jun1okamura/TR-1um_SCLK_SPI/design_notes.md

# TR-1um_SCLK_SPI 設計ノート

最終更新: 2026-09-07

---

## 1. 仕様

SCLKドメイン同期式の**3線式(半二重)SPIスレーブ**コア。既存の
[`TR-1um_I2C_2026`](../TR-1um_I2C_2026) / [`TR-1um_Async_I2C`](../TR-1um_Async_I2C)
と同一の外部データインタフェース(`DATA[7:0]`双方向共有パッド + `DIS` + `RSTN`)
を持ち、シリアルプロトコル層だけをI2C→SPIに置き換えた構成。

- **モード**: Mode 0 (CPOL=0 / CPHA=0)、MSBファースト
- **フレーム**: 8bit単発(CS↓ → SCLK×8 → CS↑)。コマンド/アドレスバイトなし、バーストなし
- **半二重**: MOSI/MISOは `SDIO` 1本に統合
- **方向決定**: `DIS`。同じピンが `DATA[7:0]` の方向も決めるため、R/Wビットもコマンドバイトも不要

| DIS | フレーム | SDIO | DATA[7:0] | 動作 |
|:---:|---|---|---|---|
| 0 | WRITE | 入力(マスタが駆動) | **チップが駆動** | 受信バイトを `rx_data` に確定しDATAへ出力 |
| 1 | READ | **チップが駆動**(CS=Low中) | 入力(`tx_data`) | DATAを取り込みSDIOへMSBから送出 |

---

## 2. ピン割り当て

`OSS_FRAME` は16パッド。VDD/VSSを除く信号パッドは14本(P8は存在しない)。
`RING_OSC` は搭載しない。

| パッド | 信号 | 方向 | 説明 |
|---|---|---|---|
| P1 | `SCLK` | 入力 | SPIクロック。本コア唯一のクロック源(`BUFTH`挿入) |
| P2 | `SDIO` | 双方向 | SPIデータ(半二重)。入力パスに`BUFTH` |
| P3 | `CS` | 入力 | チップセレクト(負論理)。フレーム境界を規定(`BUFTH`挿入) |
| P4 | `TEST` | 出力 | `byte_end` — フレーム第8ビット期間中High |
| P5 | `DIS` | 入力 | フレーム方向 + `DATA[7:0]`出力ディセーブル |
| P6 | `DATA[0]` | 双方向 | 汎用データ bit0 |
| P7 | `DATA[1]` | 双方向 | bit1 |
| P9〜P14 | `DATA[2..7]` | 双方向 | bit2〜bit7 |
| P15 | `RSTN` | 入力 | 非同期リセット(負論理) |

物理パッド番号の昇順とbit番号が単調対応(P6/P7=bit0-1、P9〜P14=bit2-7)。
チップレベルTB(`tb_12_chip`)でこの対応を1本ずつ検証済み。

---

## 3. アーキテクチャ

半二重化により**シフトレジスタが1本で済む**のが構成上の要点。

```
          +--- bit_cnt[2:0] (posedge SCLK, CS で非同期クリア)
          |
SCLK --+--+----------------------------------> rx_data ホールド (posedge SCLK)
       |                                             ^
       +--[XOR]--> shift_clk --> 共用シフトレジスタ sr[7:0]
       DIS ^                        |    ^
           |                        |    +--- tx_data[6:0] パラレルロード
           |                        +-------> SDIO 出力 (sr[7])
           +----------------------> msb_done (posedge shift_clk) --> MSB選択
```

- `shift_clk = SCLK ^ DIS`
  - WRITE(DIS=0): `posedge SCLK` — SDIOを取り込む
  - READ (DIS=1): `negedge SCLK` — Mode 0が要求する「立下りで出力更新」を満たす
  - `DIS` はフレーム中静止しているので、この選択がCS=Low中に切り替わることはない
- Mode 0 は最初の立上り前にMSBが確定している必要があり、その時点ではまだクロック
  エッジが存在しない。よって bit7 のみ `tx_data[7]` から出力し、bit6以降はシフト
  レジスタから出す(`sr` は最初の立下り、`bit_cnt==1` でパラレルロード)。
- **`msb_done`**: 上記のMSB選択を `(bit_cnt == 0)` で直接行うと、`bit_cnt` が変化する
  第1・第8**立上り**エッジでSDIOが動いてしまう(§4で検出した不具合)。選択信号を
  `shift_clk` で叩いたFFにすることで、SDIOの遷移を立下りエッジだけに閉じ込め、
  かつバイト境界ごとに再アームして複数バイト転送も維持している。追加コストは
  `DFFRB`×1 + `OR3`×1 − `NOR3`×1 ≈ **+28 Tr(+7等価ゲート)**。
- `bit_cnt` は `CS`=High で非同期クリアされるため、アイドル中にSCLKがフリーラン
  しても次フレームは必ずbit7から始まる。`sr` にゴミが入っても8エッジ後には正しい
  8ビットに置き換わるので無害 — この性質を使って `sr` のCSゲートを省いている。

---

## 4. 検証

I2C版と同じ2段階等価性検証を、変換後ネットリストまで拡張した**3ビュー**構成。
全テストベンチが同一ソースのまま3つのビューに対して実行される。

| ビュー | 対象 |
|---|---|
| RTL | `hdl/spi_slave_sclk.v` |
| NET | `layout/spi_slave_sclk_net.v`(Yosys/ABC合成直後) |
| PNR | `layout/spi_slave_sclk_net_pnr.v`(MUXDFFRB統合 + BUFTH + 行バッファ挿入後) |

```sh
scripts/run_tests.sh                      # 全12本 × 3ビュー
scripts/run_tests.sh tb_05_mode0          # 1本だけ
DUMP=1 scripts/run_tests.sh tb_05_mode0   # 波形(VCD)付き
```

### テストベンチ一覧

| # | ファイル | チェック数 | 内容 |
|---|---|---:|---|
| 01 | `tb_01_reset.v` | 11 | 電源投入時リセット、アイドル時パッド状態、アイドル中/フレーム途中/CS=Low中の非同期リセットと復帰 |
| 02 | `tb_02_write.v` | 20 | WRITEフレーム10パターン(コーナー/ウォーキング)を `rx_data` とDATAパッド両方で確認 |
| 03 | `tb_03_read.v` | 11 | READフレーム10パターン + READが `rx_data` を壊さないこと |
| 04 | `tb_04_bitorder.v` | 32 | MSBファースト検証。両方向のウォーキング1/ウォーキング0 |
| 05 | `tb_05_mode0.v` | 13 | Mode 0エッジ挙動。最初の立上り前のMSB確定、**全立上りエッジでのSDIO安定**、`tx_data` が第1立下りでラッチされ以降無視されること、MOSIが立上りだけでサンプルされること |
| 06 | `tb_06_tristate.v` | 13 | `DIS`×`CS` の全組合せでのSDIO/DATA駆動・Hi-Z、フレーム中の競合が無いこと |
| 07 | `tb_07_idle.v` | 9 | 20µsアイドル保持、SCLKフリーラン耐性、クロック無しCSパルス、5クロックの中断フレーム、9クロック過剰時の挙動と再同期 |
| 08 | `tb_08_multibyte.v` | 10 | CSを下げたままの3/8バイトWRITE、4バイトREAD、バイト間で `tx_data` を変えた場合の再サンプル |
| 09 | `tb_09_clockrate.v` | 16 | SCLK 100kHz〜20MHzのスイープ + デューティ5%/95%の非対称波形 |
| 10 | `tb_10_random.v` | 1 | 200トランザクションのランダム回帰(方向・データ・メッセージ長・アイドル間隔)をゴールデンモデルと照合 |
| 11 | `tb_11_spidev.v` | 20 | ラズパイ `spi-bcm2835` 3線モードのシーケンス再現。`writebytes`/`readbytes` 相当、DIS操作順序、W/R交互、**`xfer2()` 使用時に競合が起きることの負検証**と復帰 |
| 12 | `tb_12_chip.v` | 31 | チップレベル。実パッドP1〜P15を駆動し、DATA 8本のビット対応をワンホット走査で全数検証。TESTパッド、`BUFTH` 経路、P15リセット |
| | **合計** | **187** | **× 3ビュー = 561チェック / 36ラン、全PASS** |

共通のSPI Mode0マスタBFMとスコアボードは `hdl/spi_tb_common.vh`。双方向ネットを
そのままモデル化しているので、パッド競合はXとして検出される。

### 検出した不具合(修正済み)

`tb_05_mode0` が **SDIOが第1・第8の立上りエッジで変化する**Mode 0違反を検出。
`sdio_out` のMSB選択を `(bit_cnt == 0)` で直接行っていたため、`bit_cnt` が更新
される立上りエッジでSDIOが動いていた。マスタは立上りでサンプルするので読み値
自体は正しく、他の11本のテストベンチは全て通っていたが、マスタのホールド時間
マージンを `bit_cnt` のclk-to-Q分しか残さない設計だった。§3の `msb_done` FFを
追加して全遷移を立下りエッジに閉じ込め、解消。

---

## 5. ゲート規模(合成実測)

セル面積は `lef/TR-1um_STDCELL.lef` の **MACRO SIZE**(= 実際のフットプリント)、
トランジスタ数は `TR-1um_Async_I2C/LEF/<cell>.extracted` のMOS素子数
(`lef/cell_info.json`)。合成用Libertyはこの実面積で生成しているので
(`scripts/gen_liberty.py`)、ABCが本物のシリコン面積で最適化する。

> **1等価ゲート = `NAND2` = 4 Tr = 16.2 × 64.8 = 1,049.8 µm²**

⚠ セルのGDSバウンディングボックスはフットプリントではない。全セルが
prBoundaryからx方向に12.6 µm、y方向に4.0 µm はみ出す(隣接セルと重なる
ウェル/インプラント囲み)ため、GDS実測だと `INV_X1` が 1,610 µm² に見えるが
LEFの正は 700 µm²。面積系の数字はすべてLEF基準に統一してある。

### 工程ごとの推移

| 工程 | セル | Tr | 等価ゲート | 面積 (µm²) |
|---|---:|---:|---:|---:|
| 合成直後 (`_net.v`) | 49 | 796 | 199 | 135,768 |
| MUXDFFRB統合 (`_net_merged.v`) | 34 | 796 | 199 | 135,769 |
| **BUFTH+行バッファ (`_net_pnr.v`)** | **41** | **844** | **211** | **146,267** |

MUXDFFRB統合は `MUX2`+`DFFRB` の15ペアを統合(トランジスタ数不変、面積 −13,005 µm²)。
残る `MUX2`×1 は `sdio_out` のMSB選択で、DFFのDピンを駆動していないため対象外。

### 最終構成(配置配線投入時)

| セル | 個数 | Tr | 面積 (µm²) |
|---|---:|---:|---:|
| `MUXDFFRB` | 15 | 570 | 94,479 |
| `DFFRB` | 5 | 130 | 20,995 |
| `BUF_X2`(行バッファ) | 4 | 24 | 4,199 |
| `AND2_X1` | 3 | 18 | 4,199 |
| `BUFTH`(SCLK / SDIO / CS) | 3 | 24 | 6,298 |
| `INV_X1` | 2 | 4 | 1,400 |
| `NOR4` | 2 | 16 | 3,499 |
| `NAND2` | 2 | 8 | 2,100 |
| `XOR2` | 2 | 20 | 3,499 |
| `OR3` | 1 | 8 | 1,750 |
| `MUX2` | 1 | 12 | 2,100 |
| `XNOR2` | 1 | 10 | 1,750 |
| **合計** | **41** | **844** | **146,267** |

> この表は **option C(`sdio_oe_n` をアクティブLOW化)後の再合成**を反映した
> もの。`NOR2`×2 が消えて `NAND2`×2 / `AND2_X1`×3 になり、トランジスタが
> 842 → 844、等価ゲートが 210 → 211 に動いている(§16.6)。数字は
> `scripts/gate_count.py layout/spi_slave_sclk_net_pnr.v` の出力そのもの。

記憶素子 20個。行バッファは2行構成(§12)で、実配置で得た行割り当てを
`scripts/insert_row_buffers.py --row-assignment` に戻した2パス目の結果(§13.2)。

> ### 結論
> **等価ゲート 211 / トランジスタ 844 / 論理セル 41個 / 記憶素子 20個 /
> 論理セル面積 0.146 mm²**
>
> 配置配線まで完了した**実際のコア面積は 1,632.6 × 314.1 µm = 0.5128 mm²**
> (§14.4)。

---

## 6. I2C版との比較

| 項目 | SPI版 | I2C版(実測) | 比 |
|---|---:|---:|---:|
| 論理セル数 | 41 | 126 | 0.33 |
| 記憶素子数 | 20 | 36 | 0.56 |
| トランジスタ数 | 844 | 1,598 | 0.53 |
| **等価ゲート数** | **211** | 400 | 0.53 |
| 論理セル面積 | 0.146 mm² | 0.299 mm² | 0.49 |
| **配置配線後コア面積** | **0.5128 mm²** | 1.533 mm² | **0.33** |

いずれもLEFのMACRO SIZE基準。コア面積は両者とも実際の配置配線結果。

**約半分**に収まる。差分の内訳:

- SPIは `CS` がフレーム境界を明示するため、I2Cのプロトコル層 — START/STOP検出、
  ACK/NACK生成・応答、7bitアドレス比較器、スパイクフィルタ、SDAオープンドレイン
  制御 — が**まるごと不要**。I2C版で `NAND2` 23個・`NOR2` 14個を要したのはこの
  非同期プロトコル層。
- 半二重化により**シフトレジスタが1本で済む**(全二重ならRX/TXで2本必要)。
- I2C版が非同期(クロックレス)設計だったのに対し、SPI版は `SCLK` 単一ドメインの
  純同期設計。レース対策のための冗長な論理が不要。

---

## 7. 見積もり履歴

| 版 | 構成 | 等価ゲート | Tr | 根拠 |
|---|---|---:|---:|---|
| 初版 | I2C同等I/F、コマンド+データ2バイト | 約 400 | — | 汎用的な机上見積もり |
| 2版 | 全二重、8bit単発、`DATA`+`DIS` | 約 270 | 1,070 | I2C実チップのセル実測でキャリブレーション |
| 3版 | 半二重3線 | 約 210 | 834 | RTL机上構成 |
| 4版 | 半二重3線 + Mode0修正 + BUFTH/行バッファ(4行) | 212 | 850 | 合成〜P&R投入ネットリストの実測値 |
| 5版 | 同左、2行構成 + `BUF_X2` | 210 | 842 | 配置配線まで完了(option C 前) |
| **確定** | **同左 + `sdio_oe_n` アクティブLOW化(option C)** | **211** | **844** | **§16.6 で再合成した最終ネットリスト** |

---

## 8. 設計上の注意点

- **`DIS` はCS=Low中に変化させてはならない。** `shift_clk = SCLK ^ DIS` のため、
  フレーム途中で `DIS` が変わるとシフトレジスタのクロックにグリッチが乗る。
  CS=High中の変化は無害。
- **READ時の `tx_data`(DATAピン入力)はフレーム中に安定していること。**
  bit7 のみ組合せ経路で出力するため、CS↓から最初の立下りまでの間に `tx_data[7]`
  が変化すると誤ったMSBが出る(`tb_05_mode0` で検証)。
- **クロックネットは2本**(`SCLK` と `shift_clk`)。AP&R時の行分配は両系統に必要。
  現状の暫定ネットリストでは各4行 = `BUF_X1`×8。
- `BUFTH` は `SCLK` / `SDIO`(入力パス) / `CS` に挿入(`scripts/insert_bufth.py`)。
- `CS` は `SCLK` に対して非同期。`bit_cnt` の非同期クリアに使い、ロードおよび
  `rx_data` 更新自体はSCLKエッジで行う。最終SCLKエッジからCS↑までのホールド時間は
  実機仕様として規定が必要。
- `TEST`(P4)の `byte_end` は `bit_cnt` のデコード出力なので、カウンタ遷移時に
  短いグリッチが乗りうる。オシロでのフレーム確認用途に限る。
- Liberty はプレースホルダ。**面積・ゲート規模の見積もり専用**であり、タイミング
  値はダミーなのでSTAには使えない。

---

## 9. ディレクトリ構成

| ディレクトリ | 内容 |
|---|---|
| `hdl/` | コアRTL、チップトップ、セルモデル、共通BFM(`spi_tb_common.vh`)、テストベンチ12本 |
| `lef/` | `TR-1um_STDCELL.gds` / `.lef`(TR-1um_Async_I2Cからコピー)、`TR1um_5_stdcell.lib`(I2C版参照用)、`TR1um_5_stdcell_area.lib`(実面積版、生成物)、`cell_info.json` |
| `layout/` | 合成後NET、各変換段のNET、`synth.ys`(生成物)、以降の配置配線中間成果 |
| `irsim/` | IRSIM検証(未着手) |
| `scripts/` | 合成・ネットリスト変換・規模レポート・検証実行。詳細は [`scripts/SCRIPTS.md`](scripts/SCRIPTS.md) |
| `src/` | **TO(テープアウト)提出用** `tr_1um_3wire_SPI.gds` / `.cir` |
| `docs/` | `info.md` データシート、チップ画像 |

```sh
scripts/build.sh        # 合成 → MUXDFFRB統合 → BUFTH → 行バッファ → 規模レポート
scripts/run_tests.sh    # 全テストベンチ × 全ビュー
```

---

## 10. Raspberry Pi からの接続(Pi 4以前 / チップ3V動作)

### 10.1 ラズパイ側の3線SPI対応状況

`raspberrypi/linux` の `rpi-6.12.y` のドライバソースで確認(2026-09時点)。

| モデル | SPIコントローラ / ドライバ | `SPI_3WIRE` |
|---|---|---|
| **Pi 4 / 3 / Zero など(BCM2835〜BCM2711)** | SPI0 / `spi-bcm2835` | **対応** |
| Pi 5 (RP1) | `snps,dw-apb-ssi` / `spi-dw` | 非対応 |

- `spi-bcm2835.c`: `BCM2835_SPI_MODE_BITS = (SPI_CPOL｜SPI_CPHA｜SPI_CS_HIGH｜SPI_NO_CS｜SPI_3WIRE)`
- 双方向モードでは **MOSIピン(GPIO10 / ヘッダ19番)が MOMI**(単線データ)として
  働き、MISO(GPIO9)は未使用。受信時にドライバがCSレジスタの **REN** ビットを
  立てて送信ドライバをHi-Zにする。
- **制約**: `spi_transfer` の `tx_buf` と `rx_buf` は一方が必ず NULL でなければ
  ならない。`spidev_test.c` がこれを守らず3線モードで失敗するのは既知。
  → **本チップは `DIS` がフレーム方向を決めるため、この制約に完全に合致する。**

| | DIS | spidev | REN | 線の駆動 |
|---|:---:|---|:---:|---|
| WRITE | 0 | `writebytes()` | 0 | ラズパイのMOSIが駆動 |
| READ | 1 | `readbytes()` | 1 | MOSIはHi-Z、チップが駆動 |

DMA有効時に3線が壊れる不具合が2019年にあったが(`spi_map_msg()` がNULLの
`rx_buf` をダミーバッファに置換するため)、`master->dummy_rx` を除外する修正が
4.14以降のstableにバックポート済み。

### 10.2 結線 — レベル変換は不要

チップを**3V系で動かせるため、レベル変換器は一切不要**。

> **最も安全な構成: チップの VDD をラズパイの 3.3V レール(ヘッダ1番/17番)から
> 給電する。** 両者が同一電位になるので、入出力とも直結でよい。

チップを3.0Vなど3.3Vより低い電圧で動かす場合の注意:

- **ラズパイ → チップ**: 3.3V出力がVDD(3.0V)を0.3V超える。ESD保護ダイオードの
  順方向電圧(約0.6V)には届かないので通常は問題ないが、マージンを取るなら
  ラズパイ側出力に直列1kΩを入れる。
- **チップ → ラズパイ**: 3.0V出力はBCM2835のVIH(約2.3V)を十分上回るので問題なし。

| ラズパイ | ヘッダ | チップ | 備考 |
|---|---|---|---|
| GPIO11 / SCLK | 23 | P1 `SCLK` | |
| GPIO10 / MOSI(**MOMI**) | 19 | P2 `SDIO` | 3線モードではここが単線データ |
| GPIO9 / MISO | 21 | — | 3線モードでは**未使用** |
| GPIO8 / CE0 | 24 | P3 `CS` | spidevがフレーム毎にアサート |
| 任意GPIO(入力) | — | P4 `TEST` | デバッグ用、省略可 |
| 任意GPIO(出力) | — | P5 `DIS` | ioctlの前に設定 |
| 任意GPIO ×8 | — | P6,P7,P9〜P14 `DATA[7:0]` | WRITE時は入力設定、READ時は出力設定 |
| 任意GPIO(出力) | — | P15 `RSTN` | |
| 3.3V | 1 / 17 | VDD | |
| GND | 6 / 9 / … | VSS | 複数点で接続 |

- `SDIO` に弱プルダウン(100kΩ程度)を入れ、`DIS`=1 かつ `CS`=High で誰も駆動
  しない期間のフローティングを避ける
- 必要GPIOは14本。40ピンヘッダで十分足りる

### 10.3 spidev からの操作

```python
import spidev
from gpiozero import DigitalOutputDevice

spi = spidev.SpiDev(); spi.open(0, 0)
spi.mode          = 0b00       # Mode 0
spi.bits_per_word = 8
spi.threewire     = True       # SPI_3WIRE (Pi 4以前のみ)
spi.max_speed_hz  = 100_000    # まず低速から

dis = DigitalOutputDevice(<GPIO>)

# WRITE : DIS=0 にしてから 1バイト送る -> DATA[7:0] に出る
dis.off(); spi.writebytes([0xA5])

# READ  : DIS=1 にしてから 1バイト読む <- DATA[7:0] の値が返る
dis.on();  val = spi.readbytes(1)[0]
```

- `writebytes` / `readbytes` はそれぞれ片方向の `spi_transfer` になるため、
  3線モードの tx/rx NULL 制約を自然に満たす。**`xfer` / `xfer2`(全二重)は
  使わないこと** — 使うとREADフレーム中にマスタがSDIOを駆動してチップと競合する
  (`tb_11_spidev` の負検証で確認済み)。
- `DIS` の変更は `CS` がHighの間に行う(§8)。ioctlの前後でGPIOを操作すれば
  この順序は自然に守られる。
- CE0 は1バイト転送につき8クロック分だけLowになり、フレーム定義と一致する。

### 10.4 複数バイト転送(CSを下げたまま)

spidev に2バイト以上渡すと `CS` を下げたまま 8N クロックが出る。本設計は
`bit_cnt` がラップして次フレームに入るため正しく動作する(`tb_08_multibyte`)。

| 操作 | 結果 |
|---|---|
| CS Lowのまま3バイトWRITE `11 22 33` | `rx_data` = 最後のバイト `0x33` |
| CS Lowのまま4バイトREAD | 全バイトとも `tx_data` の値(フレームごとに再サンプル) |
| バイト間で `tx_data` を変更 | 次バイトから新しい値が出る |

### 10.5 クロック速度

1µmプロセス・3V動作なので **100kHz程度から始めて段階的に上げる**。参考として
I2C版チップのリング発振器実測は5V時に97段で6.5MHz(段遅延 ≒ 0.79ns)。3V動作では
これより遅くなる。BCM2835 のSPIクロックは分周比が2の冪なので、`max_speed_hz` の
設定値そのままにはならない。RTLは100kHz〜20MHzで検証済み(`tb_09_clockrate`)。

---

## 11. STDCELLへの追加提案

> 優先度1の `BUF_X2` は 2026-09-07 に実装済み。実測結果は §12.1 参照。

現行の `TR1um_5_stdcell` は論理セル25種(`INV_X1` `BUF_X1` `BUFTH` `AND2/3/4_X1`
`OR2/3/4` `NAND2/3/4` `NOR2/3/4` `XOR2` `XNOR2` `MUX2` `DEL1/2/4` `DFFRB` `DFFS`
`RSLATCH` `MUXDFFRB`)。本設計の合成結果から、以下を優先度順に提案する。

### 優先度1: `BUF_X2` / `BUF_X4` / `INV_X2` / `INV_X4` — ドライブ強度の系列

**現行ライブラリにはX1しか無い。** 本設計はクロックネットが2本(`SCLK` と
`shift_clk`)あり、各行の `MUXDFFRB` のCKピン群と長いM2配線を `BUF_X1`(4 Tr)
1個で駆動することになる。1µm・3V動作ではこれが**最大SCLK周波数と行間スキューを
直接律速する**。X2/X4があれば1行1段で済み、バッファ段数と行間スキューの両方が
減る。面積コストも小さい(X2で+2〜4 Tr程度)。

**本チップで最も効く追加。** AP&R前に用意できるのが理想。

### 優先度2: `DFFRB_Q` / `MUXDFFRB_Q` — QB出力を持たないFF

合成結果を実測したところ、**20個のFFのうち17個で `QB` がどこにも接続されていない**。
QB用の出力インバータを削ったバリアントを用意すれば、1個あたり約2 Tr・幅5µm程度
(≒371 µm²)が浮く。17個で **約6,300 µm²、コア面積の約3%、等価ゲート換算で約8ゲート**
の削減。既存セルからインバータを1段落とすだけなので、設計コストも低い。

### 優先度3: `NAND2B` / `NOR2B` — 片側入力反転の2入力ゲート

`NAND2`/`NOR2` と同じ4 Trで、片方の入力だけがバブル付き。**実測**: これらを
Libertyに追加して再合成したところ、ABCが `NOR2B` を4個使い、
セル 34→33個、Tr 794→788、面積 173,244→170,890 µm²(−1.4%)になった。
本設計では小幅だが、追加コストがゼロ(同じトランジスタ数)なので入れて損はない。

### 優先度4: `AOI21` / `OAI21` / `AOI22` / `OAI22` — 複合ゲート

**現行ライブラリには複合ゲートが1つも無い。** これはCMOS標準セルライブラリとしては
大きな欠落で、ABCの技術マッピングが本来最も得意とする形が使えていない。
`AOI21`(6 Tr)は `AND2_X1`+`NOR2`(10 Tr)を置き換える。

ただし**本設計での実測利得はゼロだった** — 組合せ論理が11セルしかなく、ABCは
`NOR2B` の方を選んだ。効いてくるのは組合せ論理を持つ将来の設計(ALU、比較器、
カウンタチェーン等)。**今回のテープアウトのためというより、ライブラリ整備として**
の提案。

### 優先度5: `XOR2_CLK`(または `CLKMUX2`) — クロック経路用

本設計は `sclk ^ dis` を**クロック経路に置いている**。汎用 `XOR2` はA→YとB→Yの
遅延が非対称で、立上り/立下り遅延も揃っていないため、`shift_clk` のデューティ
歪みになって現れ、最大SCLKを制限する。入力間で遅延を揃え、ドライブを上げた
クロック用XOR(または等価なクロックMUX)があると素直。

### 優先度6: `TIEHI` / `TIELO`

未使用入力を電源レールに直結せずに固定するための標準セル。I2C版では
`add_hiz_vss_ties_v9.py` でレイアウト側に処理を寄せているが、セルがあれば
ネットリスト段階で扱えてアンテナ/ESD上も素直になる。

---

## 12. 配置 — 行数の検討

### 12.1 BUF_X2(2026-09-07 実装)

`lef/TR-1um_STDCELL.gds` に追加された `BUF_X2` をGDSから実測:

| | フットプリント | 段構成 | PMOS 合計W | NMOS 合計W | Tr |
|---|---|---|---:|---:|---:|
| `BUF_X1` | 16.2 × 64.8 µm | 10.2/3.4 → 10.2/3.4 | 20.4 µm | 6.8 µm | 4 |
| `BUF_X2` | 16.2 × 64.8 µm | 10.2/3.4 → **10.2/3.4 ×2並列** | 30.6 µm | 10.2 µm | 6 |

出力段が2フィンガ並列になり **W が2倍**。**フットプリントは `BUF_X1` と同一**
なので、行バッファを `BUF_X2` に置き換えても面積は1セルも増えない。
`scripts/build.sh` の既定を `ROW_BUF_CELL=BUF_X2` にした。
`BUF_X4` / `BUF_X16` はLEFには登録済みだがGDSには未実装。

### 12.2 行数の比較

行幅を **I2C版と同じ 1620 µm に固定**して検討した(GIO⇔コアの結線枠組みを
I2C版からそのまま引き継げるため)。`scripts/explore_rows.py --row-width 1620`。

セル総幅は 2,251.8 µm(2行構成のネットリスト)なので、**1行(1,620 µm)には
入らず、2行が最小**。行幅を固定すると余りはFILLになるだけなので、行数を
増やすほど面積は単調に悪化する:

| 行数 | 行容量 | セル総幅 | コア W×H | 面積 | 備考 |
|---:|---:|---:|---|---:|---|
| 1 | 1,620 µm | 2,251.8 µm | — | — | **入らない** |
| **2** | **3,240 µm** | **2,251.8 µm** | **1,620 × 254 µm** | **0.411 mm²** | **採用** |
| 3 | 4,860 µm | 2,284.2 µm | 1,620 × 351 µm | 0.569 mm² | 分割すると3行目が空になる |

3行を指定しても、分割器は行容量に余裕があるため実質2行に詰めてしまう
(3行目の占有率0%)。**2行で決まり。**

#### 2行構成の詳細

行内の配分は2通り比較した(コア高さはどちらも 254 µm で同じ):

| | 行0 / 行1 の幅 | 占有率 | チャネル(トラック) | 最大チャネル |
|---|---|---|---|---:|
| バランス配置(推奨) | 961.2 / 1,290.6 µm | 59% / 80% | 7 / 6 / 10 | **10 trk** |
| 詰め込み配置 | 1,555.2 / 696.6 µm | 96% / 43% | 13 / 6 / 4 | 13 trk |

**バランス配置を推奨。** 面積は同じで最大チャネルが 13→10 トラックに減り、
かつ各行に 300〜650 µm の空きが残るのでルータのジョグ・フィードスルーに
余裕ができる(占有率96%の行は逃げ場が無い)。

- コア: **1,620 × 254 µm = 0.411 mm²**(行 2×64.8 = 129.6 µm + チャネル
  38 / 32 / 54 µm)
- I2C版コア 1,632.6 × 938.9 = 1.533 mm² の **27%**。**幅が一致する**ので
  GIO⇔コアの結線・電源メッシュの枠組みをそのまま流用できる
- FILL 必要量は計 988 µm 分(≒ 64,000 µm²)
- アスペクト比 6.4:1 と扁平。2.5×2.5 mm フレーム内では上下に大きく空きが
  出るので、ロゴ等の配置余地は十分

#### ⚠ クロック分配の確認事項

2行構成では、1つの行バッファが**最大 1.29 mm の行全体**のFFクロックピンを
駆動する。ざっくり見積もると M2 配線容量が 6個のCKゲート容量と同等かそれ
以上になり、**クロック枝は配線容量支配**になる。`BUF_X2`(出力段
W=20.4/6.8 µm)で足りるかはレイアウト抽出後のSPICEで確認すべき項目。
足りなければLEFに登録済みの `BUF_X4` を実装するのが素直
(フットプリントが `BUF_X1` と同じなら面積増もゼロ)。

### 12.3 現状のP&R投入ネットリスト

`layout/spi_slave_sclk_net_pnr.v` — **41セル / 844 Tr / 211等価ゲート /
論理セル面積 0.146 mm²**、`BUFTH`×3 + `BUF_X2`×4(2行 × クロック2系統)。
全36テストランPASS済み。`scripts/build.sh` の既定は `ROWS=2`。

行バッファの配分は現状「シンクを2等分」の暫定値。実配置で行割り当てJSONが
得られたら次で入れ直す:

```sh
scripts/insert_row_buffers.py layout/spi_slave_sclk_net_bufth.v \
    layout/spi_slave_sclk_net_pnr.v --nets sclk_buf,shift_clk \
    --cell BUF_X2 --row-assignment layout/row_assignment.json
scripts/run_tests.sh
```

---

## 13. 配置(Placement)

`scripts/place.py`。配置規約はI2C実チップのGDS
(`TR-1um_I2C_2026/src/tr_1um_i2c_slave_async.gds`)を解析して実測した:

- セルは **prBoundary(レイヤ235/0、全セルで 0..W × 0..64.8)でアバット**。
  GDSのbboxはprBoundaryからx方向に12.6µm、y方向に4.0µmはみ出す(隣接セルと
  重なるウェル/インプラント囲み)ので、配置座標はprBoundary基準
- 全参照が **回転0・反転なし**。行のミラーリングはしない
- 各行は **x=0 から行幅ちょうどまで隙間なく充填**
- **TAP2 は x = 0 / 534.6 / 1069.2 / 行幅−10.8** の固定位置(ピッチ534.6µm)
- 残りは FILL3(16.2)/ FILL2(10.8)で埋める。**FILLは行内に分散配置**
  (ルータのフィードスルー・ジョグ用の隙間を確保するため)

FILL2/FILL3 では 5.4µm ちょうどの隙間だけが作れないため、配置器はセルを
セグメントに詰める際「残りが 5.4µm になる置き方」を避けて次セグメントへ送る。

### 13.1 STEP構成(各STEPのGDSを残す)

| STEP | 内容 | 成果物 |
|---|---|---|
| step1 | 行割り当て(FM分割)。セルをx=0からアバット | `layout/step1/place_step1_rows.gds` / `.json` |
| step2 | 行内順序最適化(バリセンタ反復、HPWL評価) | `layout/step2/place_step2_ordered.gds` / `.json` |
| step3 | TAP2挿入。セルをTAPセグメントに詰める | `layout/step3/place_step3_tap.gds` / `.json` |
| step4 | FILL分散挿入で行幅を厳密に1620µmへ(**最終**) | `layout/step4/place_step4_fill.gds` / `.json` |

`layout/placement_steps.png` に4STEPの可視化(目視確認用)。

### 13.2 2パス実行

行バッファは最初「シンクをN等分」で入れてあるため、1パス目の配置で得た
実際の行割り当てで入れ直し、2パス目を回す(I2C版 `design_notes.md` §40 と
同じ考え方)。

```sh
scripts/place.py                                    # 1パス目
scripts/insert_row_buffers.py layout/spi_slave_sclk_net_bufth.v \
    layout/spi_slave_sclk_net_pnr.v --nets sclk_buf,shift_clk \
    --cell BUF_X2 --row-assignment layout/row_assignment.json
scripts/run_tests.sh                                # 等価性再確認(36ラン)
scripts/place.py                                    # 2パス目
scripts/verify_placement.py
```

2パス目でチャネル交差が [11,6,6] → [10,5,7]、コア高さが 286.2 → **280.8 µm**
に改善した。

### 13.3 結果

| | |
|---|---|
| コア | **1,620.0 × 280.8 µm = 0.4549 mm²** |
| 行 | 2行 × 64.8 µm、y = 64.8 / 167.4 |
| チャネル | 12 / 7 / 9 トラック = 64.8 / 37.8 / 48.6 µm(ガード2トラック込み) |
| 行0 | 論理セル21個 1,026.0 µm (63.3%) + TAP 43.2 + FILL 550.8 |
| 行1 | 論理セル20個 1,225.8 µm (75.7%) + TAP 43.2 + FILL 351.0 |
| HPWL | 12,255 µm(step1の21,597 µmから43.3%改善) |
| GDS実寸 | 1,632.6 × 280.8 µm(**I2C版コアの幅1,632.6 µmと一致**) |

`scripts/verify_placement.py` の全チェックPASS:
インスタンス被覆(41個、過不足・重複なし)、行内アバット(重なり・隙間ゼロ)、
5.4µmトラックグリッド整合、行幅厳密一致、TAP位置、行のy重なりなし、
GDS参照数(107)と実寸の突き合わせ。

I2C版コア(1,632.6 × 938.9 = 1.533 mm²)の **29.7%**。幅が一致するので
GIO⇔コアの結線・電源メッシュの枠組みをそのまま流用できる。

---

## 14. 配線(Routing)

I2C版(`TR-1um_Async_I2C/script/`)のフローをそのまま使う。あちらは実機
KLayoutでチップ全体DRC/LVSクリーン、SPICEトランジスタレベル検証14/14 PASS
まで到達しているので、**アルゴリズムには一切手を入れない**方針とした。
移植の詳細は [`scripts/PORTING.md`](scripts/PORTING.md)。

- `scripts/i2c_ref/` … I2C版からの**無改変**コピー(23本、参照用)
- `scripts/*.py` … `scripts/port_i2c_scripts.py` が生成する本プロジェクト版
- 変更は全て置換ルールとして `port_i2c_scripts.py` に記述(直接編集しない)

変更したのは (1) ハードコードされた絶対パス → `scripts/spi_config.py` 経由、
(2) トップセル名、(3) `LEF/` → `lef/`、(4) `route_top_pins_nrow_fm.py` の
4行決め打ちをN行に一般化(`n_rows == 4` では原本と完全に同一挙動)の4点のみ。

配置JSONは `scripts/gen_placement_json.py` が `place.py` の step4 出力を
ルータのスキーマ(LEFピン矩形の絶対座標化 + ネット解決)に変換する。
TAP直後のFILL2を `FILLPRI_*` と命名して優先M2コリドーに指定している。

### 14.1 ステージ構成(各STEPのGDSを残す)

| STEP | 内容 | 成果物 |
|---|---|---|
| step5 | 配置GDS + チャネル注釈 | `layout/step5/route_step_1_placement.gds` |
| step6 | チャネル配線。ルータ内部の5パスも各々GDS化 | `layout/step6/route_step_2_{1_tap_power_mesh,2_pass0_per_row_local,3_pass1_high_fo_row_only_adjacent,4_pass2_spanning,5_pass3_force_jog_nets,routed_raw}.gds` |
| step7 | 短絡のリップアップ/再配線 | `layout/step7/route_step_3_ripup_reroute.gds` |
| step8 | トップレベルピンのコア端引き出し | `layout/step8/route_step_4_top_pins.gds` |
| step9 | VDD/GND チップレベルピン | `layout/step9/route_step_5_power_pins.gds` |
| step10 | チャネル圧縮(未使用トラック除去) | `layout/step10/route_step_6_squeezed.gds` |

```sh
scripts/gen_placement_json.py
scripts/route.py                    # step5〜step10 + DRC/接続性チェック
scripts/plot_layout.py layout/step10/route_step_6_squeezed.gds
```

`layout/routing_steps.png` に可視化。

### 14.2 チャネル予算

ルータのジョグ機構は行またぎ1本ごとに新しいトラックを確保するため、
`place.py` のネット交差数ベースの見積もり(12/7/9トラック)では足りず、
最初の試行はチャネル1で溢れた。I2C版と同じく**広めに取って配線し、
step10で圧縮する**方式にした(`spi_config.py` の `ROUTE_CH_HEIGHTS`)。

| | 配線時の予算 | 使用 | 圧縮後 |
|---|---:|---:|---:|
| channel0(下マージン) | 140.0 µm (26 trk) | 8 trk | 42.8 µm |
| channel1(行間) | 900.0 µm (166 trk) | 25 trk | 138.6 µm |
| channel2(上マージン) | 160.0 µm (29 trk) | 3 trk | 22.6 µm(PIN保護分+3.0) |
| **コア高さ** | **1,329.6 µm** | | **314.1 µm(−76.4%)** |

### 14.3 squeeze の PINレイヤ保護

`squeeze_channels_nrow_fm.py` は配線が使っていないYスライスを削除するが、
原本のままだと**トップ辺のPINマーカーも巻き添えで消える**。マーカーはコア
境界のちょうど上に描かれるため「最後に使われたトラックより上のヘッドルームを
潰す」規則に当たり、高さ0になっていた(下辺のマーカーはy=0からコア内側へ
描かれるので無傷)。ラベルもピン形状から外れ、`gen_lef.py` / LVS抽出の
「PIN形状の内側にテキストラベルがある」規約が壊れる。18個が該当した。

`build_y_map` に**保護Y区間**を追加して解決した(`scripts/port_rules.py` の
`SQUEEZE_PIN_PROTECT`)。トップセル自身のPINレイヤ(48/1, 49/1)とテキスト
レイヤ(48/0, 49/0)が占めるY区間を収集・マージし、潰し処理がそこに重なる
部分だけ identity のまま残す。`protect_y` が空なら原本と完全に同一の挙動。

```
protecting 2 Y interval(s) holding PIN markers/labels: 0.0-3.0, 1326.6-1329.6
core height: 1329.6 um -> 314.1 um (-1015.5 um, -76.4%)
```

保護分の3.0 µmだけコアが高くなる(311.1 → 314.1 µm)。検証結果:
PINマーカーは**全32個が 3.0 × 3.0 µm**、潰れたもの0、
どのPIN形状にも入っていない/中心からずれているラベル**0**。

### 14.4 結果

| | |
|---|---|
| **最終GDS** | `layout/step10/route_step_6_squeezed.gds` |
| **コア** | **1,632.6 × 314.1 µm = 0.5128 mm²** |
| DRC | **0違反**(M1/M2の幅・間隔、V1の間隔・M1/M2囲み・GC間隔)。実機KLayoutでもANT(アンテナ)以外の指摘なし |
| 接続性 | **全44ネット160ピン 接続OK・短絡0**(M1優先M2フォールバック検証) |
| 配線内訳 | row-only 34、adjacent-pair 4、spanning 0、high-FO 3、per-row-local 3 |
| ジョグ | 14(強制オーバーラップゾーン)、行またぎ0、spanning 0 |
| リップアップ | 生の配線結果が既に短絡0だったため実質何もせず通過 |
| 優先M2コリドー | 6トラック(x = 13.5 / 18.9 / 548.1 / 553.5 / 1082.7 / 1088.1) |
| TAP電源メッシュ | 4列 × 3チャネル × 2ネット(VDD/GND) |
| トップピン | **25ポート全て引き出し・セルピンまで接続確認済み**(§14.5)。12本が下端、13本が上端。PINマーカーは全て 3.0 × 3.0 µm 正方形、TXM2ラベルは中心 |

I2C版コア(1,632.6 × 938.9 = 1.533 mm²)の **35%**。幅が一致するので
GIO⇔コアの結線枠組みをそのまま流用できる。

**生の配線結果でいきなり短絡0・DRC0違反**だったのは、I2C版が多数の
`PER_ROW_LOCAL_NETS` / `FORCE_JOG_NETS` の個別チューニングを要したのと
対照的。本設計は spanning ネットが0(全76ネット中48が行内で閉じ、
クロック2系統は行バッファで行ローカル化済み)であることが効いている。
指定した `PER_ROW_LOCAL_NETS` は `sclk_buf` / `shift_clk` / `cs_n_buf` の
3本のみ、`FORCE_JOG_NETS` は空。

### 14.5 スカラーポート未引き出しの修正(解決済み)

**症状**: 最終レイアウトで `BUFTH` の入力が配線されていない。調べると
BUFTH に限らず、**スカラーのトップレベルポート9本がまるごと引き出されて
いなかった**(バス16本のみ通っていた)。`sclk` / `cs_n` / `sdio_in` は
`u_bufth_*` の A ピンのネットなので、BUFTH入力の未配線はその一部だった。

**原因**: `scripts/highlight_top_pins_nrow_fm.py`(`route_top_pins_nrow_fm.py`
の `gather_pins` が使う)に**I2C設計のポート名が直書き**されていた。

```python
SCALAR_PORTS = ["rst_n", "scl", "sda_in", "sda_oe", "rx_valid",
                "addr_match", "rw", "busy"]
BUS_PORTS    = {"tx_data": 8, "rx_data": 8}
```

`gather_pins` はこの2つに載っているポートしか探さない。本設計のスカラー
ポート名は1つも含まれず、`BUS_PORTS` だけがたまたま一致していたため
「バスだけ通る」症状になった。移植時に**行数**依存は一般化したが、
**ポート名**依存を見落としていた。

**修正**: `port_rules.py` の `HIGHLIGHT_PORTS_FROM_NETLIST` で、この4つを
**ネットリストのポート宣言から導出**するよう置き換えた(`PORTING.md` §5)。
`assign port = net;` の別名も拾う — スカラーは `netlist_parser` の union-find
リゾルバが解決するが、バスの別名はビットごとの展開が必要なので
`BUS_PORT_NET_ALIAS` に入れる(本設計の `assign rx_data = rx_data_r;` が
まさにこれで、I2C版と同じ形だったのが「バスだけ通った」理由でもある)。
ポート方向 `PORT_DIR` も同じ宣言から導出するようにし、`route.py` の
手書きテーブルを廃止した。

導出結果:

```
SCALAR_PORTS      : byte_end, cs_n, data_oe, dis, rstn, sclk, sdio_in, sdio_oe, sdio_out
BUS_PORTS         : rx_data 8, tx_data 8
BUS_PORT_NET_ALIAS: rx_data -> rx_data_r
```

**再発防止**: 既存の `verify_connectivity_nrow_fm*.py` は**チャネルルータが
記録した44ネットしか見ておらず、スタブ30本(ポート→セルピン1本)が死角**
だった。これがこの不具合が最終GDSまで残った理由なので、
`scripts/verify_port_connectivity.py` を追加した。M1+M2をV1で繋いだ連結成分を
実ジオメトリから作り、各ポートのPINマーカーとそのネットのセルピンが同じ成分に
あることを確認する。`route.py` が step8 直後と step10 の後に自動実行する。

**結果**(再P&R後):

```
step8: 25ポート中12本が下端へ、13本が上端へ引き出し
       ports expected : 25 / pin labels : 27 (VDD/GND込み) / OK
step10: ALL 25 TOP-LEVEL PORTS CONNECTED TO THEIR CELL PINS
        cs_n     -> u_bufth_cs_n.A
        sclk     -> u_bufth_sclk.A
        sdio_in  -> u_bufth_sdio_in.A
```

### 14.6 STDCELL 利用リストと、そこで見つかった2件

`scripts/cell_usage.py` が最終配置から生成する
([`docs/cell_usage.md`](docs/cell_usage.md))。ライブラリ31マクロ中
**使用16種 / 未使用15種**、論理セル41個・844 Tr・146,267 µm²、
物理セル(TAP/FILL)67個・64,035 µm²。

このリストを最終GDSと突き合わせて2件の不具合が出た。

#### (1) LEF の FOREIGN が古く、BUF_X2 の図形が入っていなかった

```
MACRO BUF_X2
    FOREIGN BUF_X1 0.0 0.0 ;
```

`gen_placement_gds_nrow_fm.py` は `macros[type]["foreign"]` で物理セルを
選ぶため、**ネットリストは `BUF_X2` ×4 なのにレイアウトには `BUF_X1` の
図形**が置かれていた。フットプリントが同一なので配置もDRCも配線も何も
気づかず、**LVSで初めて落ちる**類の不具合。`BUF_X2` をGDSに追加した時点で
LEF側が追従していなかった。

`lef/TR-1um_STDCELL.lef` の該当行を修正。`sync_cell_info.py` に
「FOREIGN が MACRO 名と違う」「MACRO に対応するGDSセルが無い」を警告する
チェックを追加した。

> **`BUF_X4` / `BUF_X16` は LEF に MACRO があるのに GDS にセルが無い。**
> 使うと黙って `BUF_X1` になる。実装するかLEFから外すこと。

#### (2) BUF_X2 セル自体のM1間隔違反

FOREIGN を直して `BUF_X2` が本当にレイアウトに入った結果、M1間隔違反が
4件(4インスタンス各1件)出た。セル単体でも再現:

```
BUF_X2: M1 space 1.300 um < 1.400 um  at (x=2.35, y=37.15) cell-local
```

**先に「DRCクリーン」だったのは、(1)のせいで `BUF_X2` の図形が一度も
チップに入っていなかったから**で、このセルは実質DRCを通ったことが
なかった。セル修正後は29セル全てクリーン。

再発防止に `scripts/drc_check_cells.py` を追加した。STDCELLの全セルに
単体でDRC(M1/M2の幅・間隔、V1の間隔・囲み)をかける。**GDSを触ったら回す。**

```sh
scripts/drc_check_cells.py            # 全セル
scripts/drc_check_cells.py BUF_X2     # 1セルだけ
```

修正後の再P&R結果: **DRC 0違反、全ネット接続・短絡0、25ポート全て
セルピンまで接続確認済み、配置とGDSのセル構成が完全一致、`BUF_X2` ×4 が
レイアウトに存在**。

> **§14 の数値は §16.6 の再合成後(`sdio_oe_n` 版)の実測値に更新してある。**
> セル数41は同じ、トランジスタ 842→844、コア高さ 324.9→314.1 µm。

---

## 15. LVS用ネットリスト

実機KLayoutのLVSに渡す**参照回路(schematic側)**を用意した。原則はI2C版と
同じで、**手書きしない**。LVSが照合する相手は「機能検証済みのゲートレベル
NET」でなければ意味がないので、P&Rが実際に食べた
`layout/spi_slave_sclk_net_pnr.v` から機械的に生成する。

```
layout/spi_slave_sclk_net_pnr.v   ゲートレベルNET(配置配線に使ったもの)
lef/TR-1um_STDCELL.spice          セルのトランジスタ実体
layout/placement_nrow_fm.json     FILL2/FILL3 の実配置数
        ↓ scripts/gen_lvs_spice.py
layout/spi_slave_sclk_nrow_fm.spice
```

### 15.1 セルのトランジスタ実体をどこから取るか

I2C版 `gen_lvs_spice_v10.py` はセル実体を `~/.xschem/simulations/` から
読んでいた。ここはリポジトリ外で本プロジェクトからは参照できない。代わりに

```
TR-1um_I2C_2026/src/tr_1um_i2c_slave_async.cir
```

の各 `.subckt` ブロックを**そのまま**抜き出す。これはI2C版のMPW提出netlist
そのもの、つまり同じセルライブラリで、しかも同じ `TR-1um_STDCELL.gds` に
対して実機KLayout LVSが素子単位で一致済みという最強の出所である
(`scripts/gen_cell_spice.py`、出力 `lef/TR-1um_STDCELL.spice` はコミット済み。
`I2C_REF_CIR` で入力パスを差し替え可)。

- **TAP2** … 素子ゼロ(ウェル/基板タップのみ)。`.subckt` を作らない
- **FILL3** … `.subckt` を作らず、トップに素子を直接展開(レイアウト側が
  フラットに抽出されるため)。**FILL2 は逆にサブサーキット呼び出し**にする。
  この非対称はI2C版でLVSが一致した実績のある形をそのまま踏襲したもの
- **BUF_X2** … 本プロジェクトで追加した新セル。I2C版の `.cir` に実体が無い
  ので `gen_cell_spice.py` 内で定義した(§15.2)

### 15.2 BUF_X2 の実体

`lef/BUF_X2.sch` が **BUF_X1 の回路(トランジスタ4個)**になっていた。
`lef/TR-1um_STDCELL.gds` の(DRCクリーンな)BUF_X2 は**6個**ある。

| | PMOS | NMOS | 素子数 |
|---|---|---|---|
| `lef/BUF_X2.sch`(元) | 10.2u × 2 | 3.4u × 2 | 4 |
| `TR-1um_STDCELL.gds` の実体 | 10.2u × 3 | 3.4u × 3 | 6 |

GDSから幾何抽出した接続は、入力インバータ1段(A → net1)＋**出力インバータ
2段を並列**(net1 → Y)。PDK側の KLayout 抽出
(`TR-1um/STDLIB/LogicCells/extracted/BUF_X2.extracted`)も同じ6素子・同じ
接続で、こちらが正。**PDKの回路図
`libs.tech/xschem/*/BUF_X2.sch` は最初から正しく**、出力段を `m=2` の
1素子として描いている。食い違っていたのは本リポジトリに置かれた
`lef/BUF_X2.sch` のコピーだけだった(6素子の等価な形に直してある)。

LVS用の実体はユーザーがxschemから export した
`simulation/BUF_X2.spice` をそのまま使う。

```
.subckt BUF_X2 VDD A Y GND
MM7 net1 A VDD VDD PMOS w=10.2u l=1u
MM1 Y net1 VDD VDD PMOS w=10.2u l=1u m=2
MM3 net1 A GND GND NMOS w=3.4u l=1u
MM2 Y net1 GND GND NMOS w=3.4u l=1u m=2
.ends
```

`m=2` は並列2個の意味で、レイアウトはそれを2フィンガーで描いている。PDKが
自分の回路図とレイアウトを突き合わせている形そのものなので、この綴りを
変えずに使う。`check_cell_spice.py` は `m=` を展開してから比較する
(PMOS総幅 30.6u / NMOS 10.2u で一致)。

**セル実体の出所の優先順位**(`.cir` に無いセルの場合):

1. xschem の export `simulation/<CELL>.spice` — 回路図自身の出力なので一次情報
2. `gen_cell_spice.py` の `LOCAL_BODIES` — exportも `.cir` も無い場合のみ

### 15.3 I2C版から一般化した点

`gen_lvs_spice.py` は本設計固有の値を一切持たない。再合成しても編集不要。

| I2C版 | 本プロジェクト |
|---|---|
| ポート24本を定数リストで直書き | `module` ヘッダと `input`/`output` 宣言から導出(バスはビット展開) |
| セルごとのSPICEピン順を20件の表で保持 | `lef/TR-1um_STDCELL.spice` の各 `.subckt` 行から読む |
| `SCALAR_ALIAS` / `BUS_ALIAS_PREFIX` を手で保守 | `assign` を union-find で解決。スカラー / ビット指定 / バス全体 / 部分選択の4形をビット単位で展開し、**解釈できない `assign` はエラー**にする |
| — | ポート名が正規名として勝つようバイアス。`rx_data_r[6]` ではなく `rx_data[6]` になり、ルータがレイアウトに置いたラベルと一致する |

本設計で実際に解決された別名は11本
(`_33_[2:1] = bit_cnt[2:1]`、`_34_[0] = _33_[0]`、`rx_data = rx_data_r` の
8ビット)。定数タイ(`.A(1'h1)` 形)は本設計には無いがチェックは残してある。

### 15.4 生成結果と事前チェック

```
41セルインスタンス / 27トップポート(信号25 + VDD/GND) / 13セル種
電源ピン82本をレールに強制接続(Verilog側に記述が無いもの)
FILL2 ×10 はサブサーキット呼び出し、FILL3 ×49 は素子98個をインライン展開
```

LVSにかける前に `scripts/check_cell_spice.py` で2種類の突き合わせを行う。

**(1) セル実体 vs GDS幾何** — poly∩activeでゲートを抜き出してW/Lを実測し、
SPICE側と比較する。ここで**素子数は比較しない**。BUFTHは w=10.2u のPMOSと
w=6.8u のNMOSを**2本のフィンガーに折って**描いてあるので、GDS上のゲート形状
は10個、回路図の素子は8個で正しく食い違う。折り畳みで不変な量、すなわち
**PMOS総幅・NMOS総幅・チャネル長の集合**を比較する。

```
ok   AND2_X1    W(P)=  30.6u W(N)=  10.2u  6 device(s)
ok   BUFTH      W(P)=  30.6u W(N)=  17.0u  8 device(s)  (GDS 5/5 fingers for 4/4 devices -- folded)
ok   BUF_X2     W(P)=  30.6u W(N)=  10.2u  6 device(s)
...                                    14セル全一致
```

**(2) インスタンス数 vs 配線後GDS** — `layout/step10` のGDSに置かれた
セル参照を数えてネットリストと突き合わせる。16種すべて一致
(TAP2 ×8 は素子ゼロなのでネットリストに現れないのが正しい)。

### 15.5 xschem のセルexportとの突き合わせ

`layout/step10/simulation`(= `~/.xschem/simulations` へのシンボリックリンク)
が見えるときは、`gen_cell_spice.py` が出力する各セル実体を、xschem 自身が
書き出した `<CELL>.spice` と**素子単位で自動照合**する。回路図側の一次情報は
こちらなので、食い違えばエラーで止まる。

```
cross-check against .../simulations
  ok   AND2_X1     6 device(s)
  ok   BUFTH       8 device(s)
  ok   BUF_X2      6 device(s)
  ok   DFFRB      26 device(s)
  ok   FILL2       2 device(s)  (pin order ['GND','VDD'] vs ['VDD','GND'])
  --   INV_X1     no INV_X1.spice there
  ok   MUX2       12 device(s)
  ok   MUXDFFRB   38 device(s)  (export is hierarchical, flattened to compare)
  ok   NAND2 / NOR2 / NOR4 / OR3 / XNOR2 / XOR2
                              13セル一致
```

想定内の差が2つあり、エラーにはしない。

- **MUXDFFRB** … export は `x1 DFFRB` / `x2 MUX2` を呼ぶ階層形だが、レイアウト
  は1枚のフラットなリーフセルとして描かれている。I2C版と同じ手順(各呼び出しの
  内部ネットに `x1_` / `x2_` を付けて展開)でフラット化してから比較し、38素子
  一致を確認している。階層のまま渡すとKLayout LVSが照合できない
  (I2C版 §108.45 で実際に NoMatch / Skipped になった)
- **FILL2** … export のピン宣言は `GND VDD`、`.cir` は `VDD GND`。同じ回路。
  `gen_lvs_spice.py` は渡された実体の `.subckt` 行からコール順を取るので
  どちらでも安全

export が無いのは **`INV_X1.spice`** の1つだけ(元から無く、I2C版スクリプトも
実体を直書きしていた)。こちらは `.cir` 由来の実体がGDS幾何と一致済み(§15.4)。

`m=N`(並列N個)は照合前に展開する。BUF_X2 の export が出力段を `m=2` で
書いているため(§15.2)。

### 15.6 出力先

```sh
scripts/gen_cell_spice.py        # lef/TR-1um_STDCELL.spice を作る + xschem照合
scripts/gen_lvs_spice.py         # LVS用ネットリストを作る(2箇所へ出力)
scripts/check_cell_spice.py      # GDSと突き合わせ(gdstk必要)
```

`gen_lvs_spice.py` は同じ内容を2箇所に書く。

| 出力先 | 用途 |
|---|---|
| `layout/spi_slave_sclk_nrow_fm.spice` | リポジトリ内の版(コミット対象) |
| `layout/step10/simulation/spi_slave_sclk_nrow_fm.spice` | 実機LVS用。セルのexportと同じディレクトリに置く(I2C版 `OUT_PATH_SIM` と同じ運用)。`--no-sim-out` で抑止 |

LVSにかける組み合わせ:

```
レイアウト側: layout/step10/route_step_6_squeezed.gds  cell spi_slave_sclk_nrow_fm
回路側:       layout/step10/simulation/spi_slave_sclk_nrow_fm.spice
              .subckt spi_slave_sclk_nrow_fm
```

step10のGDSはトップレベルセルが15個ある(STDCELL GDSをマージした際に残った
未使用セルとKLayoutの `$$$CONTEXT_INFO$$$`)ので、**セル名を明示すること**。
トップセルのラベルはレイヤ49/0に41個 — 信号25本 + `VDD` ×8 + `GND` ×8 で、
ネットリストの27ポートと名前が1対1で対応する。

### 15.7 実機LVS結果 — **クリーン**

KLayoutでの実機LVS、**コアセル単体クリーン**(2026-09-07)。抽出結果は
`layout/step10/spi_slave_sclk_nrow_fm.extracted` に保存。

```
.SUBCKT spi_slave_sclk_nrow_fm GND VDD byte_end cs_n data_oe dis rstn
+ rx_data[0..7] sclk sdio_in sdio_oe sdio_out tx_data[0..7]
```

レイアウト側の抽出も27ピン(信号25 + VDD/GND)で、ポート名が参照ネットリストと
1対1で対応している。サブサーキットは13種
(NAND2 / XNOR2 / NOR2 / NOR4 / OR3 / BUFTH / MUX2 / AND2_X1 / FILL2 /
INV_X1 / BUF_X2 / MUXDFFRB / DFFRB)。

これで**コア単体はDRC・LVSともクリーン**。残るANT(アンテナ)は配線長依存
なのでGIO統合後に再確認する。

---

## 16. チップ統合(GIO フレーム)

`TR-1um_Async_I2C/FRAME/TR-1um_frame_25x25.gds` を `lef/` にコピーし、その中の
`OSS_FRAME_GIO`(2,500 × 2,500 µm、16パッド)にコアを落とし込む。**配置のみ**で
配線はしない — I2C版 `assemble_top_v10.py` と同じ区切り方。オフセットが全ての
基準になるので、線を1本も引く前にKLayoutで見て確認する。

```sh
scripts/assemble_top.py          # layout/chip/step1_assembled.gds
scripts/gen_top_routing_plan.py  # layout/chip/*.json
scripts/check_top_channels.py    # チャネル容量の事前確認
scripts/plot_chip_floorplan.py   # layout/chip/floorplan.png
```

### 16.1 コアの位置

| | |
|---|---|
| コア | 1,632.6 × 314.1 µm |
| オフセット | **(-810.0, 515.9)** |
| チップ座標BBOX | (-816.3, 515.9) 〜 (816.3, 830.0) |

**X は選択の余地がない**。コアのネイティブBBOXは -6.3〜1626.3 なので、
オフセット -810.0 でちょうど ±816.3、チップ軸に対称になる。行幅を1620 µmに
固定したのはこのため(§12)。

**Y はチャネル幅から決まる**。リングの最内側の実ジオメトリは ±920.0 の壁で、
配線可能な `P` / `HIZ` / `OUT` 端子はその外側 ±921.7 に並ぶ。上側チャネルを
**90 µm** 取るとコア上辺が 830.0、したがってオフセットは **515.9**。壁までが
90.0 µm、端子までが 91.7 µm — I2C版の「120 µm程度」が実測 121.7 µm だったのと
同じ数え方。

当初は上側も80 µm(オフセット 525.9)だったが、**コアをリングから10 µm離す**
指示により 515.9 へ下げた。5本のコリドーで一番きつかったのが上コリドー
(80 µmの14トラックに12ネット)なので、ここが16トラックになる。コア下側の
チャネルは `PTECT_CHANNEL_UM` という別のノブなので、この移動に引きずられない。

`spi_config.chip_geometry()` がこれを毎回導出する。コア高さが変われば
オフセットも追随するので、座標を書き写した箇所はどこにも無い。

### 16.2 PTECT は「10 µm の隙間」ではなく80 µm のチャネル

コアは1,840 µm の開口部に対して 314.1 µm しかないので、下側の大半が空く。
I2C版と同じく PTECT ボックス(レイヤ 63/1)で埋めるが、**コア底辺との間隔は
I2C版の 10 µm ではなく 80 µm** にした。

I2C版のコアは4行構成で、トップポートを**左右の辺**に出していた(下辺のポートは
ゼロ)。本コアは2行なので、**下辺に12本・上辺に13本**出ている。10 µm では
下辺の12本に逃げ場が無い。

```
PTECT (63/1)  x -800..800,  y -840.0 .. 435.9   (1600 × 1275.9 µm)
```

コア下と PTECT 下はどちらも 80 µm。上だけが 90 µm。

### 16.3 配線コリドー

```
        T  コア上   90.0 µm ─┐
  L 103.7 ┤ コア      ├ R 103.7
        U  コア下   80.0 µm ─┘   (コア底辺 515.9 〜 PTECT上端 435.9)
        B  PTECT下 80.0 µm
```

`T` `R` `B` `L` は閉ループを成す。`U` はそこから生えた枝で、コア下辺のピンは
一旦ここに落ちてから左右のコリドーへ抜ける。

`check_top_channels.py` はこのループを1次元に展開し(I2C版の
「unrolled ring interval」と同じ)、各ネットを最短の弧として重ね合わせて、
コリドーごとに必要なトラック数を数える。ジョグもビアも数えない下限値だが、
**ここで溢れるコリドーは確実に配線できない**。配置は直すのが安いうちに直す。

```
corridor    width  tracks  needed
T            90.0      16      12   ok
R           103.7      19      10   ok
B            80.0      14       5   ok
L           103.7      19       9   ok
U            80.0      14       7   ok
```

一番混むのは上コリドーで16本中12本。80 µmのままだと14本中12本で、下限値
としてはジョグを打つ余地がほとんど無かった。さらに要るなら
`spi_config.TOP_CHANNEL_UM` を上げるだけでよく、コアが下がるだけで下側は
空いている(100 µm→18本 / オフセット 505.9)。

### 16.4 トップ配線の JSON

I2C版と同じ2本立て。**どちらも生成物**で、手で書くのは `PAD_MAP` だけ
(パッド割り当ては設計判断なので、`hdl/tr_1um_3wire_SPI.v` の表 = §2 が原本)。

| ファイル | 内容 |
|---|---|
| `layout/chip/gio_connections.json` | 論理的な接続表。パッドセルの挙動、電源タイ、未接続出力、未解決事項 |
| `layout/chip/signal_routing_plan.json` | ルータ用の実座標。24ネット / GIO端子32点 / コアピン24点 |

パッド端子の座標は `lef/TR-1um_frame_25x25.gds` 自身から読む
(`scripts/frame_pins.py`、42端子)。I2C版は LEF から書き写した表を手で
保守していたが、その写しを無くした。コアピンの座標は配線済みコアのラベルから
読んでオフセットを足す。ポート一覧はネットリストから。全ポートが `PAD_MAP` と
突き合わされるので、**割り当ての抜けはエラーになる**。

### 16.5 パッドセルの極性と DIS チェーン

`OSS_ESD_5V_DIO`(パッド1個につき1個)の挙動:

```
HIZ<n> = 1  ->  出力ドライバOFF、パッドはHi-Z(入力専用)
HIZ<n> = 0  ->  出力ドライバON、パッドは OUT<n> で駆動
```

I2C版がトランジスタレベルで追って確定させたもの(ピン名からの推測ではない)。

この極性のおかげで、**DATA 8本の HIZ は DIS パッドのネットにそのまま繋がる**。
コアがDATAを駆動するのは `data_oe = ~dis = 1`、つまり `dis = 0` のとき。
`HIZ = 0` が「駆動」なので `HIZ = dis` で論理が一切要らない。I2C版も自分の
DISパッドを8本のHIZに同じやり方で繋いでいた。

その結果、コア出力 `data_oe` はチップレベルで**どのパッドにも繋がらない**
(`dis` と同じ情報なので冗長)。

### 16.6 SDIO の出力イネーブルはコア側でアクティブLOWにした

同じ極性が SDIO では逆に効く。当初のコアは

```
assign sdio_oe = dis & ~cs_n;      // アクティブHIGH(1 = 駆動)
```

だったので、`HIZ2` に直結すると動作が反転する。I2C版の `sda_oe` はアクティブ
LOWで直結できていた。選択肢は3つあった。

| | 内容 | 判断 |
|---|---|---|
| A | チップレベルに `INV_X1` を1個追加 | 80 µmチャネル内の単独セルになり、電源レールを電源メッシュに繋ぐ作業が要る |
| B | `HIZ2` にコアの `data_oe` を繋ぐ | 追加セル無しだが、`DIS=1` なら **CS=Highでも** SDIOを駆動してしまう |
| **C** | **コアをアクティブLOWで再合成** | **採用** |

```
assign sdio_oe_n = ~(dis & ~cs_n);   // SDIOパッドのHIZピン: 0 = 駆動
```

反転を出すコストはゼロに近い。元々この信号を作っていたゲートは NOR2 で、
合成後は NAND2 1個(`_58_`)になっただけ。**チャネル内に単独セルを置かずに
済み、チップトップは「パッドリング + コア」だけになる**。

再合成の実測差:

| | 変更前 | 変更後 |
|---|---|---|
| セル数 | 41 | 41 |
| トランジスタ | 842 | 844 |
| 等価ゲート | 210 | 211 |
| コア | 1,632.6 × 324.9 µm | 1,632.6 × **314.1** µm |
| コア面積 | 0.5304 mm² | **0.5128 mm²** |

テストベンチは36ラン全PASS(187チェック × RTL/NET/PNR)。`tb_06_tristate` の
7つの `check1` は期待値を反転してある。DRC 0違反、全ネット接続・短絡0、
25ポート全てセルピンまで接続確認済み。LVS用ネットリストも再生成し、
セル実体14/14・インスタンス数15/15がGDSと一致。

### 16.7 チップトップRTLも実体に合わせた

`hdl/tr_1um_3wire_SPI.v` はシミュレーション用モデルだが、レイアウトが
「`OSS_FRAME_GIO` + コア」だけになったので、**トップレベルにあった余計な
セルを削除**した。

- **`BUFTH` ×3** … `scripts/insert_bufth.py` が**コアの中**に入れている。
  トップにも置いていたので二重バッファになっていた
- **`BUF_X1` ×2**(`sdio_out` / `byte_end` 用) … レイアウトに存在しない

放置するとチップレベルLVSで「回路図にあってGDSに無いセル」が5個出る。
パッドドライバの記述もHIZの極性(`0 = 駆動`)に合わせて書き直した。

### 16.8 配置JSONの取り違えを塞いだ

再P&Rの途中で、`layout/placement_nrow_fm.json` が**前の設計のまま**でルータが
回っていた。`gen_placement_json.py`(`place.py` の step4 出力 → I2C版ルータが
読むスキーマへの変換)が `route.py` の外にある手作業だったため。

症状は分かりにくい: step8 で `sdio_oe_n` のトップピンだけが黙って出てこず、
`check_port_pins` が「25ポート中24」と報告する。**`route.py` の step5 冒頭で
必ず変換を回すようにした。**

---

## 17. トップレベル配線

```sh
scripts/route_chip.py    # layout/chip/step2_routed.gds
scripts/check_chip.py    # DRC差分 / PTECT / 接続性・短絡 / 電源
```

リングエンジンはI2C版のものをそのまま使う。`perimeter_s` / `s_to_xy` /
`ring_waypoints` / `project_to_R` / `seg_layer` / `unroll` は
`scripts/i2c_ref/route_gio_core_v10.py` から**逐語コピー**、レーン詰めの
貪欲区間スケジューリングも同じ。配線は全てマンハッタンで、**レイヤは向きで
決まる — 横がM1、縦がM2**、変わる所に必ずビアが入る。

```
36ルート(信号24 + チェーンリンク12) / リングレーン13本 R 847.0..911.8
Uコリドー 8レーン  y 472.1..509.9  (帯 435.9..515.9)
```

### 17.1 コア下(U)コリドー — I2C版との最大の違い

I2C版のコアはフレームをほぼ埋めていたので、下辺のピンはそのまま真下の
チャネルに落ちてリングに乗れた。本コアは1,840 µmの開口部に314 µmしかなく、
その下は **PTECT(63/1、DRC上あらゆる金属が禁止)** で塞がっている。
**24ネット中11本が下辺ピン**で、横に逃げるしかない。

```
コアピン → M2で真下へ → 自分のUレーンをM1で西(または東)へ
        → コア端を越えて左右コリドーへ → 縦M2でリングへ
```

Uレーンもリングレーンと同じ詰め方をする。**リング区間の始点はコアピンでは
なくリングに乗る点**で取る — さもないと詰め込みアルゴリズムが存在しない配線
を前提に計算してしまう。どちらの端(L/R)に逃がすかは2¹¹通り全探索で
(リングレーン数, Uレーン数, 総延長)を最小化して決める。

### 17.2 電源

4本のTAPカラムはコア下辺から上辺まで**1本の連続したM2ストラップ**である
ことを配線済みコアで直接確認した。片端を叩けばカラム全体に効くので、バスが
両端に届く必要がない。

| | |
|---|---|
| **VDD** | Tコリドーの y=838 に10 µm幅のM1バス(コア上辺830とレーン0の847の間)。上辺のVDD TAPピン4本を束ね、**3.4 µm幅のライザー9本**でレーン帯を越え、y=916 でM1に乗り換えてリング唯一のVDD実ピン(M1、(50,920)-(350,934))へ |
| **GND** | Uコリドーの y=463 に10 µm幅のM1バス。下辺のGND TAPピン4本を束ね、x=∓838 のM2脚2本を**ダイ下方へ下ろして** y=-795 の2本目のM1バスバーに繋ぎ、そこから10 µm幅のM2ストリップ5本でフレームのVSSピンへ(§17.9) |

リングのVDDピン(M1)とVSSピン(M2)は上辺で**設計上重なっている**。ライザーは
そこではM1のままでビアを置かない — これが両者を分けている唯一の仕組みで、
I2C版はここでM2側をVDDのバスだと誤認して一度ショートさせている。

**ライザーが細く本数が多い理由**: ライザーのM1は縦向きなので、レーン帯と同じ
高さにM1があるとレーン(上下辺では横向きM1)を横切ってしまう。乗り換えは帯の
**上**でなければならず、そこは狭い。配線幅と同じ3.4 µmのビアパッドなら段差が
できない — 幅が変わる継ぎ目は実機の幅チェッカーが**ノッチ**として拾う
(I2C版 79.8)。

### 17.3 パッド間チェーンと未使用ピン

端子を複数持つネットは**パッド端子へ1本**引き、残りはパッド間でチェーンする
(I2C版のDISアーキテクチャそのまま)。9端子の `dis` がリングを一周するレーンを
占有せずに済む。チェーンリンクも同じプールで詰めるので、帯を先に区切らない。

`HIZ` の固定タイは、上辺の `HIZ1` / `HIZ15` はVDDバスまでM2で降ろし、左辺の
`HIZ3` / `HIZ5` / `HIZ4` はコア端(816.3)とレーン0(847)の間の私有半径
820 / 825.5 / 831 を使う。

**入力専用パッドの `OUT` ピンは開放にしない** — `OSS_ESD_5V_DIO` の中で実際に
ゲート入力になっている。`OUT1` / `OUT3` / `OUT5` / `OUT15` はそれぞれ
**同じ辺で20 µm隣にあるリングのGND端子**に落とす。当初リングを一周する
チェーンにしていたが、長いルート4本とレーン3本を無駄に食っていた。

### 17.4 検証

`check_chip.py` は3つを幾何から直接確認する(ルータの自己申告は使わない)。

1. **DRC差分** — パッドリングは元から幅・間隔マーカーを数個持っている(既製
   ブロックで、その内部は本プロジェクトが口を出す所ではない)。全ルールを
   配線前後の両方で走らせ、**増えた分だけ**を座標付きで報告する
2. **PTECT** — 63/1 の中のM1/M2/V1/ポリ/拡散
3. **接続性** — KLayoutの `LayoutToNetlist` でM1+M2をV1で繋いで抽出し、
   `probe_net` で各ネットの端点(コアピンと全GIO端子)を引く。**1つのネットに
   まとまっているか**(断線)と、**2つのネットが同じに落ちていないか**(短絡)。
   電源も同様に、コアのTAPピン・リングの実ピン・HIZタイ・未使用OUTが
   VDD/GNDそれぞれ1ネットで、互いにも全信号にも触れていないことを確認

```
DRC差分     M1 space/width 0 new, M2 space/width 0 new, V1 0 new
PTECT       クリーン
接続性      24/24ネット、断線・短絡なし
電源        VDD 9点が1ネット / GND 11点が1ネット / 互いに独立
```

### 17.5 途中で潰したもの

| | |
|---|---|
| **全ネット断線** | 端子への半径方向のホップをリング本体と**別の `path` 呼び出し**で描いていた。ホップはリングが終わった所から始まるので、リングが縦(M2)で来てホップが横(M1)で出ると、その角のビアはどちらの呼び出しの持ち物でもなく誰も置かない。**1ルート=1本のポリライン**に直した。GND脚でも同じ形で再発した |
| **同一レーンでの短絡** | 区間を「全端点を覆う最小の弧」で取っていたため、継ぎ目をまたぐ(ラップする)区間ができ、詰め込みが実在しない位置の配線を前提にしていた。I2C版の規則どおり**非ラップの `[min,max]` を区間とし、向きはその中に収まる方に強制**する形に戻した |
| **VDDライザーがレーンに0.3 µm** | 帯の途中(y=911.5)でM1に乗り換えていた。帯の上(916.0)へ移し、幅もレーンと干渉しない3.4 µmに |
| **`NEAR_R` は障害物ではない** | 端子への半径方向ホップは後続の配線と同一直線上にあるので場所を取らない。最上位レーンが本当に避けるべきなのは**リング内壁(920)** |

---

### 17.6 ボンドパッドのLVSピン

```sh
scripts/add_top_pins.py   # step2_routed.gds -> step3_top_pins.gds
```

LVSはどちらの側でも「誰も宣言していないチップレベルのポート」を名前で扱えない。
参照ネットリスト側は16本のボンドパッドのネットをトップ回路のピンとして並べる
ので、レイアウト側にも同じ宣言を置く。**コアセルおよびI2C版チップと同じ規約**
(`scripts/i2c_ref/add_top_pins_gio_v9.py`)。

```
M2PIN (49,1) に 3.0 × 3.0 µm のボックス
TXM2  (49,0) に ピン名のTEXT(サイズ20 µm)を**ボックス中心**に
```

ラベルは中心に置く — KLayoutのテキスト抽出はラベルがボックスの**中**にある
ことを要求し、ずらして置いたのは過去に実際のバグだった。

パッドの座標と名前は `lef/TR-1um_frame_25x25.gds` から読む。`OSS_PAD`
インスタンスが中心を、その上に載っている `P<n>` / `VDD` / `VSS` ラベルが名前を
与える。I2C版は16個の中心を (-200,1040) から反時計回りに歩いて位置で名前を
割り当てていたが、それはフレームの番号が振り直されない限りでしか正しくない。

書き込む前に、**各中心がトップセルの実M2の上にあること**を確認する。空中に
ピンマーカーを置くと孤立ネットとして抽出され、LVSが実在しないネットを追う。

`check_chip.py` は逆向きにも確かめる — 各パッドピンを抽出結果でプローブして、
**名前が主張するネットに実際に乗っているか**を見る。

```
P1  -> sclk       P6  -> tx_data[0]    P11 -> tx_data[4]
P2  -> sdio_in    P7  -> tx_data[1]    P12 -> tx_data[5]
P3  -> cs_n       P9  -> tx_data[2]    P13 -> tx_data[6]
P4  -> パッドノード単独    P10 -> tx_data[3]    P14 -> tx_data[7]
P5  -> dis        P15 -> rstn          VDD / VSS -> 各レール
```

`P4`(TEST)だけは**コアからの配線が無いのが正しい** — 出力専用パッドで、
パッドノードは `OUT4` からパッドセル内部で駆動される。したがって信号にも
レールにも属さない自分だけのネットであることを確認している。

---

### 17.7 チップレベルのLVS参照ネットリスト

```sh
scripts/gen_lvs_spice_top.py   # layout/chip/tr_1um_3wire_SPI.spice
```

チップは「サブサーキット2個とポートリスト」でしかない。

```
.subckt tr_1um_3wire_SPI P1 P2 P3 P4 P5 P6 P7 VSS P9 P10 P11 P12 P13 P14 P15 VDD
x1  ... OSS_FRAME_GIO            (44ポート、パッドリング。トランジスタレベル)
x2  ... spi_slave_sclk_nrow_fm   (27ポート、コア単体でLVSクリーン済み §15.7)
.ends
```

**ポートが16本なのはレイアウト側が16本だから**(§17.6)。KLayoutの
クロスリファレンスは、参照とレイアウトのポート**数**が一致しないとグラフ照合
自体を試みない。I2C版は一度ここから2本落として、下位27回路が全て一致している
のに**他の全ピンが偽の不一致を連鎖**させる、という壊れ方をしている。

両インスタンスのポート順は各 `.subckt` 行から読む(決め打ちしない)。ネットは
結線マップから導出する。

| | |
|---|---|
| `P<n>` | ボンドパッドのネット = トップレベルポート |
| `HIZ<n>` | それを駆動するもの — レール、コアの `sdio_oe_n`、または **DISパッドのネット(`P5`)**(DATA 8本) |
| `OUT<n>` | そのパッドのドライバに入るコア出力。入力専用パッドの浮く `OUT` はGNDレール(ルータが引いたタイオフと同じ) |
| コアポート | 届く先のパッドネット、または コア↔リング間の内部ネット(`rx_data[i]` / `byte_end` / `sdio_out` / `sdio_oe_n`) |

マップで説明がつかないポートは**それぞれ固有の `NC_*` ネット**にする。まとめて
1本にすると、実際には別々に浮いているピン同士をLVSがショートと見なす。本設計で
出るのは `data_oe` の1本だけ(§16.5)。

### 17.8 参照ネットリストをレイアウトに突き合わせる

`check_chip.py` の最後で、**参照ネットリストが同じネットに繋いでいる点が、
抽出したレイアウトでも本当に同じネットか**を確認する。参照側の各ネットについて
プローブできる点(リング端子とコアピン)を集め、抽出結果で引いて

- 全部が1つのネットに落ちているか(参照が繋いでいるのにレイアウトが繋いでいない)
- 別々の参照ネットが同じ抽出ネットになっていないか(レイアウト側のショート)

を見る。**27ネットが一致**。これで実機LVSに渡す前に、参照とレイアウトの
食い違いはほぼ潰れている。

```
レイアウト側: layout/chip/step3_top_pins.gds        cell tr_1um_3wire_SPI
回路側:       layout/chip/tr_1um_3wire_SPI.spice    .subckt tr_1um_3wire_SPI
```

**実機KLayoutでのチップ全体 DRC / LVS、ともにクリーン**(2026-09-08)。
コア単体(§15.7)に続き、チップレベルでも一致。

> この確認は `step3_top_pins.gds` に対するもの。その後 §17.9〜17.11 で
> VSS配線の作り直し・PTECT削除・ロゴ追加を行った**最終物
> `layout/chip/step4_final.gds` でも、実機KLayoutで DRC / LVS ともに
> クリーンを確認済み**(2026-09-08)。

参照ネットリストは `layout/step10/simulation/`(= `~/.xschem/simulations/`)
にも同じものを書く。セルのexportと同じ場所に置く運用は §15.6 と同じ。

### 17.9 VSSをボンドパッドまで自前で引く(2026-09-08)

当初のGND脚は、Uコリドーのバスから**横に**出てリングのGND端子
(∓921.7, 600) に落としていた。これは**電気的には正しい** —
フレームは自分のGND端子とVSSボンドパッドを内部で繋いでおり、
(-200,-1040) と (∓921.7,600) は抽出しても同じネットになる。実機LVSが
通っていたのはそのため。ただし**コアの帰還電流がリングを4分の1周してから
パッドに着く**。

ユーザー指示で、I2C版と同じ構成に作り直した:

```
コア下辺のGND TAPピン4本
   → y=463 の10 µm M1バス(据え置き)
   → x=∓838 のM2脚2本を y=-795 まで下ろす
   → y=-795 の10 µm M1バスバー(x=-845..845)
   → x=-200±{0,12,24} の10 µm M2ストリップ5本
   → フレームのVSSピン(下辺全長のM2、内壁 y=-920 まで)= VSSボンドパッドの真下
```

途中で踏んだものが2つある。

- **ストリップの終端を y=-908 にしていた**。フレームのVSSピンのM2を
  「(-950,-960)-(950,-900)」と読んだのが誤りで、これは走査バンド
  [-960,-900] でクリップされた結果。実体の内壁は **y=-920**(リングの
  内壁半径920そのもの)。12 µm届いておらず、`check_chip.py` が
  「GNDとVSSが別ネット」と正しく落とした。
- **バスバーを y=-838 にしていた**(VDDの+838と対称にした)。フレーム自身が
  ダイ4隅のうち3隅に**自前のPTECTボックス**を持っており、右下の
  (810,-1120)-(1120,-810) に、バスバーの右端と右脚が丸ごと入っていた。
  y=-795 に上げて15 µmのクリアランスを取った。**対称性より、そこに実際に
  何があるかが優先**。

`check_chip.py` の電源チェックにはボンドパッド `VSS`(-200,-1040) 自体を
プローブ点として追加した。以前は脚の先のリング端子までしか見ておらず、
「パッドまで自前で届いているか」を問うていなかった。

### 17.10 PTECTを外す

PTECT(63/1)は**このプロジェクトが自分で描いたキープアウト**で、
`assemble_top.py` が置き、信号ルータに「コア下は使うな」と教えるためだけに
存在する(Uコリドーがあるのはこれのため)。製造されるチップにこの層は無い。
役目は信号配線が終わった時点で終わりなので、`route_chip.py` が電源配線の
直前に消す — GNDのバスバーはここを横切る必要があり、ロゴもここに置く。
I2C版 `finalize_chip_v10.py` も同じ場所で消している。

消してしまうと「信号がキープアウトを守ったか」を層で確かめられなくなるので、
`check_chip.py` のPTECTチェックを3つに分けた:

1. **自分のPTECTマーカーが消えているか**(残っていたらルータが走っていない)
2. **フレーム由来のPTECT(3隅のボックス)に金属が入っていないか** — これは
   実在するキープアウトなので、消す前も後も全レイヤで確認する
3. **信号ネットが元のボックスに入っていないか** — ボックスは
   `gio_connections.json` の `chip_geometry` から、ネットの形状は
   `step2_routed_net_shapes.json` から取る。VDD/GNDは名指しで除外
   (横切るのが目的)

### 17.11 OpenSUSIロゴを2列

コアは1,840 µmの開口に314 µmしかないので、PTECTを外すとダイ下半分が丸ごと
空く。ここにロゴを**2段**置いた(`scripts/place_logo.py`)。

ロゴは**塗り潰しではなく孤立ドット**で描く。5.0 µmグリッドのONセルごとに
3.0 × 3.0 µmのM2正方形をセル中央に置く:

| | |
|---|---|
| ドット 3.0 µm | M2最小幅ちょうど |
| 直交隣接 | 5.0 − 3.0 = **2.0 µm** = M2最小スペースちょうど |
| 斜め隣接 | √2 × 2.0 = **2.83 µm** |

幅・スペースのチェックはどちらも「**未満**」を違反とするので、ちょうどは
合法 — 本プロジェクトの配線が使っているのと同じ約束。I2C版は最初これを
5 µmの塗り潰しブロックで描いて斜め接触を手で当てる羽目になったが、
ドットならその状況自体が起きない(§105)。

ビットマップは `lef/opensusi_logo.txt`(317 × 63セル、5,785ドット)として
リポジトリに置いた。I2C版チップGDSの `OPENSUSI_LOGO` セルから起こしたもので、
元PNGへの依存は無い。

> **コメント文字は `%`、`#` ではない。** `#` はONセルそのものなので、
> 左端がONの行は `#` で始まる。`#` をコメントとして読むと**その行が黙って
> 消える** — 実際に63行が55行になり、ロゴが縦に潰れた。

配置は `AREA = (-795, -785, 795, 453)`(左右はGND脚の内側、上下は2本の電源
バスの間)の中央に2段、間隔100 µm。上下の余白は各256 µmで対称。置く前に
ロゴ単体でDRCを取り、置いた後にチップ全体で**増えたマーカーが0であること**を
確認してから書き出す。
---

## 18. ngspice によるチップレベル検証

コアだけでなく**パッドリングを含むチップ全体**を、PDKの実デバイスモデルで
トランジスタレベルに流す。RTL・合成後NET・P&R用NETの3ビュー(§4)は
どれも論理シミュレーションで、パッドセルは Verilog の `1'bz` に置き換わって
いた。ここが初めて `OSS_ESD_5V_DIO` の実体を通す工程になる。

### 18.1 LVSネットリストをngspiceが読める形にする

`scripts/gen_chip_sim_ready.py`。LVS参照ネットリスト
`layout/chip/tr_1um_3wire_SPI.spice` はKLayoutの照合器向けに書かれていて、
ngspiceが受け付けない書き方がいくつかある。**ポート・ネット・階層・素子寸法は
一切触らず**、機械的な5点だけを直す(I2C版 `gen_chip_sim_ready_v10.py` と
同じ5点だった):

| | 直すもの | 理由 |
|---|---|---|
| 1 | `M<name> d g s b PMOS w= l=` → `X<name> ...` | 258箇所。PDKの `PMOS`/`NMOS`/`MPE`/`MNE` は `.model` ではなく **`.subckt`**。行頭が `M` だとngspiceは存在しないMOSFETモデルを探しに行く |
| 2 | `rx_data[0]` → `rx_data_0` | 118箇所 / 31種。角括弧付きのノード名はLVSでは通るがngspiceでは通らない |
| 3 | `*.PININFO` の `+` 継続行 → `*+` | 2箇所。コメントは改行で終わるので、継続行が回路行として読まれる |
| 4 | ESDダイオードの `A=`/`P=` → `AREA=`/`PJ=` | 2箇所 |
| 5 | `NMOSE` → `MNE` | 4箇所。PDKに `NMOSE` は無い。パッドセルが実際に使うのは高耐圧NMOSの `MNE` |

置換数を全部数えて印字し、書き出した後にKLayoutのSPICEリーダで読み直して
40サブサーキットが取れることを確かめる。**変換して壊れたネットリストは、
変換しなかったより悪い**。

> KLayoutのSPICEリーダは回路名を大文字化して返す。SPICEは大小を区別しない
> ので、読み直しの照合も大小無視で行う。

### 18.2 双方向パッドを両側から駆動しない

`scripts/gen_chip_tb.py`。SDIOとDATA[7:0]は双方向なので、テストベンチ側の
ドライバは電圧制御スイッチ越しに繋ぎ、**どの瞬間も片側しか駆動しない**
(I2C版TBと同じ手口):

- **DATA[7:0]** … `TXGATE` がDISに追随する。DIS=1(READ)のときだけスイッチが
  閉じて 10 kΩ 経由で `tx_data` を送り込む。DIS=0(WRITE)ではスイッチが開き
  (`ROFF=1T`)、パッドはチップのもの。パッドの `HIZ` は DIS パッドのネットに
  直結してあるので(§16.5)、両者は定義から食い違わない
- **SDIO** … `MGATE` がWRITEフレーム中だけ高い。チップ側は
  `sdio_oe_n = ~(dis & ~cs_n)` なので、READでCSが下りている間だけ駆動する

各DATAパッドに 1 MΩ、SDIOに 20 kΩ の対VSS抵抗を足してある。動作点計算に
DC経路を与えるのと、**Hi-Zのときの電位を決める**のが目的。どちらのドライバに
比べても十分弱く(実測 4.95 V / 4.98 V)、判定は変わらない。

### 18.3 `.control` に `run` を書かない

バッチモード(`ngspice -b`)は `.tran` カードを自分で走らせる。そこに
`.control ... run ... .endc` を書くと**解析が2回走り、同じ測定ブロックが
2回印字される**。I2C版のTBはそうなっていた。2回分の54 measureを突き合わせて
**全て最後の桁まで一致**していたので、間違いではなく単に倍の時間を使って
いただけと分かった。ここでは `.control` は `save` を置くためだけに使い、
`run` も `print` も書かない(`print` を書くと今度は本当に壊れた2回目が走る、
というのがI2C版で踏んだバグ)。`save` を16本のパッドに絞ってあるので、
Tmax 1 ns でもメモリは 10 MB 程度。

### 18.4 Tmax = 1 ns

ユーザ指定。`.tran` の第4引数。I2C版は、IRSIM・Verilog・ゲートレベルの全てで
通るREADフレームがSPICEだけ落ちる現象を追いかけて、**Tmax=50 ns では10 ns
未満のセットアップ余裕を解像できず、ngspiceの適応ステップ制御が誤った側に
丸めていた**ことを突き止めている。他を何も変えずTmaxを1 nsにするだけで
10/14 → 14/14 になった。区間を限って指定する手段が無いので全区間に効く。
本設計は 37.5 µs で **24.0 秒**(設計機での実測。クラウドコンテナでは約80秒)。

### 18.5 流した内容

SCLK 1 MHz / Mode 0 / MSBファースト、3フレーム連続。

| | DIS | 内容 |
|---|---|---|
| WRITE | 0 | マスタがSDIOに `0xA5`。8発目の立ち上がりで `rx_data` に入り、DATAパッドに出る |
| READ | 1 | DATAパッドが入力になり `tx_data = 0x3D`。チップがSDIOを駆動して返す |
| WRITE | 0 | `0x5A`。2フレーム目もビット7から始まること、READが `rx_data` を壊していないことを見る |

READ値を `0x3D`(LSB=1)にしたのは意図的で、**チップが最後に駆動する値が
HIGH**になる。CSが上がった直後にSDIOが 0 V へ落ちること(20 kΩが効く)が、
「本当に手を離した」と「まだ駆動している」を区別する。LSBが0の値だとこの
チェックはどちらでも通ってしまう。

### 18.6 結果 — **12チェック / 54 measure 全PASS**

```
[t=   4500 ns] OK  : DATA pads read 0x00 out of reset                        (got 0x00)
[t=   4500 ns] OK  : byte_end low while CS is high                           (0.000 V on P4)
[t=   8000 ns] OK  : byte_end low mid-frame (bit 3 of the WRITE)             (0.000 V on P4)
[t=  12000 ns] OK  : byte_end high during the 8th bit of the WRITE           (5.000 V on P4)
[t=  13200 ns] OK  : DATA pads carry the received 0xA5                       (got 0xA5)
[t=  15700 ns] OK  : SDIO high-Z with DIS=1 and CS high                      (0.000 V on P2)
[t=  15700 ns] OK  : DATA pads are inputs carrying tx_data = 0x3D            (got 0x3D)
[t=  23500 ns] OK  : the chip shifted 0x3D out on SDIO                       (got 0x3D)
[t=  23000 ns] OK  : byte_end high during the 8th bit of the READ            (5.000 V on P4)
[t=  25200 ns] OK  : SDIO released after CS rises (last bit driven was 1)    (0.000 V on P2)
[t=  27200 ns] OK  : the READ frame left rx_data at 0xA5                     (got 0xA5)
[t=  35700 ns] OK  : a second WRITE frame lands 0x5A                         (got 0x5A)
```

一発で通ったので、**測っていないのに通っている**のではないことを確かめた。
同じDATAパッド8本の上を

```
rx_reset   0.00 0.00 0.00 0.00 0.00 0.00 0.00 0.00   = 0x00
rx_wr1     5.00 0.00 5.00 0.00 0.00 5.00 0.00 5.00   = 0xA5
tx_pads    0.00 0.00 4.95 4.95 4.95 4.95 0.00 4.95   = 0x3D  (TB側が10kΩで駆動)
rx_kept    5.00 0.00 5.00 0.00 0.00 5.00 0.00 5.00   = 0xA5
rx_wr2     0.00 5.00 0.00 5.00 5.00 0.00 5.00 0.00   = 0x5A
```

と**4通りの相異なるパターン**が通り、レベルは全てレールに達している
(TB駆動の 4.95 V は 10 kΩ / 1 MΩ の分圧そのもの)。

**このTBは §16.6 の極性変更(option C)を単独で検証している**。もし `HIZ2` の
極性が逆なら、WRITEフレーム中にチップがSDIOを駆動して 1 kΩ 越しのマスタと
喧嘩し(300 µm のパッドドライバが勝つので `rx_wr1` が壊れる)、READフレームでは
Hi-Zになって `read_byte` が 20 kΩ のプルダウンを読んで `0x00` になる。両方が
同時に通るのは極性が正しいときだけ。

### 18.7 抽出ネットリストで同じTBを流す

`gen_chip_sim_ready.py` が変換するのはLVSの**参照側** — Verilogとセル回路図
から組み立てた「こうあるべき」の方。`scripts/gen_sim_from_extracted.py` は
**レイアウト側**、つまりKLayoutがGDSから実際に見つけたものを変換する。
LVSは両者がグラフとして一致することを保証するが、**レイアウト自身の数値を
持っているのは後者だけ**:

```
XM$1 vdd A Y vdd PMOS L=1u W=10.2u AS=28.56p AD=15.3p PS=26u PD=13.2u
```

PDKの `PMOS`/`NMOS` サブサーキットは、誰も渡さなければ `AS`/`AD` を
`w*sdwidth`、`PS`/`PD` を `2*(sdwidth+w)` で埋める。参照ネットリストは
これを使う。抽出側は実形状の実測値なので、**行内で隣接セルが共有する
拡散が二重に数えられない**。接合容量、ひいては遅延が、描いた通りになる。

直すのはKLayout固有の書き方だけで、`gen_chip_sim_ready.py` と同じ規律
(機械的・全数カウント・報告あり):

| | 直すもの | 個数 | 理由 |
|---|---|---|---|
| 1 | `\$107` / `\$I4` → `net_107` / `net_I4` | 317 | 無名ネット。SPICEに無いバックスラッシュエスケープで、中身の `$` はコメント開始文字 |
| 2 | `PAD\|VDD` → `PAD_VDD` | 10 | 1本のネットが2つのラベルを持つときのKLayout表記(VDD ESDセルのパッドはレールそのもの)。`\|` は名前に使えない |
| 3 | `X$1` / `XM$1` / `D$17` → `X_1` / `XM_1` / `D_17` | 236 | インスタンス名 |
| 4 | `tx_data[0]` → `tx_data_0` | 40 | 角括弧 |
| 5 | ダイオードの `A=`/`P=` → `AREA=`/`PJ=` | 2 | |
| 6 | `NMOSE` → `MNE` | 4 | PDKに `NMOSE` は無い |

改名は書き出す前に**全数の衝突照合**にかける。別々のネットが同じ名前に
なってしまったら、それは後からは本物のショートと区別がつかない。

トップの `.SUBCKT` ポートはKLayoutがアルファベット順に書くので、
プロジェクトの正規のボンドパッド順(P1..P7, VSS, P9..P15, VDD)に並べ替える。
これでTBの `--netlist` を差し替えるだけで参照ネットリストと入れ替わる
(並べ替えないと、黙ってパッドが入れ替わる)。

#### 突き合わせは素子数ではなく総チャネル幅で

抽出器は**並列素子をまとめる**。FILL3のデカップリング48個が、参照側では
`w=21.2u` のPMOS 48個なのに対し、抽出側では `W=1017.6u` のPMOS 1個になる
(48 × 21.2 = 1017.6)。回路図側も同じものを `m=2` と書くことがある
(BUF_X2)。**総幅はどちらの畳み込みでも保存されるが、個数はどちらでも
壊れる** — `check_cell_spice.py` がセルをGDSと比べるときと同じ理屈。

```
vs ngspice/tr_1um_3wire_SPI_sim_ready.spice: 19 vs 19 cell(s);
   total PMOS 3205.6 vs 3205.6 um, NMOS 2413.9 vs 2413.9 um
   every cell holds the same children and the same total P/N channel width
```

#### 結果

同じTB(`--netlist` だけ差し替え)で **12/12 PASS**(設計機で 23.0 秒。
参照側の 24.0 秒とほぼ同じ — 素子数は同じで、寄生の数値だけが違う)。
54 measure の参照側との**最大差は 0.69 mV**(`sdio_hiz_after_read` が
+0.00001 V → -0.00068 V)。抽出寄生を積んでも判定は1つも動かない。

`ngspice/spice_chip.log` と `ngspice/spice_chip_extracted.log` は
どちらも設計機で流した現物。

#### 抽出寄生は判定は動かさないが、遅延は動かす

判定が動かないのは**判定点が落ち着いた場所にある**からで、寄生が効いていない
わけではない。同じ1 MHzの実行で clock-to-out(§18.8)を比べると:

| | 参照ネットリスト | 抽出ネットリスト | 差 |
|---|---|---|---|
| `tco_sdio`(SCLK↓ → SDIO 有効) | 38.55 ns | **37.10 ns** | −1.45 ns |
| `tco_data`(SCLK↑ → DATA 有効) | 27.90 ns | **27.55 ns** | −0.35 ns |

**抽出側の方が速い。** PDKの既定値は素子ごとに `AS`/`AD` を `w*sdwidth` で
埋めるので、行内で隣接セルが**共有している**拡散を二重に数えてしまう。
抽出器は実形状を測るので一度しか数えない。差は臨界パスで 1.4 ns(3.6%)で、
上限周波数にそのまま効く。参照ネットリストで速度を見積もると**わずかに
悲観的**になる、というのが正しい理解。

> `layout/step10/spi_slave_sclk_nrow_fm.extracted`(コア単体)は
> **option C の再合成より前**の抽出で、`NOR2` が2個残り `NAND2`/`AND2_X1`
> が1個ずつ足りない。上の突き合わせがそれを検出した(この用途では使わない
> ので放置してある。チップレベルの抽出はコアを含んでいて最新)。

### 18.8 通信速度 — 何MHzまで動くか

`scripts/sweep_sclk.py` が、**同じ12チェックを周波数軸に沿って上げていき、
壊れる場所を探す**。大事なのは1つの数字ではなく**どのチェックが先に落ちるか**で、
落ち方が原因を名指しする。

まず `gen_chip_tb.py` に判定しない計測(TRIG/TARG)を4本足した。
`.measure` の `TD` を対象のエッジの直前に置くので、`RISE=`/`FALL=` の
数え上げは常に1回目 — 24発のクロックを頭から数えるより頑健:

| 計測 | 経路 |
|---|---|
| `tco_sdio_r1` / `_f5` / `_r6` | SCLK**立ち下がり** → SDIO 有効(READ)。パッド入力バッファ→コアのFF→出力ドライバ→パッド |
| `tco_data` | SCLK 8発目の**立ち上がり** → DATAパッド有効(WRITE) |

`--sclk` で周波数を、`--load-pf` で全信号パッドの外部容量を、`--master-ohm` で
**テストベンチ側マスタの出力インピーダンス**を変えられる。SCLKに追随して
エッジ時間も `TCK/25`(上限20 ns)で縮む — 20 ns固定のランプは1 MHzでは
きれいなエッジだが20 MHzでは周期の大半になり、チップではなくランプ発生器を
測ることになる。リセットだけは**クロックレートと無関係**なので100 ns固定
(2 nsのランプをリセットパッドのESD構造に入れたら、ngspiceが
"timestep too small" で落ちた掃引点が実際に1つ出た)。

#### 実測(抽出ネットリスト / typical / 5.0 V / 27 °C)

| | 外部負荷なし | 20 pF |
|---|---|---|
| `tco_sdio`(SCLK↓ → SDIO 有効) | **30.7 ns** | **34.4 ns** |
| `tco_data`(SCLK↑ → DATA 有効) | 21.5 ns | 25.2 ns |
| 12チェックが通る上限 | **16 MHz**(17 MHzで落ちる) | **15 MHz**(マスタ100 Ω) |
| コア+入力経路だけの限界 | **32 MHz**(35 MHzで落ちる) | — |

`tco` は負荷 20 pF で **+3.7〜5.6 ns**、およそ **0.28 ns/pF**。
1 MHzでは `tco_sdio` が 37 ns まで伸びるが、これはSCLKのランプが20 nsあって
入力バッファの閾値通過が50%点から遅れるためで、エッジを速くすると 30.7 ns に
収束する。

#### 律速はどこか — 落ち方が名指しする

17 MHzで最初に落ちるのは `read_byte` だけで、**`rx_wr1`/`rx_wr2` は
32 MHzまで通る**。つまり**シフトレジスタもビットカウンタも入力経路も
32 MHzで動いていて、遅いのは出力経路だけ**。

落ち方も教科書どおりで、18 MHzでは `read_byte` が `0x1E`。
`0x3D >> 1` そのもの — **各立ち上がりでマスタが1つ前のビットを見ている**。
Mode 0 ではチップは立ち下がりでSDIOを変え、マスタは次の立ち上がり、つまり
**半周期後**にサンプルする。だから上限は

```
f_max ≈ 1 / (2 × tco_sdio)
```

負荷なしなら 1/(2×30.7 ns) = **16.3 MHz** — 実測の「16 MHz通過 / 17 MHz失敗」と
一致する。17 MHzで `read_byte` が `0x3C`(LSBだけ違う)から18 MHzで `0x1E`
(全ビット1つずれ)へ崩れていくのも、余裕がちょうど尽きる境目の姿。

#### テストベンチ側のマスタが先に律速することがある

20 pF負荷で最初にやった掃引は12 MHzで止まったが、落ちたのは `rx_wr1` で、
これは**チップではなくテストベンチのマスタ**だった。マスタは 1 kΩ 直列で
SDIOを駆動しているので、20 pF と組むと時定数が 20 ns になり、
WRITE側が先に間に合わなくなる。`--master-ohm 100`(実際のマスタらしい値)に
すると同じ20 pFで15 MHzまで通る。**測っているのが部品か測定系かを分けられる
ようにしておかないと、部品に無い上限を報告してしまう。**

#### 定格

```
f_max ≈ 1 / (2 × (tco_sdio + マスタのセットアップ))
```

20 pF・マスタのセットアップ10 ns なら 1/(2×(34.4+10) ns) = **10.8 MHz**。

> **推奨最大 SCLK = 10 MHz**(5.0 V、パッド負荷20 pFまで、マスタのセットアップ
> 10 ns確保)。1 MHzで署名した機能検証(§18.6)に対して10倍の余裕がある。

条件つきであることを忘れないこと — typicalモデル・27 °C・5.0 V での値で、
プロセスばらつきと温度のコーナーは振っていない。遅い側のコーナーでは
`tco` が伸びるので、外部で使うときは10 MHzを上限として扱うのが安全。

```sh
scripts/sweep_sclk.py                                   # 既定のはしご
scripts/sweep_sclk.py -f 13,14,15 --load-pf 20 --master-ohm 100
```

### 18.9 再現手順

```sh
scripts/gen_chip_sim_ready.py
scripts/gen_chip_tb.py
cd ngspice && ngspice -b tb_chip_spi.spice > spice_chip.log 2>&1 && cd ..
scripts/check_chip_sim.py ngspice/spice_chip.log

# 抽出ネットリスト側
scripts/gen_sim_from_extracted.py
scripts/gen_chip_tb.py --netlist tr_1um_3wire_SPI_extracted_sim.spice \
    -o ngspice/tb_chip_spi_extracted.spice -j /dev/null
cd ngspice && ngspice -b tb_chip_spi_extracted.spice > spice_chip_extracted.log 2>&1 && cd ..
scripts/check_chip_sim.py ngspice/spice_chip_extracted.log
```

`ngspice/spice_chip.log` はコミットしてある現物。`tb_chip_spi.spice` は
モデルを `~/HogeHoge/OpenPDK/TR-1um/libs.tech/spice/models/ip62_models` から
読む(`gen_chip_tb.py --models` で変えられる)。

---

## 20. MPWエクスポート

`scripts/export_mpw.py` が `src/` の2ファイルを作る。**元ファイルからの差分は
1点だけで、両方に同じもの**:

| 提出物 | 元 | 差分 |
|---|---|---|
| `src/tr_1um_3wire_SPI.gds` | `layout/chip/step4_final.gds` | `OSS_FRAME_GIO` → `OSS_FRAME` の改名のみ |
| `src/tr_1um_3wire_SPI.cir` | `layout/chip/tr_1um_3wire_SPI.spice` | 同じ改名のみ |

### 20.1 なぜ改名が要るか

`scripts/pre_check.py`(提出物自身のゲート。CIの最初に走る)が2つ要求する:

1. **トップセルはちょうど1つ**
2. **`OSS_FRAME` か `OSS_FRAME_TEG` という名前のセルが存在すること**

本設計が実体化しているのはGIO版の `OSS_FRAME_GIO`。フレームGDSには素の
`OSS_FRAME` / `OSS_FRAME_TEG` も入っているが**どこからも実体化されない**ので
トップセルになり、(1) に引っかかる。標準セルライブラリを丸ごと読んでいる
関係で未使用セルも同様で、**トップセルが17個**あった。

`place_logo.py` が最終組み立ての一環でこれを刈る(実体化されていないセルしか
消さないので、トップセル配下のジオメトリは1ビットも変わらない — つまり
DRC/LVSの結果は変わりようがない)。17 → 1、62 → 44セル。刈ると (2) を
満たすセルが消えるので、**実際に使っているリングを改名**して両方を同時に
満たす。改名は提出用コピーの中だけで、マスタは本来の名前のまま。GDSと
ネットリストの両方に同じ改名をかけるので、LVSが突き合わせる2つは整合する。
I2C版も同じ理由で同じことをしている。

### 20.2 書き出す前に見ているもの

`pre_check.py` が見る項目(トップセル1個・名前・dbu 0.001・ダイ枠
2,500 × 2,500)に加えて、**pre_check には見えないもの**も確認する:

- ネットリストが**パースできるか**(KLayoutのSPICEリーダ)
- **トップサブサーキットのポートと、レイアウトのピンマーカーが一致するか**
  — TXM2のラベル16個と `TOP_PIN_ORDER` を名前で突き合わせる。I2C版は
  ここが食い違って、他の27サブサーキットが全て一致しているのに全ピンが
  連鎖的にNoMatchになった(§17.7)
- **`info.yaml` がこれから書くファイルを指しているか** — `gds.top_cell`、
  拡張子 `gds` / `cir`
- 書いた**後に読み直して**、改名が両方に効いていること・トップセルが1個で
  あること・フレームセルが居ることを再確認

CIで落ちる提出物は1日を無駄にする。ここで落ちれば1秒で済む。

### 20.3 テンプレート同梱ファイル

`src/tr_1um_username.{gds,cir,sch,extracted}` はテンプレートのプレースホルダ
設計。本物の隣に残すと間違ったほうを提出することになるので、
`export_mpw.py` が書き出し時に消す。

### 20.4 `info.yaml`

書き出し時点では変更不要だった(`pdk.ref` はその後 §21 で変えている)。
全項目が提出物と一致していることを `export_mpw.py` が毎回確認する:

| キー | 値 |
|---|---|
| `gds.top_cell` | `tr_1um_3wire_SPI` |
| `gds.extension` / `lvs.extension` | `gds` / `cir` |
| `lvs.netlist_only` | `false`(=フルLVS比較) |
| `mdp.file` | `IP62_jun1okamura.gds` |
| `pdk.repo` / `ref` / `dir` | `OpenSUSI/TR-1um` / **`dev`**(元は `v1.2609.0`、§21) / `libs.tech` |

`project.description` の等価ゲート数だけ、option C 後の実測値
(211ゲート / 844 Tr)に直してある。

---

## 21. CIのLVSエラー — 原因はPDKのデック側だった(2026-09-08)

push すると **DRCはクリーン、LVSだけ落ちた**。手元では同じ `src/` のペアが
通っていた。

### 21.1 まず自分の再現コマンドが間違っていた

CIと同じ条件で手元に再現しようとして、こう書いた:

```sh
-rd circuit=src/tr_1um_3wire_SPI.cir -rd extracted=src/tr_1um_3wire_SPI.extracted
```

結果は `.../TR-1um_SCLK_SPI/src//src/tr_1um_3wire_SPI.cir (errno=2)`。
**`circuit` / `extracted` はレイアウトGDSのあるディレクトリからの相対で
解決される**ので、渡すのは**ファイル名だけ**。CI の `read_info.py` も
`f"{top_cell}.{lvs_ext}"` と裸の名前を出している。正しくは:

```sh
klayout -b -r <PDK>/libs.tech/klayout/tech/lvs/run.lvs \
  -rd input=src/tr_1um_3wire_SPI.gds \
  -rd top_cell=tr_1um_3wire_SPI \
  -rd circuit=tr_1um_3wire_SPI.cir \
  -rd extracted=tr_1um_3wire_SPI.extracted
```

これで手元は **`INFO : Congratulations! Netlists match.`**(strict port mode)。
つまりファイルの中身は正しく、**手元とCIで環境が違う**ことが確定した。

### 21.2 違いはPDKのデックだった

`info.yaml` の `pdk.ref` はタグ `v1.2609.0`。ユーザーのローカルPDKは
`dev` 相当だった。タグと `dev`(`64e40f5 UPDATE: OSS_FRAME_GIO`)の
`libs.tech/klayout/tech/lvs/05_Compare.lvs` の差分がこれ:

```ruby
+   equivalent_pins("AND2_X1", "A", "B")
+   equivalent_pins("AND3_X1", "A", "B", "C")
+   equivalent_pins("AND4_X1", "A", "B", "C", "D")
+   equivalent_pins("NAND2",   "A", "B")
+   equivalent_pins("NAND3",   "A", "B", "C")
+   equivalent_pins("NAND4",   "A", "B", "C", "D")
+   equivalent_pins("NOR2",    "A", "B")
+   equivalent_pins("NOR3",    "A", "B", "C")
+   equivalent_pins("NOR4",    "A", "B", "C", "D")
+   equivalent_pins("OR2",     "A", "B")
+   equivalent_pins("OR3",     "A", "B", "C")
+   equivalent_pins("OR4",     "A", "B", "C", "D")
+   equivalent_pins("XOR2",    "A", "B")
+   equivalent_pins("XNOR2",   "A", "B")
```

**対称入力ゲートの入力ピンが入れ替え可能であることを、タグ版のデックは
知らなかった。** 本設計が使っているのは `AND2_X1`×3 / `NAND2`×2 /
`NOR4`×2 / `XOR2`×2 / `XNOR2`×1 / `OR3`×1 — まさに対象セル。AとBの
どちらに何が繋がるかは論理的に等価なので、抽出側と参照側で割り当てが
入れ替わった箇所があれば、タグ版は不一致と報告し、`dev` 版は通る。

同じ差分にもう1件あって、こちらも症状を分かりにくくしていた:

```ruby
-   success = compare && flag_missing_ports
+   compare_result = compare
+   port_check_result = flag_missing_ports
+   success = compare_result && port_check_result
```

Rubyの `&&` は短絡するので、**`compare` が落ちると `flag_missing_ports` は
一度も呼ばれない** — ポート診断が何も出ないままエラーになる。

`pdk.ref` を `dev` にしてCIは通った。

### 21.3 `dev` 固定のリスク

`pdk.ref: "dev"` は**動くブランチ**で、テンプレート自身のコメントも
「再現性のために固定タグを推奨」と書いている。こちらが何も変えていなくても
次のCI実行でデックが変わりうる。

`.github/actions/checkout-pdk` は `git clone --branch "${REF}"` を使うので、
**受け付けるのはブランチ名かタグ名だけ、コミットSHAは指定できない**。
`64e40f5` を含むタグが切られたらそれに差し替えるのが本来の姿。
それまでは `dev` のまま。

> **教訓**: 「手元では通るのにCIで落ちる」を最初にツールのバグと決めつけない。
> 今回は本当にツール(デック)側だったが、それが分かったのは
> **CIと同じコマンドを手元で再現できるようにしてから**。再現コマンドが
> 間違っていた段階では何も切り分けられていなかった。

---

## 附: ピン配置表

`docs/pin_list.md`(`scripts/pin_list.py` が生成)。ボンドパッド座標・辺・役割・
方向・コア側のネット・`HIZ` の駆動元、それに基板配線用の**時計回りのパッド並び**。
ボンドパッド座標はフレームGDSの `OSS_PAD` インスタンスから読み、接続表と
ネットリストのポート宣言に突き合わせている。

---

## 19. 次のステップ

### 完了済み

1. ~~`info.yaml` の `gds.top_cell` 確定~~ → **`tr_1um_3wire_SPI`**
2. ~~RTL設計と検証~~ → **12本 / 187チェック × 3ビュー = 36ラン全PASS**(§4)
3. ~~論理合成~~ → **211等価ゲート / 844 Tr / 41セル**(§5)
4. ~~STDCELLへの `BUF_X2` 追加~~ → **実装確認済み**(§12.1)
5. ~~行数の決定~~ → **2行 × 行幅1620 µm**(§12)
6. ~~nrow配置~~ → **全チェックPASS、各STEPのGDSあり**(§13)
7. ~~チャネル配線~~ → **DRC 0違反・短絡0、各STEPのGDSあり**(§14)
8. ~~スカラーポート未引き出しの修正~~ → **全25ポート接続確認済み**(§14.5)
9. ~~STDCELL利用リストとLEF FOREIGN / BUF_X2セルDRCの修正~~ → **29セル全てDRCクリーン**(§14.6)
10. ~~LVS用SPICEネットリスト生成~~ → **NETから機械生成。セル実体は
    xschem export と13セル一致、インスタンス数もGDSと一致**(§15)
11. ~~実機KLayoutでのコア単体DRC/LVS~~ → **DRC・LVSともクリーン**(§15.7)
12. ~~ANT(アンテナ)フリーの確認~~ → **確認済み**
13. ~~GIOフレームへのコア配置とトップ配線プランの作成~~ → **配置確定
    (-810.0, 515.9)**(§16)
14. ~~SDIO出力イネーブルの極性~~ → **コアをアクティブLOW(`sdio_oe_n`)で
    再合成。チップトップは「パッドリング + コア」だけになった**(§16.6)
15. ~~トップレベル配線~~ → **信号24ネット + 電源、DRC新規0・断線0・短絡0**(§17)
16. ~~実機KLayoutでのチップ全体 DRC / LVS~~ → **ともにクリーン**(§17.8)
17. ~~ngspice によるチップレベル検証~~ → **パッドリング込みのトランジスタ
    レベルで 12チェック / 54 measure 全PASS、Tmax 1 ns**(§18)。
    **抽出ネットリスト(実レイアウトの寄生付き)でも同じTBで 12/12 PASS**、
    参照側との差は最大 0.7 mV(§18.7)

18. ~~VSSをボンドパッドまで自前で引く / PTECT削除 / OpenSUSIロゴ2段~~ →
    **`layout/chip/step4_final.gds` で実機DRC/LVSクリーン**(§17.9〜17.11)
19. ~~MPWエクスポート~~ → **`src/tr_1um_3wire_SPI.gds` / `.cir` を
    `scripts/export_mpw.py` が機械生成。`scripts/pre_check.py` PASS。
    由来は `PROVENANCE.md`**(§20)

### 残り

なし。提出物は `src/` に揃っている。

---

## 付録: 計測方法

- セル寸法: `lef/TR-1um_STDCELL.gds` の各セルbounding boxをgdstkで実測
- トランジスタ数: `TR-1um_Async_I2C/LEF/<cell>.extracted` のMOS素子数を計数
- 上記2つを `lef/cell_info.json` に集約し、`scripts/gen_liberty.py` が合成用
  Libertyを、`scripts/gate_count.py` が規模レポートを生成する
- I2C版の比較値: `TR-1um_I2C_2026/src/tr_1um_i2c_slave_async.gds` の
  `i2c_slave_async_nrow_fm` 直下のreferenceを集計(via/FILL/TAP除外)、
  Tr数は同 `.cir` のsubckt階層を再帰展開して計数
- 論理セル密度27.8%: I2C版の論理セル面積 0.426 mm² ÷ 配置後コアBBOX 1.533 mm²
