jun1okamura/TR-1um_SCLK_SPI/docs/OpenSUSI-MPW.pptx

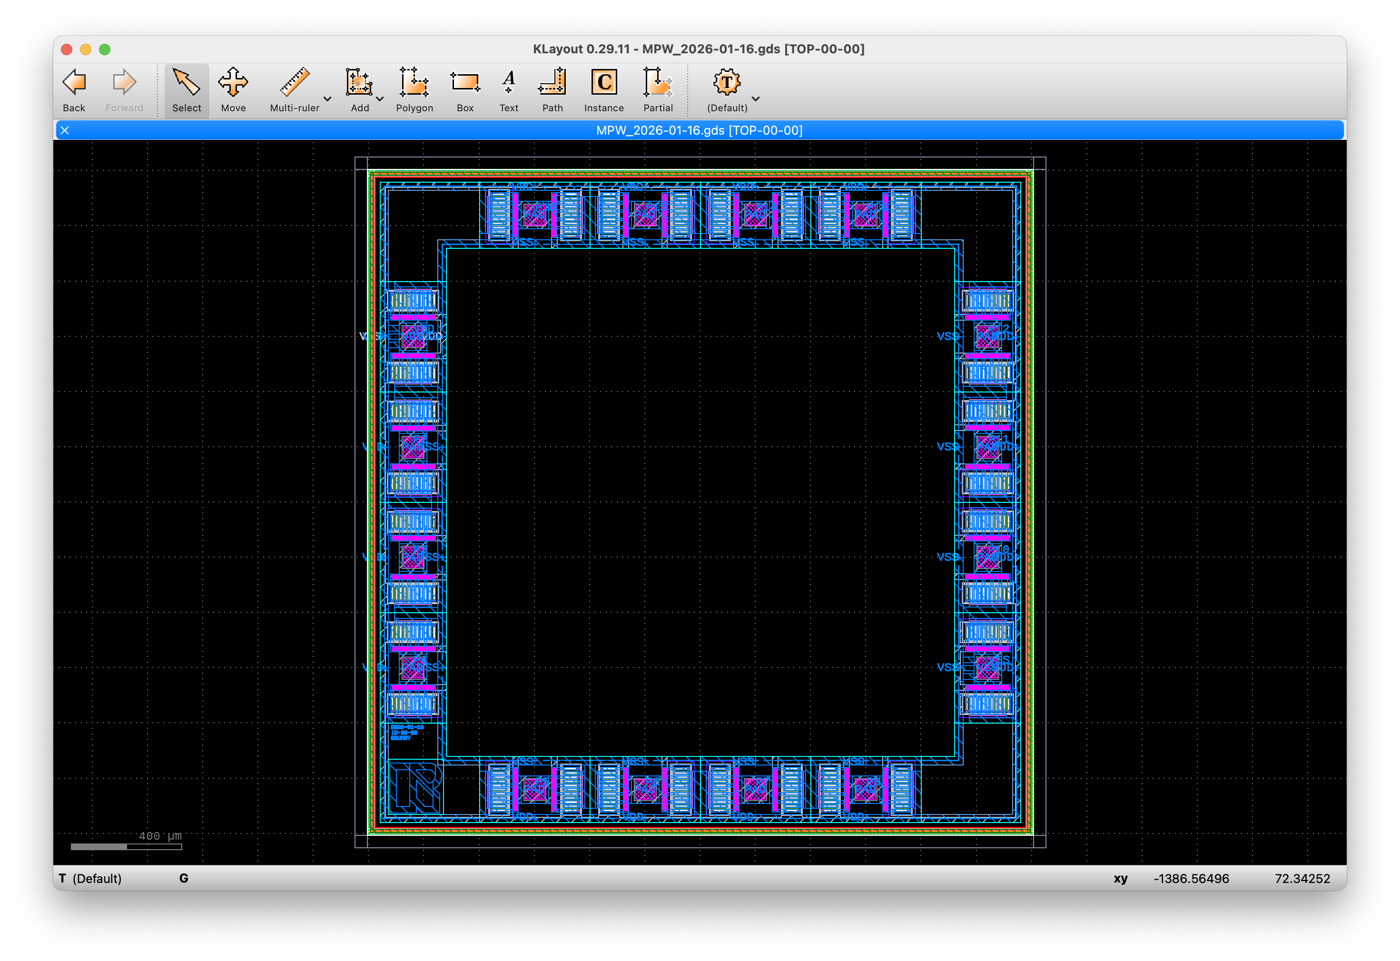
[picture p2: figure]

Reserved Area for Project Supporters

(1250,1250)

top_cell:name

“OSS_FRAME” on (0,0)

(0,0)

(-1250,-1250)

## Slide 2

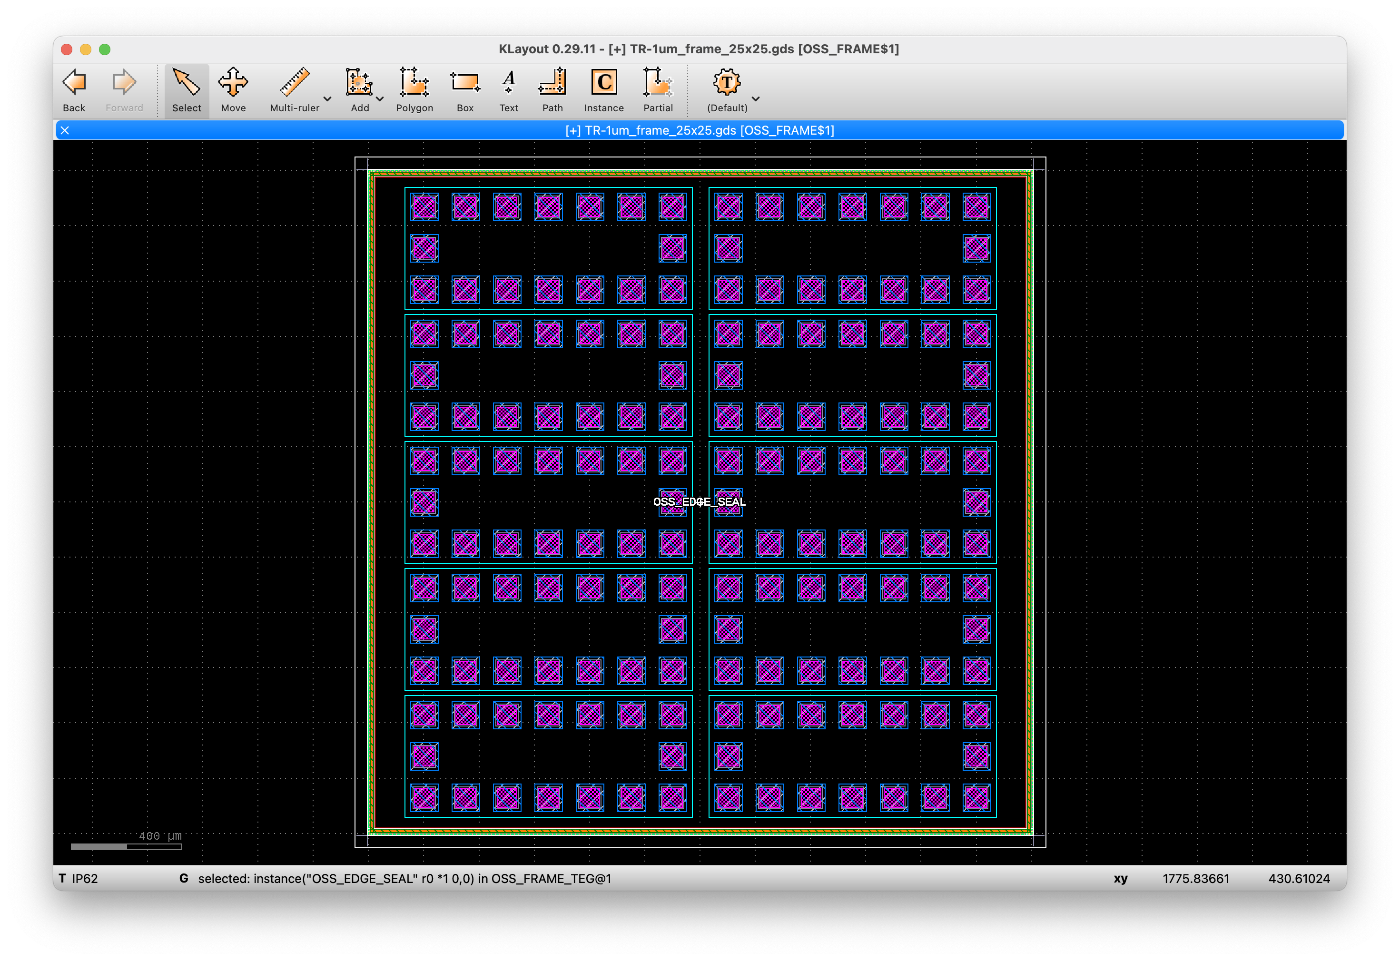
[picture p3: figure]

(1250,1250)

top_cell:name

“OSS_FRAME_TEG” on (0,0)

(0,0)

(-1250,-1250)
