jun1okamura/TR-1um_SCLK_SPI/docs/OpenSUSI-MPW-TEG.png

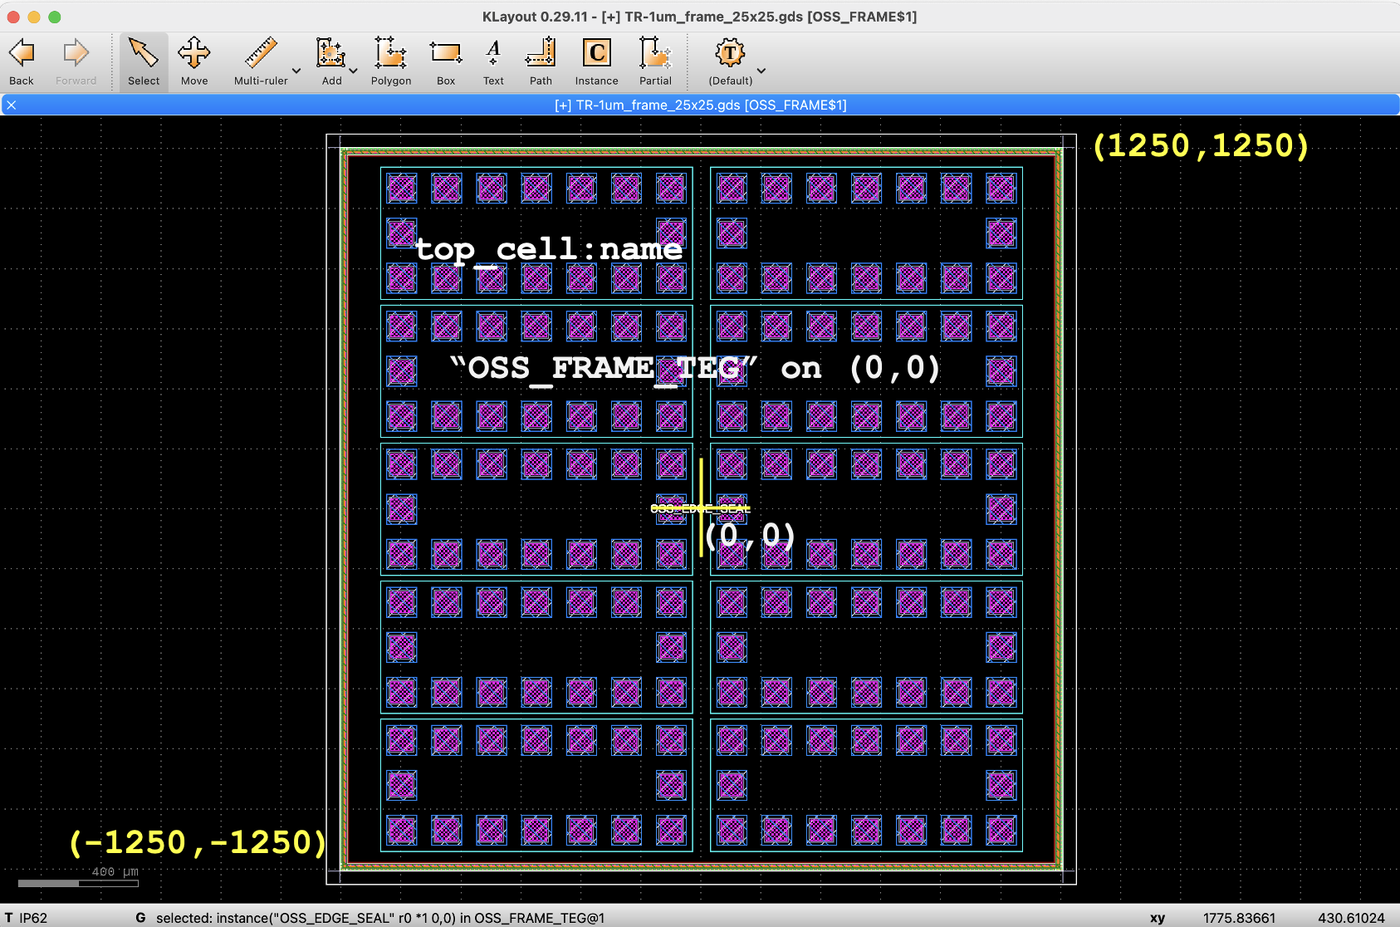
docs/OpenSUSI-MPW-TEG.png
