jun1okamura/TR-1um_SCLK_SPI/docs/cell_usage.md

# STDCELL 利用リスト — tr_1um_3wire_SPI

配置: `layout/placement_nrow_fm.json`  (2行 × 1620.0 µm)

ライブラリ: `lef/TR-1um_STDCELL.lef` — マクロ 31種、うち **使用 16種 / 未使用 15種**

## 論理セル

| セル | 個数 | W × H (µm) | 面積/個 (µm²) | 面積計 (µm²) | Tr/個 | Tr計 | 信号ピン |
|---|---:|---|---:|---:|---:|---:|---|
| `MUXDFFRB` | 15 | 97.2 × 64.8 | 6,299 | 94,478 | 38 | 570 | S,A,B,QB,RSTB,Q,CK |
| `DFFRB` | 5 | 64.8 × 64.8 | 4,199 | 20,995 | 26 | 130 | D,QB,RSTB,Q,CK |
| `BUF_X2` | 4 | 16.2 × 64.8 | 1,050 | 4,199 | 6 | 24 | A,Y |
| `BUFTH` | 3 | 32.4 × 64.8 | 2,100 | 6,299 | 8 | 24 | A,Y |
| `AND2_X1` | 2 | 21.6 × 64.8 | 1,400 | 2,799 | 6 | 12 | A,B,Y |
| `XOR2` | 2 | 27.0 × 64.8 | 1,750 | 3,499 | 10 | 20 | A,B,Y |
| `NOR4` | 2 | 27.0 × 64.8 | 1,750 | 3,499 | 8 | 16 | A,B,C,D,Y |
| `NOR2` | 2 | 16.2 × 64.8 | 1,050 | 2,100 | 4 | 8 | A,B,Y |
| `INV_X1` | 2 | 10.8 × 64.8 | 700 | 1,400 | 2 | 4 | A,Y |
| `XNOR2` | 1 | 27.0 × 64.8 | 1,750 | 1,750 | 10 | 10 | A,B,Y |
| `NAND2` | 1 | 16.2 × 64.8 | 1,050 | 1,050 | 4 | 4 | A,B,Y |
| `OR3` | 1 | 27.0 × 64.8 | 1,750 | 1,750 | 8 | 8 | A,B,C,Y |
| `MUX2` | 1 | 32.4 × 64.8 | 2,100 | 2,100 | 12 | 12 | S,A,B,Y |
| **計** | **41** | | | **145,917** | | **842** | |

## 物理セル(TAP / FILL)

`scripts/place.py` が配置。`TAP2` は x = 0 / 534.6 / 1069.2 / 1609.2 の固定位置、その直後の `FILL2` は優先M2コリドー(`FILLPRI_*`)としてルータが行またぎの着地点に使う。

| セル | 個数 | W × H (µm) | 面積/個 (µm²) | 面積計 (µm²) | Tr/個 | Tr計 | 信号ピン |
|---|---:|---|---:|---:|---:|---:|---|
| `FILL3` | 49 | 16.2 × 64.8 | 1,050 | 51,438 | 2 | 98 |  |
| `FILL2` | 10 | 10.8 × 64.8 | 700 | 6,998 | 2 | 20 |  |
| `TAP2` | 8 | 10.8 × 64.8 | 700 | 5,599 | 0 | 0 |  |
| **計** | **67** | | | **64,035** | | **118** | |

## サマリ

| | 論理 | 物理 | 合計 |
|---|---:|---:|---:|
| インスタンス数 | 41 | 67 | 108 |
| セル面積 (µm²) | 145,917 | 64,035 | 209,952 |
| トランジスタ数 | 842 | 118 | 960 |

**等価ゲート数(論理セルのみ): 210** (`NAND2` = 4 Tr = 1 ゲート)

## 未使用のライブラリセル

| セル | W × H (µm) | Tr | 備考 |
|---|---|---:|---|
| `AND3_X1` | 27.0 × 64.8 | 8 | 合成で選ばれなかった |
| `AND4_X1` | 32.4 × 64.8 | 10 | 合成で選ばれなかった |
| `BUF_X1` | 16.2 × 64.8 | 4 | 行バッファは `BUF_X2` を採用(同フットプリントで2倍ドライブ) |
| `BUF_X16` | 16.2 × 64.8 | 10 | LEFにMACROはあるがGDS未実装 |
| `BUF_X4` | 16.2 × 64.8 | 8 | LEFにMACROはあるがGDS未実装 |
| `DEL1` | 32.4 × 64.8 | 8 | 遅延セル。純同期設計なので不要 |
| `DFF` | 64.8 × 64.8 | 24 | 非同期リセット無し。本設計は全FFが `RSTN` 必須 |
| `DFFS` | 64.8 × 64.8 | 26 | セット付きFF。本設計はリセットのみ |
| `NAND3` | 21.6 × 64.8 | 6 | 合成で選ばれなかった |
| `NAND4` | 27.0 × 64.8 | 8 | 合成で選ばれなかった |
| `NOR3` | 21.6 × 64.8 | 6 | 合成で選ばれなかった |
| `OR2` | 21.6 × 64.8 | 6 | 合成で選ばれなかった |
| `OR4` | 32.4 × 64.8 | 10 | 合成で選ばれなかった |
| `RSLATCH` | 27.0 × 64.8 | 8 | ラッチ。本設計は純同期のFFのみ |
| `TAP3` | 16.2 × 64.8 | 0 | `TAP2` で足りている |
