jun1okamura/TR-1um_SCLK_SPI/reference/v64_8/layout/chip/step2_routed.png

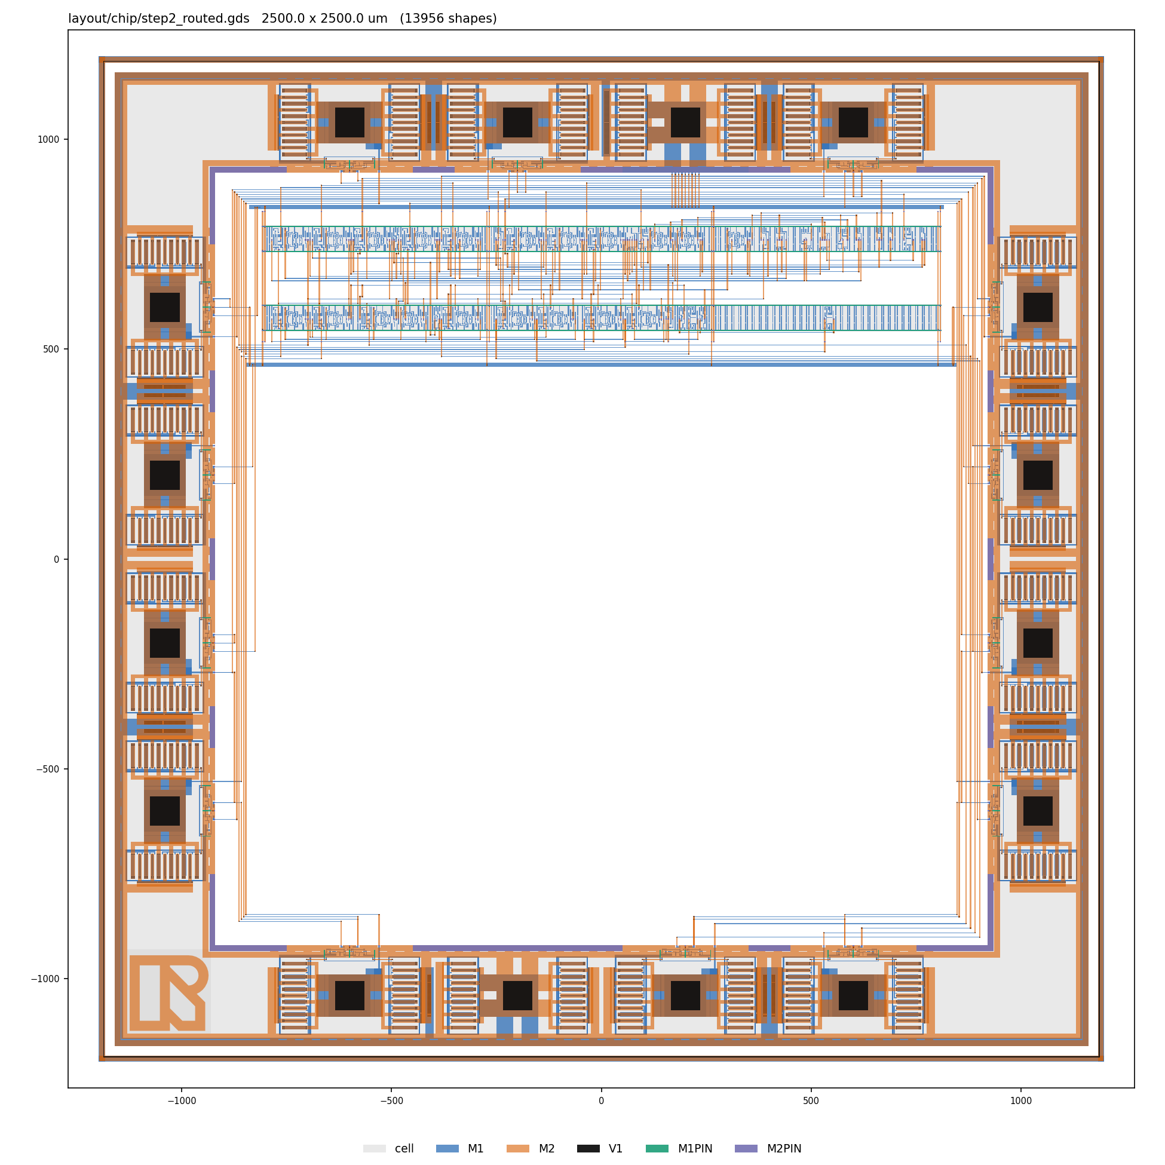
reference/v64_8/layout/chip/step2_routed.png
