jun1okamura/TR-1um_SCLK_SPI/reference/v64_8/layout/chip/step4_final.png

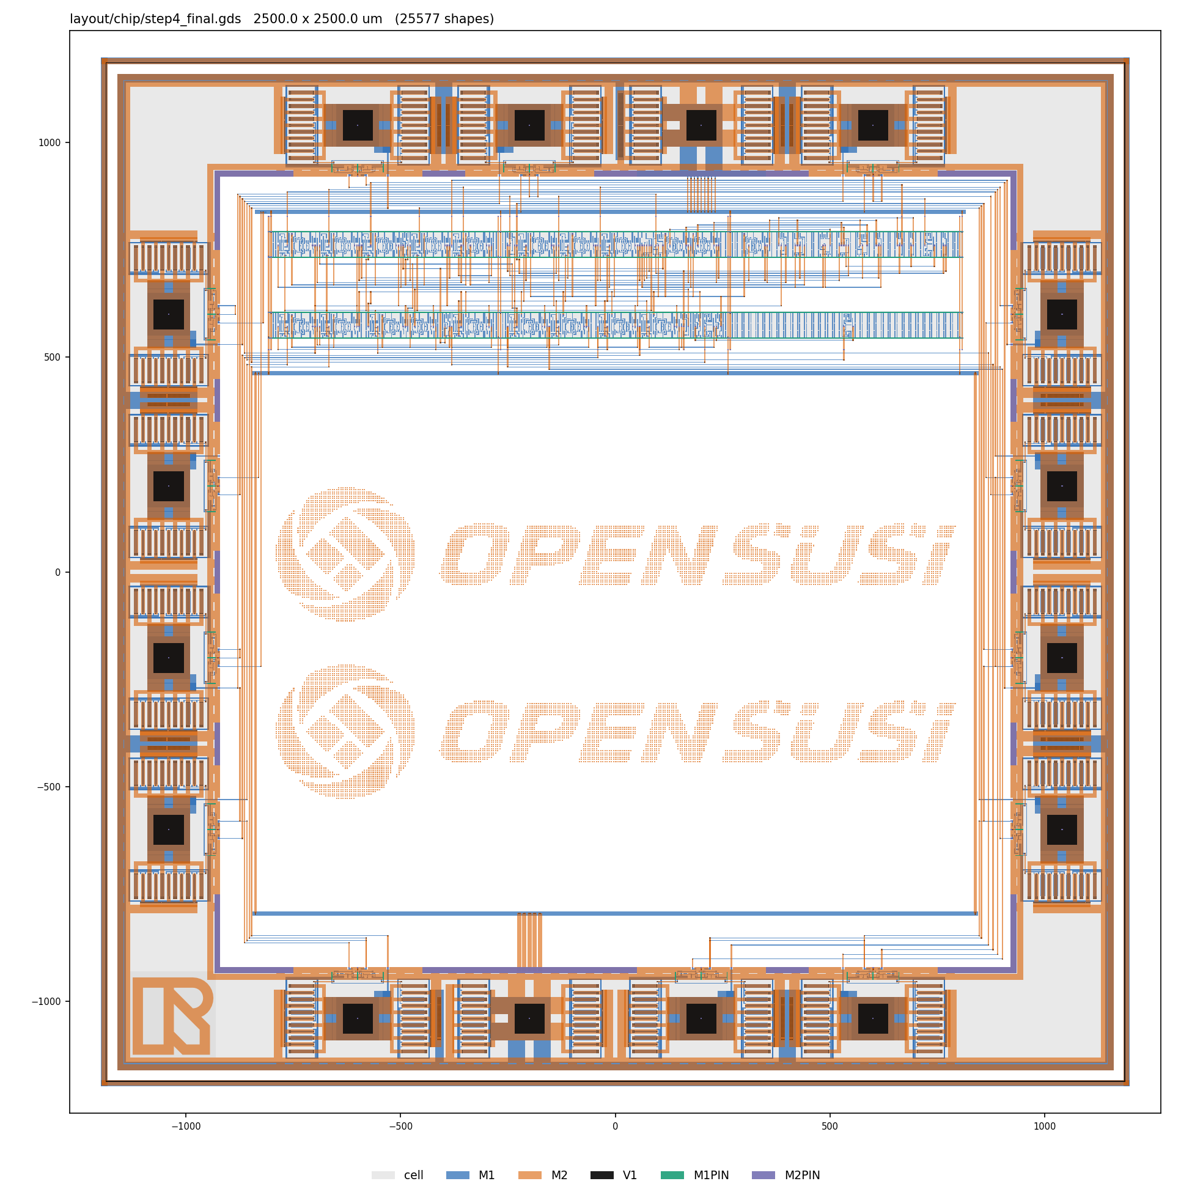
reference/v64_8/layout/chip/step4_final.png
