jun1okamura/TR-1um_SCLK_SPI/reference/v64_8/layout/routing_steps.png

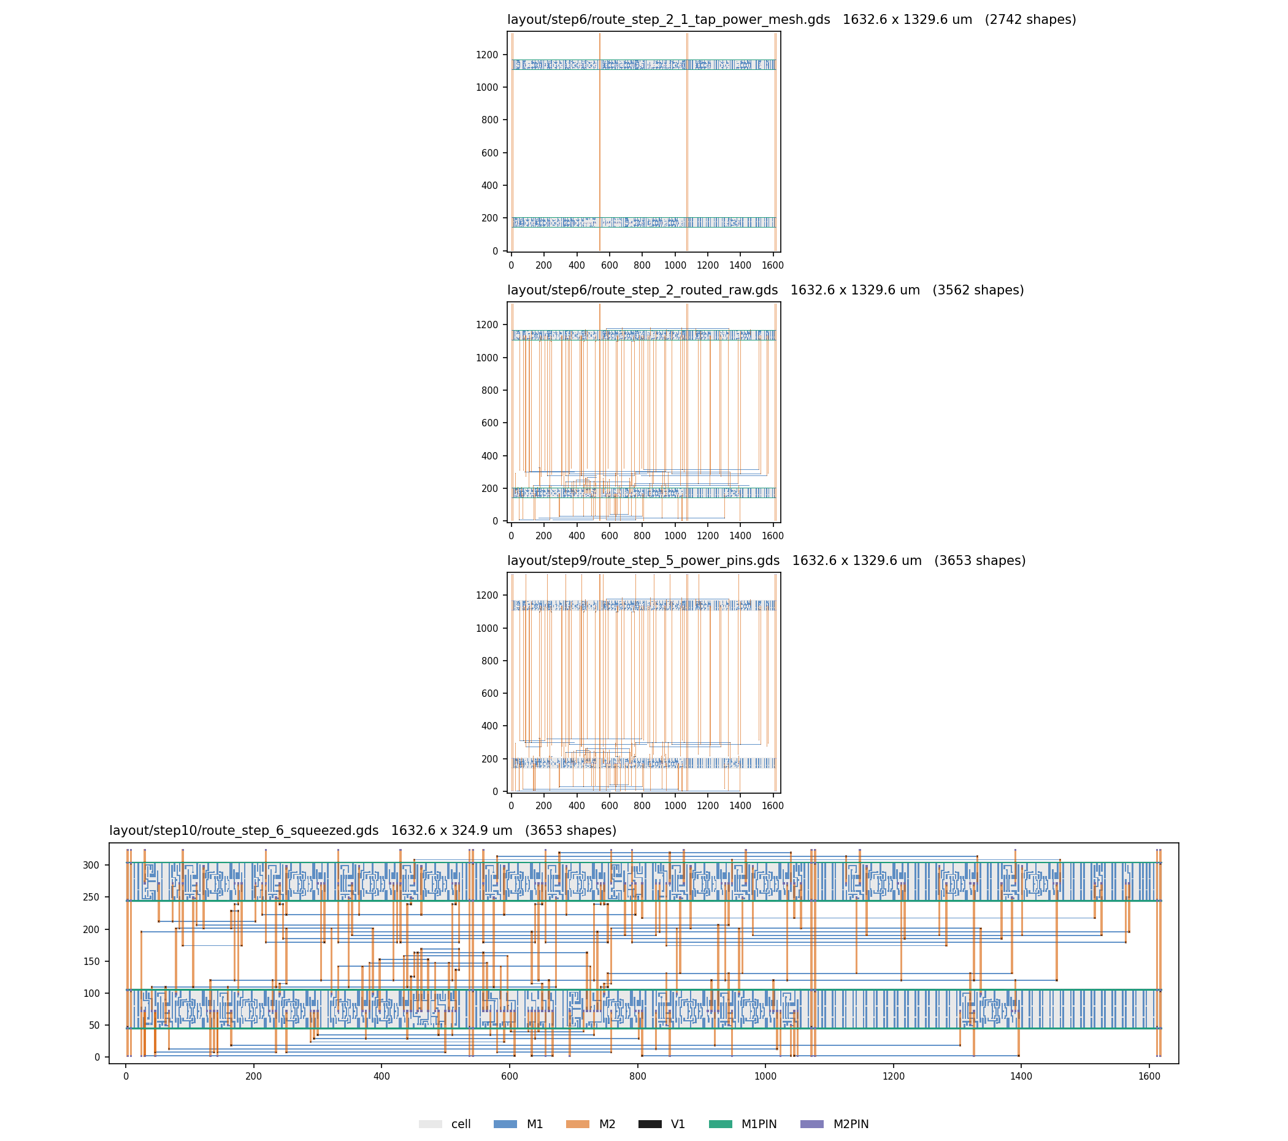
reference/v64_8/layout/routing_steps.png
