jun1okamura/TR-1um_SCLK_SPI/layout/chip/simulation/tr_1um_3wire_SPI_extracted.spice

* TR-1um tr_1um_3wire_SPI — KLayout 抽出 (scripts/klayout_extract.py)

* cell tr_1um_3wire_SPI
* pin P1
* pin P10
* pin P11
* pin P12
* pin P13
* pin P14
* pin P15
* pin P2
* pin P3
* pin P4
* pin P5
* pin P6
* pin P7
* pin P9
* pin VDD
* pin VSS
.SUBCKT tr_1um_3wire_SPI P1 P10 P11 P12 P13 P14 P15 P2 P3 P4 P5 P6 P7 P9 VDD VSS
* cell instance $1 r0 *1 -799.2,-154.35
X$1 VDD \$9 P3 P5 \$28 P15 \$20 \$11 P7 P9 P6 P10 \$94 \$38 \$95 \$54 \$26
+ \$122 P2 P1 P12 P11 P13 P14 \$103 VSS spi_slave_sclk
* cell instance $2 r0 *1 0,0
X$2 VDD P5 P5 P5 VDD \$122 VDD VDD VDD VSS P5 P5 P5 P5 P5 P2 P1 P15 VSS P3 P4
+ \$9 VSS P5 P6 \$28 \$26 P7 \$20 P9 P10 \$11 \$38 P11 P12 \$54 \$94 P13 P14
+ \$95 VSS VSS \$103 VSS OSS_FRAME
.ENDS tr_1um_3wire_SPI

* cell OSS_FRAME
* pin VDD
* pin HIZ7
* pin HIZ13
* pin HIZ14
* pin HIZ3
* pin HIZ2
* pin HIZ1
* pin HIZ15
* pin HIZ5
* pin HIZ4
* pin HIZ6
* pin HIZ9
* pin HIZ10
* pin HIZ12
* pin HIZ11
* pin P2
* pin P1
* pin P15
* pin OUT3
* pin P3
* pin P4
* pin OUT4
* pin OUT5
* pin P5
* pin P6
* pin OUT6
* pin OUT7
* pin P7
* pin OUT9
* pin P9
* pin P10
* pin OUT10
* pin OUT11
* pin P11
* pin P12
* pin OUT12
* pin OUT13
* pin P13
* pin P14
* pin OUT14
* pin OUT15
* pin OUT1
* pin OUT2
* pin VSS
.SUBCKT OSS_FRAME VDD HIZ7 HIZ13 HIZ14 HIZ3 HIZ2 HIZ1 HIZ15 HIZ5 HIZ4 HIZ6 HIZ9
+ HIZ10 HIZ12 HIZ11 P2 P1 P15 OUT3 P3 P4 OUT4 OUT5 P5 P6 OUT6 OUT7 P7 OUT9 P9
+ P10 OUT10 OUT11 P11 P12 OUT12 OUT13 P13 P14 OUT14 OUT15 OUT1 OUT2 VSS
* cell instance $4 m45 *1 -1040,-600
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
* cell instance $259 r0 *1 307.8,64.1
X$259 \$38 data_oe \$41 \$108 \$37 vdd vss OR4
* cell instance $260 r0 *1 340.2,64.1
X$260 \$42 \$35 vdd vss BUF_X2
* cell instance $262 r0 *1 356.4,64.1
X$262 \$167 data_oe vdd \$28 vss AND2_X1
* cell instance $269 r0 *1 10.8,64.1
X$269 vdd vss FILL3
* cell instance $273 r0 *1 27,64.1
X$273 \$32 \$29 vdd byte_end vss NOR2
* cell instance $274 r0 *1 43.2,64.1
X$274 vdd cs_n \$32 vss BUFTH
* cell instance $275 r0 *1 75.6,64.1
X$275 \$36 \$46 \$37 vdd vss XOR2
* cell instance $277 r0 *1 102.6,64.1
X$277 \$36 \$37 \$38 \$29 vdd vss NAND3
* cell instance $278 r0 *1 124.2,64.1
X$278 dis \$32 \$29 \$35 vdd vss NOR3
* cell instance $279 r0 *1 145.8,64.1
X$279 \$36 vdd \$108 vss INV_X1
* cell instance $284 r0 *1 518.4,64.1
X$284 vdd vss FILL3
* cell instance $286 r0 *1 545.4,64.1
X$286 vdd vss FILL3
* cell instance $287 r0 *1 561.6,64.1
X$287 vdd vss FILL3
* cell instance $288 r0 *1 577.8,64.1
X$288 vdd vss FILL3
* cell instance $289 r0 *1 594,64.1
X$289 vdd vss FILL3
* cell instance $290 r0 *1 610.2,64.1
X$290 vdd vss FILL3
* cell instance $291 r0 *1 626.4,64.1
X$291 vdd vss FILL3
* cell instance $292 r0 *1 642.6,64.1
X$292 vdd vss FILL3
* cell instance $293 r0 *1 658.8,64.1
X$293 vdd vss FILL3
* cell instance $294 r0 *1 675,64.1
X$294 vdd vss FILL2
* cell instance $299 r0 *1 426.6,64.1
X$299 vdd vss FILL3
* cell instance $300 r0 *1 442.8,64.1
X$300 vdd vss FILL3
* cell instance $301 r0 *1 410.4,64.1
X$301 vdd vss FILL3
* cell instance $302 r0 *1 459,64.1
X$302 vdd vss FILL3
* cell instance $303 r0 *1 475.2,64.1
X$303 vdd vss FILL3
* cell instance $304 r0 *1 685.8,64.1
X$304 vdd vss FILL2
* cell instance $305 r0 *1 491.4,64.1
X$305 vdd vss FILL3
* cell instance $307 r0 *1 507.6,64.1
X$307 vdd vss FILL2
.ENDS spi_slave_sclk

* cell NOR3
* pin A
* pin B
* pin C
* pin Y
* pin vdd
* pin vss
.SUBCKT NOR3 A B C Y vdd vss
* device instance $1 r0 *1 4,47.8 PMOS
XM$1 \$8 A vdd vdd PMOS L=1U W=10.2U AS=28.56P AD=6.12P PS=26U PD=11.4U
* device instance $2 r0 *1 6.2,47.8 PMOS
XM$2 \$7 B \$8 vdd PMOS L=1U W=10.2U AS=6.12P AD=6.12P PS=11.4U PD=11.4U
* device instance $3 r0 *1 8.4,47.8 PMOS
XM$3 Y C \$7 vdd PMOS L=1U W=10.2U AS=6.12P AD=28.56P PS=11.4U PD=26U
* device instance $4 r0 *1 4,8.2 NMOS
XM$4 Y A vss vss NMOS L=1U W=3.4U AS=9.52P AD=5.1P PS=12.4U PD=6.4U
* device instance $5 r0 *1 8,8.2 NMOS
XM$5 vss B Y vss NMOS L=1U W=3.4U AS=5.1P AD=5.1P PS=6.4U PD=6.4U
* device instance $6 r0 *1 12,8.2 NMOS
XM$6 Y C vss vss NMOS L=1U W=3.4U AS=5.1P AD=9.52P PS=6.4U PD=12.4U
.ENDS NOR3

* cell NAND3
* pin A
* pin B
* pin C
* pin Y
* pin vdd
* pin vss
.SUBCKT NAND3 A B C Y vdd vss
* device instance $1 r0 *1 4,47.8 PMOS
XM$1 Y A vdd vdd PMOS L=1U W=10.2U AS=28.56P AD=15.3P PS=26U PD=13.2U
* device instance $2 r0 *1 8,47.8 PMOS
XM$2 vdd B Y vdd PMOS L=1U W=10.2U AS=15.3P AD=15.3P PS=13.2U PD=13.2U
* device instance $3 r0 *1 12,47.8 PMOS
XM$3 Y C vdd vdd PMOS L=1U W=10.2U AS=15.3P AD=28.56P PS=13.2U PD=26U
* device instance $4 r0 *1 8.6,8.2 NMOS
XM$4 \$8 A vss vss NMOS L=1U W=3.4U AS=9.52P AD=2.04P PS=12.4U PD=4.6U
* device instance $5 r0 *1 10.8,8.2 NMOS
XM$5 \$7 B \$8 vss NMOS L=1U W=3.4U AS=2.04P AD=2.04P PS=4.6U PD=4.6U
* device instance $6 r0 *1 13,8.2 NMOS
XM$6 Y C \$7 vss NMOS L=1U W=3.4U AS=2.04P AD=9.52P PS=4.6U PD=12.4U
.ENDS NAND3

* cell NOR2
* pin A
* pin B
* pin vdd
* pin Y
* pin vss
.SUBCKT NOR2 A B vdd Y vss
* device instance $1 r0 *1 4,47.8 PMOS
XM$1 \$6 A vdd vdd PMOS L=1U W=10.2U AS=28.56P AD=6.12P PS=26U PD=11.4U
* device instance $2 r0 *1 6.2,47.8 PMOS
XM$2 Y B \$6 vdd PMOS L=1U W=10.2U AS=6.12P AD=28.56P PS=11.4U PD=26U
* device instance $3 r0 *1 4,8.2 NMOS
XM$3 Y A vss vss NMOS L=1U W=3.4U AS=9.52P AD=5.1P PS=12.4U PD=6.4U
* device instance $4 r0 *1 8,8.2 NMOS
XM$4 vss B Y vss NMOS L=1U W=3.4U AS=5.1P AD=9.52P PS=6.4U PD=12.4U
.ENDS NOR2

* cell BUF_X2
* pin Y
* pin A
* pin vdd
* pin vss
.SUBCKT BUF_X2 Y A vdd vss
* device instance $1 r0 *1 4,47.8 PMOS
XM$1 vdd A \$2 vdd PMOS L=1U W=10.2U AS=28.56P AD=15.3P PS=26U PD=13.2U
* device instance $2 r0 *1 8,47.8 PMOS
XM$2 Y \$2 vdd vdd PMOS L=1U W=20.4U AS=30.6P AD=43.86P PS=26.4U PD=39.2U
* device instance $4 r0 *1 4,8.2 NMOS
XM$4 vss A \$2 vss NMOS L=1U W=3.4U AS=9.52P AD=5.1P PS=12.4U PD=6.4U
* device instance $5 r0 *1 8,8.2 NMOS
XM$5 Y \$2 vss vss NMOS L=1U W=6.8U AS=10.2P AD=14.62P PS=12.8U PD=18.8U
.ENDS BUF_X2

* cell OR4
* pin C
* pin D
* pin Y
* pin A
* pin B
* pin vdd
* pin vss
.SUBCKT OR4 C D Y A B vdd vss
* device instance $1 r0 *1 4,47.8 PMOS
XM$1 \$9 A \$2 vdd PMOS L=1U W=10.2U AS=28.56P AD=6.12P PS=26U PD=11.4U
* device instance $2 r0 *1 6.2,47.8 PMOS
XM$2 \$11 B \$9 vdd PMOS L=1U W=10.2U AS=6.12P AD=6.12P PS=11.4U PD=11.4U
* device instance $3 r0 *1 8.4,47.8 PMOS
XM$3 \$10 C \$11 vdd PMOS L=1U W=10.2U AS=6.12P AD=6.12P PS=11.4U PD=11.4U
* device instance $4 r0 *1 10.6,47.8 PMOS
XM$4 vdd D \$10 vdd PMOS L=1U W=10.2U AS=6.12P AD=15.3P PS=11.4U PD=13.2U
* device instance $5 r0 *1 14.6,47.8 PMOS
XM$5 Y \$2 vdd vdd PMOS L=1U W=10.2U AS=15.3P AD=28.56P PS=13.2U PD=26U
* device instance $6 r0 *1 4,8.2 NMOS
XM$6 \$2 A vss vss NMOS L=1U W=3.4U AS=9.52P AD=5.1P PS=12.4U PD=6.4U
* device instance $7 r0 *1 8,8.2 NMOS
XM$7 vss B \$2 vss NMOS L=1U W=3.4U AS=5.1P AD=5.1P PS=6.4U PD=6.4U
* device instance $8 r0 *1 12,8.2 NMOS
XM$8 \$2 C vss vss NMOS L=1U W=3.4U AS=5.1P AD=5.1P PS=6.4U PD=6.4U
* device instance $9 r0 *1 16,8.2 NMOS
XM$9 vss D \$2 vss NMOS L=1U W=3.4U AS=5.1P AD=5.1P PS=6.4U PD=6.4U
* device instance $10 r0 *1 20,8.2 NMOS
XM$10 Y \$2 vss vss NMOS L=1U W=3.4U AS=5.1P AD=9.52P PS=6.4U PD=12.4U
.ENDS OR4

* cell INV_X2
* pin A
* pin vdd
* pin Y
* pin vss
.SUBCKT INV_X2 A vdd Y vss
* device instance $1 r0 *1 4,44.8 PMOS
XM$1 Y A vdd vdd PMOS L=1U W=16.2U AS=45.36P AD=45.36P PS=38U PD=38U
* device instance $2 r0 *1 5.4,9.8 NMOS
XM$2 Y A vss vss NMOS L=1U W=6.6U AS=18.48P AD=18.48P PS=18.8U PD=18.8U
.ENDS INV_X2

* cell INV_X1
* pin A
* pin vdd
* pin Y
* pin vss
.SUBCKT INV_X1 A vdd Y vss
* device instance $1 r0 *1 4,47.8 PMOS
XM$1 Y A vdd vdd PMOS L=1U W=10.2U AS=28.56P AD=28.56P PS=26U PD=26U
* device instance $2 r0 *1 5.4,8.2 NMOS
XM$2 Y A vss vss NMOS L=1U W=3.4U AS=9.52P AD=9.52P PS=12.4U PD=12.4U
.ENDS INV_X1

* cell AND2_X1
* pin A
* pin B
* pin vdd
* pin Y
* pin vss
.SUBCKT AND2_X1 A B vdd Y vss
* device instance $1 r0 *1 4,47.8 PMOS
XM$1 \$3 A vdd vdd PMOS L=1U W=10.2U AS=28.56P AD=15.3P PS=26U PD=13.2U
* device instance $2 r0 *1 8,47.8 PMOS
XM$2 vdd B \$3 vdd PMOS L=1U W=10.2U AS=15.3P AD=15.3P PS=13.2U PD=13.2U
* device instance $3 r0 *1 12,47.8 PMOS
XM$3 Y \$3 vdd vdd PMOS L=1U W=10.2U AS=15.3P AD=28.56P PS=13.2U PD=26U
* device instance $4 r0 *1 8.6,17.9 NMOS
XM$4 \$7 A vss vss NMOS L=1U W=3.4U AS=9.52P AD=2.04P PS=12.4U PD=4.6U
* device instance $5 r0 *1 10.8,17.9 NMOS
XM$5 \$3 B \$7 vss NMOS L=1U W=3.4U AS=2.04P AD=9.52P PS=4.6U PD=12.4U
* device instance $6 r0 *1 16.2,9.4 NMOS
XM$6 Y \$3 vss vss NMOS L=1U W=3.4U AS=35.36P AD=9.52P PS=27.6U PD=12.4U
.ENDS AND2_X1

* cell XOR2
* pin A
* pin Y
* pin B
* pin vdd
* pin vss
.SUBCKT XOR2 A Y B vdd vss
* device instance $1 r0 *1 14.2,46.8 PMOS
XM$1 \$8 \$3 Y vdd PMOS L=1U W=10.2U AS=28.56P AD=15.3P PS=26U PD=13.2U
* device instance $2 r0 *1 18.2,46.8 PMOS
XM$2 vdd B \$8 vdd PMOS L=1U W=10.2U AS=15.3P AD=15.3P PS=13.2U PD=13.2U
* device instance $3 r0 *1 22.2,46.8 PMOS
XM$3 \$8 A vdd vdd PMOS L=1U W=10.2U AS=15.3P AD=28.56P PS=13.2U PD=26U
* device instance $4 r0 *1 4,46.8 PMOS
XM$4 \$9 A vdd vdd PMOS L=1U W=10.2U AS=28.56P AD=6.12P PS=26U PD=11.4U
* device instance $5 r0 *1 6.2,46.8 PMOS
XM$5 \$3 B \$9 vdd PMOS L=1U W=10.2U AS=6.12P AD=28.56P PS=11.4U PD=26U
* device instance $6 r0 *1 16,9.2 NMOS
XM$6 vss \$3 Y vss NMOS L=1U W=3.4U AS=9.52P AD=5.1P PS=12.4U PD=6.4U
* device instance $7 r0 *1 20,9.2 NMOS
XM$7 \$5 B vss vss NMOS L=1U W=3.4U AS=5.1P AD=2.04P PS=6.4U PD=4.6U
* device instance $8 r0 *1 22.2,9.2 NMOS
XM$8 Y A \$5 vss NMOS L=1U W=3.4U AS=2.04P AD=9.52P PS=4.6U PD=12.4U
* device instance $9 r0 *1 4,9.2 NMOS
XM$9 vss A \$3 vss NMOS L=1U W=3.4U AS=9.52P AD=5.1P PS=12.4U PD=6.4U
* device instance $10 r0 *1 8,9.2 NMOS
XM$10 \$3 B vss vss NMOS L=1U W=3.4U AS=5.1P AD=9.52P PS=6.4U PD=12.4U
.ENDS XOR2

* cell BUFTH
* pin vdd
* pin A
* pin Y
* pin vss
.SUBCKT BUFTH vdd A Y vss
* device instance $1 r0 *1 10.8,47.85 PMOS
XM$1 \$7 \$5 vss vdd PMOS L=1U W=10.2U AS=21.93P AD=21.93P PS=23.9U PD=23.9U
* device instance $3 r0 *1 26,41.7 PMOS
XM$3 Y \$5 vdd vdd PMOS L=1U W=10.2U AS=28.56P AD=28.56P PS=26U PD=26U
* device instance $4 r0 *1 10.8,39.15 PMOS
XM$4 \$7 A \$5 vdd PMOS L=1U W=5.1U AS=14.28P AD=7.65P PS=15.8U PD=8.1U
* device instance $5 r0 *1 14.8,39.15 PMOS
XM$5 vdd A \$7 vdd PMOS L=1U W=5.1U AS=7.65P AD=14.28P PS=8.1U PD=15.8U
* device instance $6 r0 *1 26,17.9 NMOS
XM$6 Y \$5 vss vss NMOS L=1U W=3.4U AS=9.52P AD=9.52P PS=12.4U PD=12.4U
* device instance $7 r0 *1 10.8,17.9 NMOS
XM$7 \$3 A \$5 vss NMOS L=1U W=3.4U AS=9.52P AD=5.1P PS=12.4U PD=6.4U
* device instance $8 r0 *1 14.8,17.9 NMOS
XM$8 vss A \$3 vss NMOS L=1U W=3.4U AS=5.1P AD=9.52P PS=6.4U PD=12.4U
* device instance $9 r0 *1 10.8,10 NMOS
XM$9 \$3 \$5 vdd vss NMOS L=1U W=6.8U AS=14.62P AD=14.62P PS=18.8U PD=18.8U
.ENDS BUFTH

* cell OR3
* pin A
* pin B
* pin C
* pin Y
* pin vdd
* pin vss
.SUBCKT OR3 A B C Y vdd vss
* device instance $1 r0 *1 4,47.8 PMOS
XM$1 \$9 A \$2 vdd PMOS L=1U W=10.2U AS=28.56P AD=6.12P PS=26U PD=11.4U
* device instance $2 r0 *1 6.2,47.8 PMOS
XM$2 \$8 B \$9 vdd PMOS L=1U W=10.2U AS=6.12P AD=6.12P PS=11.4U PD=11.4U
* device instance $3 r0 *1 8.4,47.8 PMOS
XM$3 vdd C \$8 vdd PMOS L=1U W=10.2U AS=6.12P AD=15.3P PS=11.4U PD=13.2U
* device instance $4 r0 *1 12.4,47.8 PMOS
XM$4 Y \$2 vdd vdd PMOS L=1U W=10.2U AS=15.3P AD=28.56P PS=13.2U PD=26U
* device instance $5 r0 *1 4,8.2 NMOS
XM$5 vss A \$2 vss NMOS L=1U W=3.4U AS=9.52P AD=5.1P PS=12.4U PD=6.4U
* device instance $6 r0 *1 8,8.2 NMOS
XM$6 \$2 B vss vss NMOS L=1U W=3.4U AS=5.1P AD=5.1P PS=6.4U PD=6.4U
* device instance $7 r0 *1 12,8.2 NMOS
XM$7 vss C \$2 vss NMOS L=1U W=3.4U AS=5.1P AD=5.1P PS=6.4U PD=6.4U
* device instance $8 r0 *1 16,8.2 NMOS
XM$8 Y \$2 vss vss NMOS L=1U W=3.4U AS=5.1P AD=9.52P PS=6.4U PD=12.4U
.ENDS OR3

* cell NAND2
* pin A
* pin B
* pin Y
* pin vdd
* pin vss
.SUBCKT NAND2 A B Y vdd vss
* device instance $1 r0 *1 4,47.8 PMOS
XM$1 Y A vdd vdd PMOS L=1U W=10.2U AS=28.56P AD=15.3P PS=26U PD=13.2U
* device instance $2 r0 *1 8,47.8 PMOS
XM$2 vdd B Y vdd PMOS L=1U W=10.2U AS=15.3P AD=28.56P PS=13.2U PD=26U
* device instance $3 r0 *1 8.6,8.2 NMOS
XM$3 \$6 A vss vss NMOS L=1U W=3.4U AS=9.52P AD=2.04P PS=12.4U PD=4.6U
* device instance $4 r0 *1 10.8,8.2 NMOS
XM$4 Y B \$6 vss NMOS L=1U W=3.4U AS=2.04P AD=9.52P PS=4.6U PD=12.4U
.ENDS NAND2

* cell XNOR2
* pin A
* pin Y
* pin B
* pin vdd
* pin vss
.SUBCKT XNOR2 A Y B vdd vss
* device instance $1 r0 *1 16,46.8 PMOS
XM$1 vdd \$3 Y vdd PMOS L=1U W=10.2U AS=28.56P AD=15.3P PS=26U PD=13.2U
* device instance $2 r0 *1 20,46.8 PMOS
XM$2 \$9 B vdd vdd PMOS L=1U W=10.2U AS=15.3P AD=6.12P PS=13.2U PD=11.4U
* device instance $3 r0 *1 22.2,46.8 PMOS
XM$3 Y A \$9 vdd PMOS L=1U W=10.2U AS=6.12P AD=28.56P PS=11.4U PD=26U
* device instance $4 r0 *1 4,46.8 PMOS
XM$4 vdd A \$3 vdd PMOS L=1U W=10.2U AS=28.56P AD=15.3P PS=26U PD=13.2U
* device instance $5 r0 *1 8,46.8 PMOS
XM$5 \$3 B vdd vdd PMOS L=1U W=10.2U AS=15.3P AD=28.56P PS=13.2U PD=26U
* device instance $6 r0 *1 14.2,9.2 NMOS
XM$6 \$5 \$3 Y vss NMOS L=1U W=3.4U AS=9.52P AD=5.1P PS=12.4U PD=6.4U
* device instance $7 r0 *1 18.2,9.2 NMOS
XM$7 vss B \$5 vss NMOS L=1U W=3.4U AS=5.1P AD=5.1P PS=6.4U PD=6.4U
* device instance $8 r0 *1 22.2,9.2 NMOS
XM$8 \$5 A vss vss NMOS L=1U W=3.4U AS=5.1P AD=9.52P PS=6.4U PD=12.4U
* device instance $9 r0 *1 4,9.2 NMOS
XM$9 \$6 A vss vss NMOS L=1U W=3.4U AS=9.52P AD=2.04P PS=12.4U PD=4.6U
* device instance $10 r0 *1 6.2,9.2 NMOS
XM$10 \$3 B \$6 vss NMOS L=1U W=3.4U AS=2.04P AD=9.52P PS=4.6U PD=12.4U
.ENDS XNOR2

* cell DFFRB
* pin QB
* pin D
* pin RSTB
* pin Q
* pin vdd
* pin CK
* pin vss
.SUBCKT DFFRB QB D RSTB Q vdd CK vss
* device instance $1 r0 *1 60.3,45.8 PMOS
XM$1 Q QB vdd vdd PMOS L=1U W=10.4U AS=29.12P AD=29.12P PS=32U PD=32U
* device instance $2 r0 *1 48.2,45.8 PMOS
XM$2 QB QS vdd vdd PMOS L=1U W=10.4U AS=27.56P AD=15.6P PS=26.2U PD=16.4U
* device instance $3 r0 *1 52.2,45.8 PMOS
XM$3 vdd RSTB QB vdd PMOS L=1U W=10.4U AS=15.6P AD=29.12P PS=16.4U PD=32U
* device instance $4 r0 *1 4,41.8 PMOS
XM$4 vdd CK CKB vdd PMOS L=1U W=10.4U AS=29.12P AD=15.6P PS=26.4U PD=13.4U
* device instance $5 r0 *1 8,41.8 PMOS
XM$5 CKP CKB vdd vdd PMOS L=1U W=10.4U AS=15.6P AD=29.12P PS=13.4U PD=26.4U
* device instance $6 r0 *1 16,39.2 PMOS
XM$6 \$16 D vdd vdd PMOS L=1U W=5.2U AS=14.56P AD=3.12P PS=16U PD=6.4U
* device instance $7 r0 *1 18.2,39.2 PMOS
XM$7 \$7 CKP \$16 vdd PMOS L=1U W=5.2U AS=3.12P AD=7.8P PS=6.4U PD=8.2U
* device instance $8 r0 *1 22.2,39.2 PMOS
XM$8 \$8 CKB \$7 vdd PMOS L=1U W=5.2U AS=7.8P AD=7.8P PS=8.2U PD=8.2U
* device instance $9 r0 *1 26.2,39.2 PMOS
XM$9 vdd QM \$8 vdd PMOS L=1U W=5.2U AS=7.8P AD=7.8P PS=8.2U PD=8.2U
* device instance $10 r0 *1 30.2,39.2 PMOS
XM$10 QM \$7 vdd vdd PMOS L=1U W=5.2U AS=7.8P AD=7.8P PS=8.2U PD=8.2U
* device instance $11 r0 *1 34.2,39.2 PMOS
XM$11 QS CKB QM vdd PMOS L=1U W=5.2U AS=7.8P AD=7.8P PS=8.2U PD=8.2U
* device instance $12 r0 *1 38.2,39.2 PMOS
XM$12 \$10 CKP QS vdd PMOS L=1U W=5.2U AS=7.8P AD=7.8P PS=8.2U PD=8.2U
* device instance $13 r0 *1 42.2,39.2 PMOS
XM$13 vdd QB \$10 vdd PMOS L=1U W=5.2U AS=7.8P AD=13P PS=8.2U PD=10.2U
* device instance $17 r0 *1 60.3,17.9 NMOS
XM$17 Q QB vss vss NMOS L=1U W=3.4U AS=9.52P AD=9.52P PS=12.4U PD=12.4U
* device instance $18 r0 *1 16,17.9 NMOS
XM$18 \$13 D vss vss NMOS L=1U W=3.4U AS=9.52P AD=2.04P PS=12.4U PD=4.6U
* device instance $19 r0 *1 18.2,17.9 NMOS
XM$19 \$7 CKB \$13 vss NMOS L=1U W=3.4U AS=2.04P AD=5.1P PS=4.6U PD=6.4U
* device instance $20 r0 *1 22.2,17.9 NMOS
XM$20 \$8 CKP \$7 vss NMOS L=1U W=3.4U AS=5.1P AD=5.1P PS=6.4U PD=6.4U
* device instance $21 r0 *1 26.2,17.9 NMOS
XM$21 vss QM \$8 vss NMOS L=1U W=3.4U AS=5.1P AD=5.1P PS=6.4U PD=6.4U
* device instance $22 r0 *1 30.2,17.9 NMOS
XM$22 QM \$7 vss vss NMOS L=1U W=3.4U AS=5.1P AD=5.1P PS=6.4U PD=6.4U
* device instance $23 r0 *1 34.2,17.9 NMOS
XM$23 QS CKP QM vss NMOS L=1U W=3.4U AS=5.1P AD=5.1P PS=6.4U PD=6.4U
* device instance $24 r0 *1 38.2,17.9 NMOS
XM$24 \$10 CKB QS vss NMOS L=1U W=3.4U AS=5.1P AD=5.1P PS=6.4U PD=6.4U
* device instance $25 r0 *1 42.2,17.9 NMOS
XM$25 vss QB \$10 vss NMOS L=1U W=3.4U AS=5.1P AD=8.5P PS=6.4U PD=8.4U
* device instance $26 r0 *1 48.2,17.9 NMOS
XM$26 \$14 QS vss vss NMOS L=1U W=3.4U AS=8.5P AD=2.21P PS=8.4U PD=4.7U
* device instance $27 r0 *1 50.5,17.9 NMOS
XM$27 QB RSTB \$14 vss NMOS L=1U W=3.4U AS=2.21P AD=9.52P PS=4.7U PD=12.4U
* device instance $28 r0 *1 4,17.9 NMOS
XM$28 vss CK CKB vss NMOS L=1U W=3.4U AS=9.52P AD=5.1P PS=12.4U PD=6.4U
* device instance $29 r0 *1 8,17.9 NMOS
XM$29 CKP CKB vss vss NMOS L=1U W=3.4U AS=5.1P AD=9.52P PS=6.4U PD=12.4U
.ENDS DFFRB

* cell FILL2
* pin vdd
* pin vss
.SUBCKT FILL2 vdd vss
* device instance $1 r0 *1 5.4,45 PMOS
XM$1 vdd vss vdd vdd PMOS L=3.2U W=15.8U AS=44.24P AD=44.24P PS=37.2U PD=37.2U
* device instance $2 r0 *1 5.4,13.05 NMOS
XM$2 vss vdd vss vss NMOS L=3.2U W=13.1U AS=36.68P AD=36.68P PS=31.8U PD=31.8U
.ENDS FILL2

* cell FILL3
* pin vdd
* pin vss
.SUBCKT FILL3 vdd vss
* device instance $1 r0 *1 8.1,45 PMOS
XM$1 vdd vss vdd vdd PMOS L=8.6U W=15.8U AS=44.24P AD=44.24P PS=37.2U PD=37.2U
* device instance $2 r0 *1 8.1,13.05 NMOS
XM$2 vss vdd vss vss NMOS L=8.6U W=13.1U AS=36.68P AD=36.68P PS=31.8U PD=31.8U
.ENDS FILL3

* cell MUX2
* pin S
* pin B
* pin A
* pin Y
* pin vdd
* pin vss
.SUBCKT MUX2 S B A Y vdd vss
* device instance $1 r0 *1 5.1,50.3 PMOS
XM$1 \$3 S vdd vdd PMOS L=1U W=5.2U AS=14.56P AD=14.56P PS=16U PD=16U
* device instance $2 r0 *1 27.3,42.2 PMOS
XM$2 Y \$5 vdd vdd PMOS L=1U W=11.2U AS=31.36P AD=31.36P PS=28U PD=28U
* device instance $3 r0 *1 5.1,39.2 PMOS
XM$3 \$4 A vdd vdd PMOS L=1U W=5.2U AS=14.56P AD=7.8P PS=16U PD=8.2U
* device instance $4 r0 *1 9.1,39.2 PMOS
XM$4 \$5 S \$4 vdd PMOS L=1U W=5.2U AS=7.8P AD=7.8P PS=8.2U PD=8.2U
* device instance $5 r0 *1 13.1,39.2 PMOS
XM$5 \$6 \$3 \$5 vdd PMOS L=1U W=5.2U AS=7.8P AD=7.8P PS=8.2U PD=8.2U
* device instance $6 r0 *1 17.1,39.2 PMOS
XM$6 vdd B \$6 vdd PMOS L=1U W=5.2U AS=7.8P AD=15.6P PS=8.2U PD=16.4U
* device instance $7 r0 *1 27.3,17.9 NMOS
XM$7 Y \$5 vss vss NMOS L=1U W=3.4U AS=9.52P AD=9.52P PS=12.4U PD=12.4U
* device instance $8 r0 *1 5.1,17.9 NMOS
XM$8 \$4 A vss vss NMOS L=1U W=3.4U AS=9.52P AD=5.1P PS=12.4U PD=6.4U
* device instance $9 r0 *1 9.1,17.9 NMOS
XM$9 \$5 \$3 \$4 vss NMOS L=1U W=3.4U AS=5.1P AD=5.1P PS=6.4U PD=6.4U
* device instance $10 r0 *1 13.1,17.9 NMOS
XM$10 \$6 S \$5 vss NMOS L=1U W=3.4U AS=5.1P AD=5.1P PS=6.4U PD=6.4U
* device instance $11 r0 *1 17.1,17.9 NMOS
XM$11 vss B \$6 vss NMOS L=1U W=3.4U AS=5.1P AD=9.52P PS=6.4U PD=12.4U
* device instance $12 r0 *1 11.5,8.2 NMOS
XM$12 \$3 S vss vss NMOS L=1U W=3.4U AS=10.2P AD=9.52P PS=12.8U PD=12.4U
.ENDS MUX2
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
