jun1okamura/TR-1um_SCLK_SPI/scripts/i2c_ref/fm_partition.py

"""
fm_partition.py

Fiduccia-Mattheyses min-cut hypergraph bipartitioning, used to replace the
section-37 "simple split" (naive cumulative-width bisection in netlist file
order) with a locality-aware row split. Goal: minimize cross-row nets (the
root cause of both the oversized shared middle channel, design_notes.md
37.2, and the long-M2-stub short-collision problem, 37.4), while keeping
the two partitions' total cell width balanced (needed for gen_placement_2row
.py's shared-TAP-grid packing to not waste excessive filler).

Hypergraph: nodes = netlist instances (weight = LEF cell width), hyperedges
= nets (an edge connects every instance with a pin on that net; nets that
touch 0 or 1 instance -- primary I/O stubs -- are dropped, they can't be
cut either way).

Algorithm: classic FM. Start from a seed partition (the old naive
cumulative-width split, already width-balanced -- 2338.2 vs 2284.2um, ~1.2%
apart -- so FM only needs to improve locality, not balance). Each pass:
repeatedly pick the unlocked node with the best gain (hyperedge gain
formula: moving v from side F to T removes a cut for any net where v was
the last node on F, and creates a new cut for any net where v is the first
node placed on T) whose move keeps both sides within `balance_tol` of 50%
by weight; lock it; record cumulative gain. At pass end, roll back to the
best-scoring prefix of the move sequence (standard FM local-optimum
escape). Repeat passes until a pass finds no improving prefix.
"""
import sys
from collections import defaultdict
from pathlib import Path

# 2026-09-02: made portable (was a hardcoded Claude-sandbox absolute
# path, broke the first time this chain was run locally on the user's
# own Mac -- see lef_parser.py's LEF_PATH for the same fix).
sys.path.insert(0, str(Path(__file__).resolve().parent))
from lef_parser import parse_lef  # noqa: E402
from netlist_parser import parse_netlist  # noqa: E402
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
