jun1okamura/TR-1um_SCLK_SPI/(commit log)

2026-09-07 3-wire SPI slave: RTL, synthesis, placement and routing
    SCLK-domain synchronous 3-wire (half-duplex) SPI slave for the OpenSUSI
    TR-1um MPW. Mode 0, MSB first, single 8-bit frame, no burst. MOSI/MISO are
    merged onto SDIO; DIS selects the frame direction and the DATA[7:0] pad
    direction, so no command byte and no R/W bit are needed. Same
    DATA[7:0]+DIS+RSTN interface as TR-1um_Async_I2C.
    Design
    - hdl/spi_slave_sclk.v core RTL
    - hdl/tr_1um_3wire_SPI.v chip top (pad map, BUFTH on SCLK/SDIO/CS)
    - 210 equivalent gates, 842 transistors, 41 cells, 20 flip-flops
    - core 1632.6 x 324.9 um = 0.5304 mm2 (35% of the I2C core)
    Verification
    - 12 testbenches / 187 checks, run against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
    [BUF_X2.sch]
2026-09-07 Record the unrouted scalar top-level ports as a known issue
    Only the tx_data/rx_data buses got pulled out to the core boundary; all
    nine scalar ports (sclk, cs_n, sdio_in, sdio_out, sdio_oe, dis, rstn,
    data_oe, byte_end) have no pin marker at all. The unrouted BUFTH inputs
    are a symptom: sclk/cs_n/sdio_in are exactly those cells' A-pin nets.
    Root cause is in highlight_top_pins_nrow_fm.py, which still carries the
    I2C design's port names:
    SCALAR_PORTS = ["rst_n", "scl", "sda_in", ...]
    BUS_PORTS = {"tx_data": 8, "rx_data": 8}
    None of this design's scalar ports are in that list, so gather_pins()
    never looks for them; BUS_PORTS happens to match, which is why the buses
    alone came through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
2026-09-07 Derive the top-level port lists from the netlist, and re-run P&R
    highlight_top_pins_nrow_fm.py still carried the I2C design's port names:
    gather_pins only looks for ports listed there, so every scalar port of this
    design was skipped in silence; BUS_PORTS happened to match bit for bit,
    which is why the tx_data/rx_data buses came out and the nine scalar ports,
    including the BUFTH input nets sclk/cs_n/sdio_in, did not.
    port_rules.py now rewrites those four containers to read the design's own
    input/output declarations, picking up whole-signal `assign port = net;`
    aliases as well: the union-find reso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
    [highlight_top_pins_nrow_fm.py, port_i2c_scripts.py, port_rules.py]
2026-09-07 Fix the stale LEF FOREIGN, take the DRC-clean BUF_X2, re-run P&R
    Building the standard-cell usage list turned up two problems, both of which
    had been hiding behind each other.
    The LEF declared
    MACRO BUF_X2
    FOREIGN BUF_X1 0.0 0.0 ;
    and the placement GDS builder picks the physical cell by FOREIGN, so the
    netlist said BUF_X2 while the layout carried BUF_X1's geometry. The
    footprint is identical, so placement, routing and DRC all stayed happy;
    LVS would have been the first thing to notice.
    With FOREIGN corrected and the real BUF_X2 finally in the layout, four M1
    spacing violations appeared - one per instance, all from inside the cell
    itself (1.300 um against a 1.400 um rule). The ear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
    [cell_usage.py, drc_check_cells.py]
2026-09-07 Generate the LVS reference netlist for the core from the P&R netlist
    layout/spi_slave_sclk_nrow_fm.spice is built mechanically from
    layout/spi_slave_sclk_net_pnr.v -- the same netlist the placer consumed --
    so what LVS compares against is, by construction, the circuit the 36
    testbench runs verified. This follows the I2C project's gen_lvs_spice_v10.py
    (kept unmodified under scripts/i2c_ref/), whose output passed a real KLayout
    LVS run: FILL2 emitted as a subcircuit call, FILL3's decap pair inline, power
    pins forced to the rails.
    Nothing about this design is hardcoded, unlike the I2C original: the top port
    list and directions come from the module header, per-cell SPICE pin order from
    each ce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
    [BUF_X2.sch]
2026-09-07 Cross-check the cell bodies against xschem's exports, and ship the netlist to simulation/
    layout/step10/simulation points at ~/.xschem/simulations, where xschem writes
    its own per-cell SPICE. Those files are the schematics' own output, so
    gen_cell_spice.py now compares every body it emits against <CELL>.spice there,
    device for device, and stops if they disagree. 12 of the 14 match exactly.
    Two differences are expected and reported rather than failed. MUXDFFRB's
    export is hierarchical (x1 DFFRB / x2 MUX2) while the layout draws it as one
    flat leaf cell, so the comparison flattens it the way the I2C flow did --
    x1_/x2_ prefixes on each call's private nodes -- and gets 38 devices on both
    si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
    [gen_cell_spice.py, gen_lvs_spice.py]
2026-09-07 Take BUF_X2's body from xschem's export, and expand m= when comparing
    BUF_X2.spice is exported now, so the last cell without a primary source has
    one. gen_cell_spice.py takes the body from xschem's own export for any cell
    the I2C .cir does not carry, falling back to LOCAL_BODIES only when neither
    exists; all 13 exported cells now match device for device.
    The export writes the output stage as one device with m=2 rather than as two
    parallel devices, which is how the PDK's own libs.tech/xschem BUF_X2.sch draws
    it against this same six-finger layout. Keeping that spelling is what makes
    the two sides line up: lef/BUF_X2.extracted (KLayout, device combining on)
    reports the output stage as a sin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
2026-09-07 Record the clean core LVS run
    KLayout LVS on layout/step10/route_step_6_squeezed.gds against
    layout/step10/simulation/spi_slave_sclk_nrow_fm.spice is clean. The
    extraction is kept as layout/step10/spi_slave_sclk_nrow_fm.extracted: 27 pins
    (25 signals plus VDD/GND) matching the reference one for one, and 13
    subcircuit types.
    The core is now DRC and LVS clean on its own. Antenna is the one KLayout
    check still open, and it depends on routed length, so it waits until the core
    is wired into the GIO frame.
    Claude-Session: https://claude.ai/code/session_012K4bsUHgYEq63Rfxj7qDmQ
2026-09-07 Re-synthesise the core with an active-low sdio_oe_n, and drop it into the GIO frame
    The SDIO pad's HIZ pin turns its driver ON when low, so an active-high sdio_oe
    could not reach it without an inverter -- one lone standard cell out in an
    80 um routing channel, needing its own rails tied into the power mesh. The
    core emits the inverse instead:
    assign sdio_oe_n = ~(dis & ~cs_n); // 0 = drive
    That costs almost nothing. The gate producing this signal was a NOR2 and is
    now a NAND2; the design goes from 842 to 844 transistors and 210 to 211
    equivalent gates, while the routed core gets SHORTER, 324.9 -> 314.1 um
    (0.5304 -> 0.5128 mm2). In exchange the chip top is the pad ring and the core,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
    [assemble_top.py, frame_pins.py, spi_config.py, spi_slave_sclk.v]
2026-09-08 Route the core to the GIO pad ring
    24 signal nets plus power, drawn onto layout/chip/step2_routed.gds. The ring
    engine is the I2C project's, copied verbatim -- perimeter_s, s_to_xy,
    ring_waypoints, project_to_R, seg_layer, unroll, and the greedy interval
    packing. 36 routes (24 nets plus 12 pad-to-pad chain links) fit in 13 lanes
    between R=847 and R=911.8.
    What is new is the corridor under the core. The I2C core filled its frame, so
    a pin on its bottom edge dropped straight into the bottom channel; this core is
    314 um tall in an 1840 um opening with PTECT -- a keep-out the deck enforces on
    every routing layer -- filling the space below. Eleven of the 24 nets come out
    of the bottom edge a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
2026-09-08 Generate the pin assignment table
    docs/pin_list.md: the 14 signal pads and the two power pads, with bond
    coordinates, edge, role, direction, the core net behind each of P/OUT/HIZ, and
    the clockwise pad order a board needs.
    Generated rather than typed, and cross-checked while it builds: bond pad
    coordinates come from the OSS_PAD instances in the frame GDS and the labels
    sitting on them, roles and nets from gio_connections.json, directions from the
    core netlist's own port declarations. A pad the connection map does not
    mention, or a core port with no pad and no entry in the unconnected list, stops
    the script rather than leaving a blank cell.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
2026-09-08 Put LVS pins on the bond pads
    layout/chip/step3_top_pins.gds adds the sixteen chip-level pins the LVS run
    needs a name for: a 3.0 x 3.0 um box on M2PIN (49,1) with the pin name as 20 um
    text on TXM2 (49,0) at the box centre. Same convention the core cell uses and
    the I2C chip used for its own top level; the label goes at the centre because
    KLayout's text extraction wants it inside the box, and an offset label was a
    real bug there once.
    Coordinates and names are read from the frame GDS -- each OSS_PAD instance
    gives a centre, the P<n>/VDD/VSS label sitting on it gives the name. The I2C
    script walked the sixteen centres counter-clockwise from (-200,1040) and
    assigned names by position inste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
    [add_top_pins.py, add_top_pins_gio_v9.py, check_chip.py, set_top_pin_text_size.py]
2026-09-08 Generate the chip-level LVS reference netlist
    layout/chip/tr_1um_3wire_SPI.spice, and the same file beside the cell exports
    in the xschem simulation directory. The chip is two subcircuit instances and a
    port list: OSS_FRAME_GIO (44 ports, transistor level) and the core (27 ports,
    already LVS-clean on its own), under a top subckt declaring all sixteen
    bond-pad ports.
    Sixteen because the layout has sixteen. KLayout's cross-reference wants the
    reference and the layout to agree on that count before it will attempt the
    graph match at all -- the I2C project dropped two pins from its own list once
    and every other pin cascaded into a spurious mismatch while all 27 sub-circuits
    still matched clean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
2026-09-08 Verify the whole chip in ngspice at transistor level
    The three logic views (RTL, post-synthesis, P&R netlist) all replace the
    pad cells with a Verilog 1'bz. This runs the real OSS_ESD_5V_DIO devices
    with the PDK models, so a pad polarity error, a driver fight or a level
    that never reaches a rail is visible for the first time.
    gen_chip_sim_ready.py the LVS netlist, made readable by ngspice. Five
    mechanical fixes and nothing else: M->X (the
    PDK's PMOS/NMOS/MPE/MNE are .subckt, not .model),
    rx_data[0] -> rx_data_0, a *.PININFO "+"
    continuation, the ESD diodes' A=/P= -> AREA=/PJ=,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
    [check_chip_sim.py, gen_chip_sim_ready.py, gen_chip_tb.py]
2026-09-08 Simulate the extracted layout, not just the netlist about it
    gen_chip_sim_ready.py converts the reference netlist -- the "should be"
    side that LVS compares against, built from the Verilog and the cell
    schematics. gen_sim_from_extracted.py converts the other side: what
    KLayout actually found in the GDS. LVS says the two match as graphs;
    only the extraction carries the layout's own numbers.
    Every device arrives with its measured diffusion area and perimeter
    (AS/AD/PS/PD), where the reference netlist lets the PDK fill in
    w*sdwidth and 2*(sdwidth+w). Diffusions shared between abutted cells in
    a row are counted once rather than twice, so the junction capacitances
    -- and the delays -- are the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
2026-09-08 Replace the extracted-netlist log with the design machine's own run
    Both committed ngspice logs are now runs from the design machine:
    23.0 s for the extracted netlist against 24.0 s for the reference, which
    is what you would expect -- same devices, only different parasitics.
    12/12 PASS, and comparing the two native runs measure by measure the
    largest difference across all 54 is 0.69 mV, on sdio_hiz_after_read
    (+0.00001 V -> -0.00068 V). The drawn junction capacitances move no
    decision.
    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
2026-09-08 Measure how fast the part will actually run
    The functional sign-off runs at 1 MHz, which says the chip works and says
    nothing about the rate it works up to. sweep_sclk.py drives the same
    twelve checks up the frequency axis until they break.
    The useful output is not the ceiling but WHICH check fails first, because
    each one names a different path. Here it is unambiguous: at 17 MHz only
    read_byte fails, while rx_wr1/rx_wr2 keep passing to 32 MHz. The shift
    register, the bit counter and the whole input path run at 32 MHz; only
    the output path is slow. The failure mode is textbook too -- at 18 MHz
    read_byte reads 0x1E, which is 0x3D >> 1: at every rising edge the master
    is still seeing the p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
    [gen_chip_tb.py, sweep_sclk.py]
2026-09-08 Refresh both logs from the design machine, with the timing measures in
    Both runs re-done on the design machine against the committed testbenches,
    so the logs and the .spice files correspond again: 12/12 PASS, 24.0 s for
    the reference netlist and 23.3 s for the extracted one.
    These are the first committed logs to carry the clock-to-out measures, and
    they confirm the numbers the sweep was run on to three significant figures:
    reference extracted delta
    tco_sdio_r1 38.55 ns 37.10 ns -1.45 ns
    tco_data 27.90 ns 27.55 ns -0.35 ns
    The extracted netlist is the faster of the two, which is the right way
    round: the PDK fills AS/AD per device as w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
2026-09-08 Write the README, and fix the numbers it turned up
    README.md was still the MPW template's. Replaced with a project README
    following TR-1um_I2C_2026's structure: pin table, chip overview with the
    phase status, RTL, AP&R, DRC/LVS, the ngspice verification, the measured
    SCLK rating, the directory layout, how to run each stage, MPW submission,
    and an index into design_notes.md. Section 2 carries the Chip Image slot
    (docs/Chip_Image.png, not committed yet).
    Fact-checking every claim against the files rather than the notes found
    four things the notes had wrong, all from the option-C re-synthesis
    (design_notes.md 16.6) not being carried back into section 5:
    - the final cell table still listed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
2026-09-08 Bring VSS to its own bond pad, drop PTECT, add the logo
    The GND legs used to hop sideways from the U-corridor bus to the ring's
    GND terminals at (-+921.7, 600). That IS the VSS net -- the frame ties
    its GND terminals to the VSS pad internally, so the extraction has always
    put the core's ground and the VSS bond pad on one net, which is why LVS
    passed -- but it makes the core's return current travel a quarter of the
    way around the ring before it reaches the pad. Rebuilt the I2C way:
    core bottom GND taps -> the 10um M1 bus at y=463 (kept)
    -> one M2 leg down each side at |x| = 838
    -> a second 10um M1 bus bar at y=-795 across the die
    -> five 10um M2 strips at x = -200 +- {0,12,24}
    ->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
2026-09-08 Export the MPW submission, and get down to one top cell
    The chip had seventeen top-level cells: the layout had picked up the whole
    standard-cell library and both spare frame variants along the way, and
    nothing instantiates them. scripts/pre_check.py -- the submission's own
    gate, first thing in the CI workflow -- requires exactly one.
    place_logo.py now prunes them as part of the final assembly: 17 top cells
    down to 1, 62 cells down to 44. Pruning only removes cells that are not
    instantiated anywhere, so the geometry under the top cell is untouched and
    the DRC/LVS result you just confirmed cannot have moved.
    That leaves pre_check's other frame rule -- a cell named OSS_FRAME or
    OSS_FRAME_TEG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
    [tr_1um_username.sch]
2026-09-08 Add the chip image and fill the README's last hole
    docs/Chip_Image.png is the KLayout view of the submitted
    src/tr_1um_3wire_SPI.gds -- pad ring, the core along the top edge, and the
    two OpenSUSI logos below it. README section 2 has been pointing at this
    path since it was written; the placeholder TODO comment is gone now that
    the file is there.
    Also ignoring src/*.extracted: KLayout writes it beside the GDS when LVS
    runs on the submission copy, and it is a byproduct nothing in the repo
    reads. The working extraction the ngspice flow does consume,
    layout/chip/tr_1um_3wire_SPI.extracted, stays tracked.
    Claude-Session: https://claude.ai/c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
2026-09-15 config.py — 59.4 版で作り直すための設定（合成と STA まで）
    `TR-1um_SCLK_SPI` は行高 **64.8 µm の旧 STDCELL** で作られている。正本は
    59.4 なので**行高が違う = 配置も配線も別物**になり、提出済みの GDS とは
    突き合わせられない。合成からやり直し、判定は DRC / LVS / ngspice / STA で取る。
    - `SYN_TOP` / `STA_CLK_PORT = "sclk"` / `STA_FALSE_PATH_FROM = ["rstn"]`
    - コア幅は **296 トラック = 1598.4**。旧 1620.0（300）は TAP の上限 1614.6 を
    超えていて、最終間隔 540.0 が実測ピッチ 534.6 を超えたまま提出されている
    - `N_ROWS` / `CH_HEIGHTS` は**合成と STA を回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
2026-09-15 config.py のパスを仮の名前に
    公開リポジトリに個人のディレクトリ構成（~/Dropbox/…）を書かない。
    ~/Dropbox/91_OpenPDK -> ~/HogeHoge/OpenPDK
    ~/Dropbox/98_LSI_Design -> ~/HogeHoge/LSI_Design
    docstring の使用例だけで、動作は変わらない（パスは TR1UM_PDK と
    APRtools の隣で解決する）。
    Claude-Session: https://claude.ai/code/session_01RqLcTeCZewb2mqdXqqEVwF
2026-09-15 個人のパスを残さない — 仮名 ~/HogeHoge/ と $TR1UM_PDK へ
    ドキュメント・コメントは仮の名前（~/HogeHoge/OpenPDK, ~/HogeHoge/LSI_Design）
    に置き換え、**実行に使うパス**は仮名化せずに削除して $TR1UM_PDK 経由に
    した（死んだ仮名を候補リストに残しても役に立たない）。
    残っているのは生成物だけ（*.synlog / xschem 由来の *.cir, *.spice の
    `** sch_path:` 見出し）。これは回した記録なので書き換えない。
    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
2026-09-15 59.4 版で合成しなおす — RTL/ゲート TB 各 11 本 PASS、STA 36.35 MHz
    sh $APRTOOLS/syn/syn.sh で通した（引数も環境変数も無し）。
    RTL TB 11/11 PASS
    合成 52 セル -> dedup 52 -> 畳み込み 37 -> BUFTH 3 本 = 40 セル
    面積 132,795 um2（旧 64.8 版の提出 134,078 から -1.0%）
    ゲート TB 11/11 PASS（畳み込み後のネットリスト）
    STA 最小周期 27.512 ns = 36.35 MHz、hold +5.381 ns
    セルモデルは手書きの hdl/cells_sim.v をやめて char/mkcellverilog.py の
    生成物に切り替えた（cells_sim.v に INV_X2 が無かった。U38）。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
2026-09-15 59.4 版で作り直した — DRC 0 / LVS 一致 / ngspice 12 項目 PASS
    提出済みの 64.8 版は reference/v64_8/ に丸ごと残した（README 参照）。
    ## 結果
    | 段 | |
    |---|---|
    | 合成 | 52 -> dedup 52 -> 畳み込み 37 -> BUFTH 3 = **40 セル / 132,795 um2** |
    | RTL TB | 11/11 PASS |
    | ゲート TB | 11/11 PASS |
    | STA | 最小周期 27.512 ns = **36.35 MHz**、hold +5.381 ns |
    | 配置・配線 | step1〜10。短絡 0 / 25 ポート全接続 |
    | コア | **1598.4 x 308.7 um**（旧 1620.0 x 1329.6。面積 2.154 -> 0.494 mm2） |
    | チップ | verify_chip すべて OK（24 ネット独立、電源はフレームまで） |
    | DRC | コア 0 / チップ 0 / MDP 0（KLay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
2026-09-15 コアを上面へ、下に全幅ロゴ 2 枚 / トップセルを tr_1um_jun1okamura_3wire_spi へ
    ## 1. トップセル名
    命名規則は tr_1um_<GitHub 名>_<設計の識別子>（info.yaml の注記）。
    提出時の tr_1um_3wire_SPI は **GitHub 名が入っていなかった**。
    info.yaml / hdl の構造トップ / LVS・sim ネットリスト / src/ まで揃えた。
    提出済みの 64.8 版（旧名）は reference/v64_8/ にそのまま残してある。
    ## 2. フロアプランを提出時の絵に戻した
    中央寄せだったコアを**上面へ寄せ**、空いた下に**全幅のロゴを 2 枚**積んだ
    （提出済みの 64.8 版と同じ絵）。
    コア 1611.0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
2026-09-15 64.8 版の STDCELL を reference/v64_8/lef/ へ — selfcheck が すべて OK に
    lef/ に行高 64.8 のセルライブラリが残っていて、selfcheck.py が毎回
    [ NG ] TR-1um_STDCELL.gds **不一致** old=bf90355a new=a7c5bda8
    を出していた。正本は v59_4 で、いまのフローは APRtools の stdcell しか
    読まない。**出しっぱなしの NG は本物の不一致を埋もれさせる**ので、
    64.8 のライブラリ 6 ファイルを reference/v64_8/lef/ へ移した。
    64.8 世代のスクリプト 12 本の参照も向け直した（build.sh / place.py /
    spi_config.py / gen_liberty.py / cell_usage.py / gate_count.py /
    explore_rows.py / sync_cell_i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
2026-09-15 掃除: TB から機械依存の絶対パスを外す（U24）+ 記録の仮名化（U35）
    scripts/gen_chip_tb.py: TB の隣に models.spice（.include '<PDK>/…' 1 行）
    を書き起こし、TB 自身は .include 'models.spice' だけにする。
    他機でもそのまま読める。生成物なので .gitignore へ。
    ngspice を回し直して 12/12 PASS。
    reference/ の凍結 TB と xschem 由来の *.cir / *.spice に残っていた
    個人のホーム配下の実パスを落とした。非コメント行は .include 3 行のみ。
    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
2026-09-16 手順から cd - を外す（サブシェルにする）
    cd - は直前のディレクトリとの往復なので、2 回続けて打つと戻ってしまう
    （2026-09-16 に実際に踏んだ）。( cd layout/chip/simulation && ngspice ... )
    と括弧で囲めば cd はサブシェルの中だけで終わり、呼んだ側のカレントは動かない。
    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
2026-09-16 TB の共通部分を chip_tb_lib へ寄せる（U60 本体）
    寄せたのは 2 つだけ:
    subckt_ports -> tb.subckt_ports（SPI から実体が消えて lib に 1 本）
    write_models_shim -> tb.write_models_shim を呼ぶ薄い層
    （SPI の呼び出し形が (out_spice, models) なので）
    ★ pwl は寄せない。SPI は「t - tr で立ち上げて t には整定済み」（クロック端で
    サンプルするため）で、TD4 の「t で遷移を始める」とは意図して違う。時間の
    単位も違う（秒 / ns）し、末尾に tend の点を足すかどうかも違う。同じ名前
    だからと寄せると、落ちずに刺激の時刻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
2026-09-16 抽出ネットリストを追跡から外す（KLayout の版で中身が変わる）
    *_sim.spice と *_extracted.spice が追跡されていたが、.gitignore には
    入れてあり矛盾していた（gitignore は追跡済みファイルに効かない）。
    調べたら、同じ GDS でも KLayout の版で中身が変わる:
    コミット済み == この環境（module 0.30.12）
    手元の Mac（0.30.9）だけ 300 行違う
    この環境で 2 回続けて抽出すると同一なので、実行ごとの非決定ではなく
    版の違い。素子数はどちらも 182 で、差はポート / ネット名の並びに見える
    （両方の版で ngspice 12/12 PASS しているので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
2026-09-16 config: 配置シードの選び方を明記する（U61）
    選んだ値の隣に「どう選んだか」を 1 行で書く規約
    （$APRTOOLS/docs/21_flow_place.md §7）。値は変えていない。
    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
2026-09-16 config: cnt_rstn がフレームごとに解除されることを明記する（U8）
    STA_FALSE_PATH_FROM = ["rstn"] の隣に「recovery 未特性化」としか
    書いていなかったが、この設計のリセットは電源投入時だけではない。
    wire cnt_rstn = rstn & ~cs_n;
    最終ネットリスト out/spi_slave_sclk_pnr.v で確認: 20 個の FF のうち
    4 個（_78_ / _87_ / _88_ / _89_ = bit_cnt[2:0] と msb_done）が
    RSTB=cnt_rstn で、cs_n の立下りごとに解除される。
    解除から最初の sclk 取り込み端までは半周期（scripts/gen_chip_tb.py の
    clock_frame() が t0 + TH、TH = TCK/2。実測上限 36.35 MHz で 13.76 ns）
    あり実チップ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
2026-09-16 手順とエラーメッセージから仮名を追い出す
    `~/HogeHoge/...` は本物に見える偽物なので、読んだ人はそのまま貼る。
    config.py / layout/chip/simulation/README_tb.md のコマンド行と、
    scripts/spi_config.py が **エラーで出す見本**を山括弧にした
    （貼れば構文エラーで止まる）。記録（sch_path の見出し、凍結した
    reference/）は仮名のまま。
    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
2026-09-17 MUXDFFRB の修正を反映して作り直した（U78）／正規化 md5 4dc966be -> 3272eff7
    標準セル MUXDFFRB の PMOS 拡散が折り返された（総 W は同じ）ので、その
    15 インスタンスぶんだけチップが変わった。
    ★ **配置も配線も 1 ビットも動いていない。**
    layout/ の JSON は 1 つも変わらず、コア GDS をセル単位で突き合わせると
    中身が違うのは **MUXDFFRB 1 セルだけ**（トップセルも他の 53 セルも完全一致）。
    検証:
    cmp_gds（コア） 4 層だけ (3,1) 62 / (8,1) 37 / (11,0) 630 / (13,0) 47
    cmp_gds（提出） 4 層だけ (3,1) 60 / (8,1) 30 / (11,0) 630 / (13,0) 45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
2026-09-17 .gitignore を 3 設計で揃える（U83）
    道具（drc_pdk / lvs_pdk / route / mklib）の生成物を知っているのが
    I2C の .gitignore だけだった。A「どの設計でも道具が作るもの」を 3 設計で
    バイト単位に同一（md5 c7d14cac）にし、B「この設計だけ」を分けた。
    A には道具ごとの由来をコメントで付けた。行末コメントは付けない。
    .gitignore 自身を無視する 1 行目は何もしていなかったので外した。
    ★ 和集合にはしていない。追跡済みのファイルに当たる規則は足さない
    （足しても追跡は外れず「無視されているのに履歴にある」状態を作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
2026-09-17 生成物 4 種を 3 設計とも無視に揃える（U83）
    同じ道具が作るものを片方の設計で追跡・片方で無視していた 4 つを、
    設計者判断で全部生成物扱いにした。共通ブロック A に移し、追跡して
    いた分は git rm --cached（ファイルはディスクに残る）。
    layout/step6/ route.py step6 が毎回作る
    layout/chip/*.extracted gen_chip_sim_ready が klayout_extract を呼ぶ
    layout/chip/simulation/*.log ngspice の実行ログ
    layout/chip/simulation/*_sim.spice gen_chip_sim_ready が作る
    どれも流れの中の段が書き直せることを確かめてから外した。
    共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
2026-09-17 59.4 の標準セルで合成から作り直した（U32）
    旧 STDCELL（行高 64.8）で作った提出物とは配置も配線も別物なので、
    **合成からやり直して DRC / LVS / ngspice で判定する**方針（U32）。
    ここまでがクラウドと Mac で出来たぶん。
    ## 合成（Mac）
    `syn/syn.sh` 9 段。**40 セル / 132,474 µm²**、TB は RTL / ゲートとも 11/11。
    STA は `reg->reg` 27.514 ns = **36.35 MHz**（周期 100 ns 制約、`sclk` 単独）。
    提出済みの 64.8 版は 41 セル / 134,078 µm²。
    ## 配置（`PLACE_SEED = 1` -> `3`）
    seed 1〜6 を振って、(1) チップの電源ストリップ束 3 つがコア上辺のポートと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
2026-09-17 .gitignore: IRSIM の実行ログを無視する（U83 の共通ブロック）
    irsim/run_*.sh が毎回上書きする生成物。3 設計とも同じ行を足した。
    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
2026-09-18 用語: net は日本語で「ネット」（「網」を使わない）
    2026-09-18、設計者指示。ネットリストの `net` は日本語でも **ネット**。
    「網」は使わない。4 リポジトリで一括置換した。
    ★ **`網羅`（coverage）は別の語なので置換しない。**
    `reference/` と `legacy/` は凍結物なので対象外。
    規約は APRtools の `docs/04_naming.md` §0。
    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
2026-09-18 config.py: APRtools が PYTHONPATH に無いときに読める形で止める
    `scripts/check_chip_sim.py` を素で叩いたら
    `ModuleNotFoundError: No module named 'config_base'` の生トレースバックで落ちた。
    `PYTHONPATH` が通っていないだけなのに**何を export すればよいか分からない**。
    `config_base` の import を受けて、`APRTOOLS` と `PYTHONPATH` の 2 行を出す。
    否定対照（PYTHONPATH 無し）で発火、通常経路で素通りを確認。
    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
2026-09-18 特性化の作業場を追跡から外す（U93）
    APRtools 自身が `char/pack*/` `char/decks/` `char/logs/` を**元から無視して
    いる**。設計側が追跡していたのは `scripts/char/` の下の**まさに同じ 3 つだけ**
    で、`.py` も `char/*.json` も `cells_*` も入っていなかった。
    つまり「生成物か記録か」は**既に答えが出ていた** — APRtools の扱いに合わせた。
    これらは回した機械の作業場を指す `.include` を持つので、**追跡ファイルに
    本物のホームパスが入る**原因になっていた（TD4 14,248 / I2C 140 件）。
    ファイルはディスクに残る（追跡をやめただけ）。
    `.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
2026-09-18 APRtools と同名の写しを消した（U94）
    **設計側の `scripts/` にある APRtools と同名のスクリプトのうち、
    どこからも呼ばれていないものを消した（17 本）。**
    判定は「呼ばれているか」で機械的にやった:
    起点 = `scripts/` の**外**にある追跡ファイル（docs / README / *.sh /
    config.py / hdl / irsim …）
    そこから `python3 … <名前>` `sh … <名前>` `./<名前>`
    `import <名前>` `from <名前> import` を辿って**推移的に**到達できるものを
    「現役」とし、**到達できない同名だけ**を消した。
    ★ **設計固有のスクリプトは、到達できなくて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
2026-09-18 out/abc.constr を無視する（U99）
    ABC の制約は syn.sh が .lib から起こす生成物になった。
    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
2026-09-18 STA のログを残す（U99 / 新しい .lib と set_load で回し直した）
    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
2026-09-18 同名の写しに残す理由を書く／古い klayout_extract を薄皮に（U94）
    `apr/check_copies.py` が同名の写しを「同一 / 古いだけ / 設計固有 / CI」に
    分けるようになった。**危ないのは「古いだけ」だけ**（U89 / U14 の形）。
    残す理由は `# copy: ok <理由>` で写しの中に書く。
    TD4 / I2C の `scripts/klayout_extract.py` は**移行前の版**（正本の
    `--no-combine` が無く combine_devices() を常に掛ける）だったので、
    正本を importlib で**ファイルとして**読む薄皮に置き換えた。
    `build()` は旧写しと正本でバイト単位で同一なので LVS の結果は変わらない。
    Co-Au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
2026-09-18 .frozen-paths を置き、移植の島に凍結物の README を足す（U93）
    当時の作業場の絶対パス（/sessions/…）は「機能する道」ではなく「当時の記録」
    なので書き換えない（U35 の決着）。ただし legacy/ や reference/ と違って
    場所を動かせないので、`.frozen-paths` に**理由付きで**登録して数えない。
    外したものは本数と理由が毎回出る。
    `lef_parser.py` の注記は path-ok。これで 4 リポジトリとも 0 件。
    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
2026-09-18 gen_chip_tb.py に --default-tol を足す（U43 の実験用）
    収束用の `.options` を**入れない**で回せるようにした。U43 の元の問い
    「なぜ 64.8 版では既定で通ったのか」は成り立たない（3 設計とも v59_4 で、
    比べていた相手は reference/v64_8/ = 提出済みの凍結物）ので、
    「**いまのネットリストは既定の許容差で通るか**」に置き換えた。
    ★ 検算: 旗を付けない出力は**いま動いているチップ TB とバイト単位で同一**
    （差分 0 行）。旗を付けたときの差は .options の行だけで、判定の JSON は同一。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
2026-09-18 U43 決着 — 収束用の緩和は要らなかった。既定を ngspice の既定に戻す
    既定の許容差でチップ TB を回したら **24 秒で完走し 12/12 PASS**。
    「59.4 版は既定だと t≈0.41us で進まない」はもう当てはまらない。
    緩めた側の方が**精度は低い**ので、通るなら緩めない方を既定にする。
    緩和の影響も測った:
    tco_* が 25〜49 ps（約 +0.1 %）動く
    電圧は µV 台でしか変わらない（ほぼ 0V の残差 29 個は nV 台で意味を持たない）
    → 「判定は 2.5V しきい値なので影響なし」は正しかった。
    ただし**今まで数字で言えていなかった**。
    `--d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
2026-09-18 .frozen-paths の理由文から絶対パスの literal を外す
    理由文に `/sessions/…` と書いたせいで `check_no_home_paths.py` 自身が
    それを数えていた（検査の設定ファイルが検査に引っかかる形）。
    意味は変えずに literal だけ落とした。
    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
2026-09-19 README: 道具の正本は TR-1um_APRtools にあると冒頭に書いた
    clone した人が、この repo の scripts/ を「いま手入れされている道具一式」と
    読んでしまわないように。書いたこと:
    * 配置配線・チップ組み立て・DRC/LVS・特性化は APRtools の apr/ に集約
    （地図は apr/README.md）。新しく作るならそちらから
    * ここに残るのは 3 種類 — 設計固有（config.py / TB の刺激 / パッド割り当て）、
    CI が直接呼ぶ 2 本（pre_check.py / read_info.py）、当時の記録の写し
    * **同名のファイルがあっても手入れが続いているのは APRtools 側だけ**
    * APRto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
